jeroenweij/ClimateControl/Hardware/Damper/Assembly images/Full Bottom.png

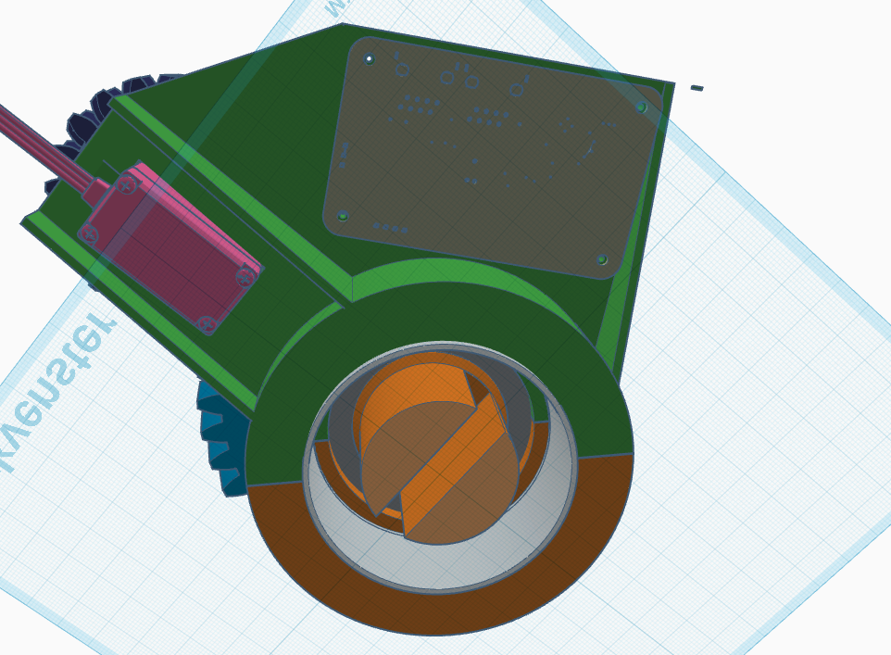
Hardware/Damper/Assembly images/Full Bottom.png
