jeroenweij/ClimateControl/Software/tools/README.md

# Factory tooling

## Provisioning a node's identity

Each `ControllerNode` / `TemperatureNode` gets a one-time 32-byte `ConfigRecord`
written to flash at `0x0800F000` (Config A page). It holds the permanent bus
address (`NodeId`) and module type; firmware only ever reads it
(`NodeLib::ConfigStore`). See `Spec/Node-Flash-Layout-and-Bootloader-Spec.md`
§6.3.

A `Thermostat` is **not** provisioned: every unit carries the same fixed record
(`nodeId = NodeLib::THERMOSTAT_NODE_ID`, module Thermostat), which the build
merges into `thermostat-full.hex`. `make -C Software flash-full MODULE=thermostat`
is the whole bench step, and `provision.py` refuses `--module thermostat`
(`Spec/ControllerNode-Thermostat-Link-Spec.md` §5.2.1).

### Per board

```
# 1. bootloader + application, once per board type (identical across units)
#    Release by default -- add BUILD_TYPE=Debug for a debug unit instead.
make -C Software flash-full MODULE=temperatureNode

# 2. identity, once per unit
Software/tools/provision.py --node-id 7 --module temperature
```

Leave out `--node-id` and/or `--module` and `provision.py` asks for them
(device menu: ControllerNode / TemperatureNode, then the node id).

To do step 1 in the same run, add `--flash-full`: once the config page is
written it runs `make flash-full` for that module (`--build-type Debug` for a
debug unit). `--no-flash-full` skips it, and with neither flag an interactive
run asks (default no). Step 1 coming after step 2 is fine: `flash-full` only
loads the bootloader + app sectors and leaves the config page alone.

`flash-full` builds into `Software/build/release/` (or `build/debug/` with
`BUILD_TYPE=Debug`) and merges bootloader + app before flashing -- see
`make -C Software help` for the equivalent `flash` (app only, no bootloader
merge) and plain `build`/`release` targets. `provision.py` itself doesn't
care which build type the board was flashed with -- it only ever touches the
32-byte config page below, never the application image.

`provision.py` builds the record, writes `config-nodeN-<module>.hex` + a J-Link
commander script, then runs `JLinkExe` to erase the config page and program it.
`JLinkExe` must be on `PATH`; with `--dry-run` (or if it is missing) the files
are written and the command is printed for you to run by hand.

Options: `--settings <hex>` (up to 16 bytes of per-node config), `--serial`
(pick a J-Link by serial number), `--out-dir` (keep the generated files),
`--force` (allow a non-bus-node module type).

### Just the blob

`gen_config_record.py` emits the record without touching hardware:

```
tools/gen_config_record.py --node-id 7 --module temperature            # Intel HEX to stdout
tools/gen_config_record.py --node-id 7 --module temperature -o cfg.hex
tools/gen_config_record.py --node-id 7 --module temperature --bin -o cfg.bin
```

The CRC-32 is a plain `zlib.crc32` — the same reflected CRC-32 the firmware
recomputes at boot (`ConfigStore::Valid`).
