jeroenweij/ClimateControl/Spec/MainController-Server-Link-Spec.md

# MainController ↔ Server Link — Design Spec

`MainController` relays `NodeLib` v2 frames verbatim between the RS485 node bus and a single LAN server; the server decodes, stores to SQLite, and serves the operator web application.

**Companion docs:** `MainController-Spec.md` §4 (NINA-W152 hardware), `RS485-Node-Protocol-Spec-STM32G030.md` §3 (frame format, reused on this link), `Node-Message-Model-Spec.md` §3–§5 (endpoints, operations, encodings — the server decodes these), `Node-Flash-Layout-and-Bootloader-Spec.md` §6 (the bus OTA sequence this link feeds).

---

## 1. Role & topology

`MainController` is bus master, supervisor, and a frame bridge to one server:

- **Bus master** — runs the `NodeMaster` discovery + round-robin poll loop.
- **Supervisor** — its own fault detection / safe-state / aggregation logic (`MainController-Spec.md` §2), running independently of the uplink.
- **Bridge** — holds one outbound TCP connection to the server and moves `NodeLib` frames across it in both directions. It does not decode endpoint payloads, hold a schema, or serialise anything; the server owns all persistent state and the UI.

```
   RS485 bus (115200, half-duplex, HW-DE)              LAN (Wi-Fi)
 ┌───────────┐  ┌───────────┐  ┌───────────┐   ┌──────────────┐        ┌──────────────┐
 │Temperature│  │Controller │  │Controller │   │ MainController│  TCP   │    Server    │
 │  Node  3  │──│  Node  5  │──│  Node  7  │───│  NodeMaster   │═══════▶│  decode + DB │
 └───────────┘  └───────────┘  └───────────┘   │  + AT bridge  │        │  + web app   │
                      │  Thermostat link        │  ── NINA ──   │       └──────┬───────┘
                      └── (local, off-bus) ─    └──────────────┘         WebSocket + HTTP
                                                                        ┌──────┴───────┐
                                                                        │   browsers   │
                                                                        └──────────────┘
```

- The socket is **outbound from `MainController`** — no inbound port or firewall exception at the building.
- **Plaintext TCP on the LAN.** Authentication is a 16-byte shared token in the first frame (`UplinkHello`, §5); the server drops any connection whose token does not match.
- The bus runs normally while the uplink is down: nodes are autonomous, each `ControllerNode`↔`Thermostat` loop is local, and the `MainController`'s supervisory logic keeps running. The uplink carries logging, monitoring, and operator control only — never a closed loop.

---

## 2. Properties of frame pass-through

| | |
|---|---|
| STM32 flash | Reuses `Frame` / `Message` / `Id` / `Crc`, already linked. No JSON writer, no schema, no per-endpoint marshalling on the MCU. |
| STM32 SRAM | Working set is one frame in + one frame out (~40 B each) plus the AT line buffer. The MCU holds no model of the building. |
| Evolution | A new endpoint or value type is a server-only change; the bridge carries it with no firmware update. |
| Single decoder | The `Node-Message-Model-Spec` decode lives in exactly one place — the server — and serves both stored history and the live UI. |

The server implements the `NodeLib` wire format (§6); it is a small, fixed, already-specified codec.

---

## 3. Transport — NINA socket

- NINA-W152 on USART2, u-connectXpress AT firmware, 115200 8N1, 4-wire hardware flow control (RTS/CTS per `MainController-Spec.md` §4) — the STM32 must hold `NinaRts` (`PA1`) low or the module never transmits.
- **Wi-Fi join:** `AT+UWSC=0,2,"<ssid>"` / `AT+UWSC=0,5,2` (WPA/WPA2-PSK) / `AT+UWSC=0,8,"<passphrase>"` configure station profile 0; `AT+UWSCA=0,3` activates it. `+UUWLE` (link up) / `+UUNU` (IP up) report readiness; `+UUWLD` / `+UUND` report loss and drive the same reconnect logic as the socket below.
- **Socket:** u-connectXpress models the server as a **peer**, not a BSD-style socket — there is no `+USOCR`/`+USOCO` family on this firmware. `AT+UDCP="tcp://<host>:<port>/"` opens it: `+UDCP:<peer_handle>` on write, then an unsolicited `+UUDPC:<peer_handle>,<type>,<flags>,<local_ip>,<local_port>,<remote_ip>,<remote_port>` once the TCP handshake completes. `ATO` then switches the UART into **data mode** — a transparent byte pipe to the connected peer — for the life of the connection. `+UUDPD:<peer_handle>` reports a close (drops the module back to command mode); `AT+UDCPC=<peer_handle>` closes it explicitly.
- The **AT engine is a non-blocking state machine** ticked from the same super-loop as `master.Loop()`: it issues one command and returns, collecting the response over later iterations. A stalled uplink never delays a bus `Poll` / `Done`.
- **Events are judged by where they end up.** URCs arrive in bursts (IP up, down, up again), so each waiting state drains every queued event and decides on the end state: a network-down that was followed by a network-up does not fail the attempt, and before the IP is up only the timeout fails the wait. The peer closing (`+UUDPD`) is always final.
- **The network is given time to settle before the peer is opened.** After `+UUNU` the module is not yet ready for `AT+UDCP` — it answers `ERROR` until a second `+UUNU` fires, 0.3–0.9 s later on the bench. The link therefore waits for a 1 s stretch with no network event (any further one restarts the wait) before `AT+UDCP`, and re-sends a command that got `ERROR` or no reply only after 500 ms rather than back-to-back, so its three attempts span the window instead of finishing inside it. Network events seen before Wi-Fi is (re)activated belong to the module's previous life — one can still arrive just after the reset line is pulled — and are discarded, so they cannot stand in for the new connection's own `+UUNU`.
- **Liveness in data mode is a decoded frame, not a byte, and a keepalive must be answered.** Once the peer is gone the module is back in command mode and can answer stray writes with text (`ERROR`, `+UUDPD`); those bytes must not keep a dead link alive. The MC sends a `Keepalive` `Get` every 10 s and the server answers each with a `Keepalive` `Report`. Only that `Report` counts as the answer: other inbound frames (an OTA transfer's writes, say) prove only that the server can still reach the MC, which stays true when the module has stopped forwarding the MC's bytes. If no `Report` arrives within 10 s of a keepalive the link is treated as dead (a dropped peer, a half-open connection, a one-way stall, or a server that is up but not answering) and the NINA is reset and re-joined — within 20 s at worst, whatever the module does or doesn't signal. A 60 s stretch with no valid frame at all is a backstop behind that.
- **Every session opens with the `UplinkHello`.** The server rejects a connection whose first frame is anything else. When a session starts, whatever was staged for the previous one (a keepalive queued as its deadline expired, frames from the moment data mode was entered) is dropped and the hello is queued first, followed by the roster.
- **Reconnect:** exponential backoff, 1 s → 30 s cap, re-triggered by `+UUWLD` / `+UUND` / `+UUDPD`. The MCU keeps no uplink send queue — a `Report` produced during an outage is dropped; the value re-reports on its next change or periodic refresh, leaving only a gap in stored history.

---

## 4. Wire format over the socket

Byte-for-byte the RS485 v2 frame (`RS485-Node-Protocol-Spec-STM32G030.md` §3):

```
SYNC(0xEE 0x42) · LEN · NODE · ENDPOINT · OPERATION · DATA[LEN] · CRC16
```

CRC-16/CCITT-FALSE over `NODE..DATA`, little-endian. `LEN` ≤ 35 (`MAX_DATA`, `RS485-Node-Protocol-Spec-STM32G030.md` §7/§9). TCP is a stream, so the server runs the same `Frame` deframer (SYNC scan → LEN → CRC) as a node; a sync loss just resynchronises. No length prefix or envelope is added.

Two frame classes share the link:

| Class | `ENDPOINT` | Meaning |
|---|---|---|
| **Relayed node frame** | `0x10`–`0x5F` | Verbatim copy of a frame on / for the bus. `NODE` is the real node id. Server `Get` / `Set` go onto the bus unchanged; node `Report` / `Ack` / `Nack` go up unchanged. |
| **Uplink frame** | `0x60`–`0x6F` | `MainController` (`NODE = 0`) ↔ server only, never on the RS485 bus. Roster, presence, keepalive, health, OTA control/data (§5). |

Transport verbs (`Discover` / `Announce` / `Poll` / `Done`) are bus-internal and not relayed. Node arrivals and departures reach the server as `NodePresence` (§5).

---

## 5. Uplink endpoint block (`0x60`–`0x6F`)

`NODE = 0`, little-endian per `Node-Message-Model-Spec.md` §5.

| Endpoint | Dir | Op | Payload | Meaning |
|---|---|---|---|---|
| `0x60` `UplinkHello` | MC→S | `Report` | `fwVersion(2) · uptimeSec(4) · nodeCount(1) · authToken(16)` | First frame after every (re)connect. Connection is dropped on token mismatch. `fwVersion = 0` identifies MainController's bootloader (it carries no version of its own; every application image has a non-zero one): the server then shows the MainController as `bootloader` with an unknown version, and treats the bus as unmanaged — every bus node reads offline, exactly as with no uplink at all — while still accepting a firmware push. |
| `0x61` `Roster` | S→MC / MC→S | `Get` / `Report` | Report: `{nodeId(1) · module(1) · state(1) · lastSeenMs(4)}`, one node per frame, `nodeId = 0xFF` terminates | Full active-node table. Streamed unsolicited after `UplinkHello` and on request. The server treats each stream as a snapshot: at the terminator, any node it has flagged online but the stream left out goes offline (dumping a roster re-seeds `MainController`'s presence tracking, so no `NodePresence` down follows for a node that dropped while the uplink was down). `lastSeenMs` is `MainController` uptime-ms at last contact (relative — the MCU has no wall clock). |
| `0x62` `NodePresence` | MC→S | `Report` | `nodeId(1) · module(1) · up(1) · bootloader(1)` | A node joined discovery (`up = 1`) or missed its heartbeat (`up = 0`); `bootloader` mirrors `Roster`'s per-node bootloader bit at the moment of the transition, for a live update between `Roster` snapshots. |
| `0x63` `ThermostatStatus` | MC→S | `Report` | `controllerNodeId(1) · linkUp(1) · blState(1) · fwMajor(1) · fwMinor(1) · uid[12]` (17 B) | The paired Thermostat behind one ControllerNode — link state + running firmware + identity. On change + slow keepalive; the MC fills it from `Get RoomLink` + `Get ThermostatFirmware`. See `ControllerNode-Thermostat-Link-Spec.md` §5.6. |
| `0x64` `Keepalive` | ↔ | `Get` / `Report` | none | Idle liveness, 10 s interval. A keepalive not answered (by any valid frame) within 10 s triggers reconnect (§3). |
| `0x65` `OtaControl` | S→MC | `Set` / `Get` | `Set`: `op(1)`, `op=1` (`Begin`) followed by `imageSize(4) · imageCrc32(4) · fwVersion(2)`; `op=2` (`Abort`), `op=3` (`End`), `op=4` (`Activate`) take no further payload. `Get`: none. | MC-self-update control channel — **only MainController's own bootloader speaks this** (`Software/Modules/MainBootloader/Firmware.cpp`), never the running app, never a bus node. See §8 step 7. |
| — | MC→S | `Ack` / `Nack` | `lastError(1)`, `0` on `Ack` | Reply to a `Set` above. |
| — | MC→S | `Report` | `state(1) · expectedOffset(4) · lastError(1) · fwVersion(2)` | Reply to `Get` — lets the server resume after a dropped uplink without resending from offset 0. |
| `0x66` `OtaData` | S→MC | `Set` | `byteOffset(2 LE) · data(≤32)` | One flash-write chunk, sent only while the bootloader is `Receiving` (after `OtaControl[Begin]`, before `[End]`). No RAM page buffer — each chunk is programmed to flash immediately, mirroring the bus `Firmware[Write]` design (`Node-Flash-Layout-and-Bootloader-Spec.md` §6.2.1). |
| — | MC→S | `Ack` / `Nack` | `byteOffset(2 LE) · chunkCrc16(2 LE) · programFailed(1)` | Reply to a chunk — echoes the offset + a flash-read-back CRC16, same correlation the bus protocol uses; a `Nack` names where the bootloader actually is so the server can resync without guessing. |
| `0x67` `MainStatus` | MC→S | `Report` | `rxFrames(4) · crcErrors(4) · resyncs(4) · txDrops(4) · downlinkDrops(4) · wifiRssi(1, int8) · freeHeap(2)` | `MainController` + bus health, ~10 s. `downlinkDrops` counts commands shed by the outbound queue (§7). |
| `0x68` `MainLog` | MC→S | `Report` | `uptimeSec(3 LE) · text(≤32)` | One line of MainController's log, pushed unsolicited (§5.1). |

Firmware pushes to a bus node do **not** go through this block — see §8. `Firmware` (`0x20`) and `ThermostatFirmware` (`0x22`) are ordinary relayed endpoints (block `0x10`-`0x50`, §4), so the server drives the OTA sequence directly against them — the MC needs no OTA-specific code for that case, since the generic relay already carries it both ways. The one target the relay can't reach is MainController itself (§8 step 7): it does not run the bus `Firmware` protocol at all, it has its own dedicated bootloader (`Software/Modules/MainBootloader/`, `Node-Flash-Layout-and-Bootloader-Spec.md` §7/§7.1) that speaks `OtaControl`/`OtaData` above instead.

### 5.1 MainController log (`MainLog`)

MainController has no hardware debug console (both USARTs are committed, `MainController-Spec.md` §5), so its log reaches the operator over the uplink instead — the same lines a bus node exposes through `DiagLog` (`Node-Message-Model-Spec.md` §3), but *pushed*, because the MC (unlike a bus node) has an always-on link to the server and nobody has to poll for it.

- **Source.** Every `LOG_*` macro goes through `Tools::Logger::Emit`, which records the line in `Tools::LogRing` — the same fixed ring every bus node has: 24 lines, each `"<level>: <message>"` truncated to 32 characters and stamped with the MC's uptime in seconds and then calls the console sink `Logger::Write`, which on the MainController is empty unless the RTT option below is enabled.
- **Push.** Once the uplink is in data mode, `UplinkHandler` moves lines from the ring into its outbound queue as `MainLog` `Report`s, at most four per super-loop pass and only while the queue is under half full, so log traffic never displaces relayed bus frames. The drain path never logs itself. Lines logged before the link is up (Wi-Fi/NINA bring-up, boot) wait in the ring and flush right after the `UplinkHello`; if the ring overflowed meanwhile the first line is `~ <n> lost`.
- **Time.** The frame carries the MC's uptime, not wall-clock time. The server places a line at `helloWallTime − helloUptime + lineUptime`, using the `uptimeSec` in the `UplinkHello` that opened the connection.
- **Server.** The server keeps the most recent 500 `MainLog` lines in memory (not in SQLite), streams each to the browser over the websocket as it arrives, and serves the buffer at `GET /api/main/log`. The **Logs** page lists the MainController next to the bus nodes and shows its log live, with no *Follow* polling.
- **When the uplink is down.** Only the ring (the last 24 lines) holds the log, and it is read once the MC reconnects — sized to hold a complete NINA bring-up (~17 lines, ~23 when it also switches Bluetooth off), so it shows why an attempt failed *if* the MC eventually connects. A unit that never connects is diagnosed with the RTT option or the bootloader-style LED codes.
- **RTT (bench backup, off by default).** The CMake option `CC_MC_LOG_RTT` (default `OFF`) compiles a minimal SEGGER RTT control block (`_SEGGER_RTT`, one up-channel, one idle down-channel; `Software/Modules/MainController/RttLog.cpp`) into `mainController` and makes `Logger::Write` write each line to RTT up-channel 0 in non-blocking skip mode (`NO_BLOCK_SKIP`: a line that does not fit in the free space is dropped whole), so it can never stall the super-loop. It needs no pin, no UART and no extra hardware beyond the J-Link already used for flashing (`JLinkRTTClient` / `JLinkRTTLogger`), and costs ~0.6 KB of SRAM for the control block and a 512-byte up-buffer when enabled — nothing when off. A bit-banged UART on a spare pin is not used: at 9600 baud it busy-waits ~1 ms per character and stalls the bus loop. PA5 (the `ONEWIRE` net) is unused on the MainController.
- **Bootloader.** `MainBootloader` has no log (`Tools::Logger` is not linked, to stay inside the 10 KB budget); it reports through its LEDs only.

### 5.2 MainController status (`NODE = 0`)

A relayed-range endpoint (`0x10`–`0x5F`) addressed to `NODE = 0` is for the MainController itself and never goes onto the bus — there is no node `0` there. `UplinkHandler` answers these for itself, in the same payloads a bus node uses (`Node-Message-Model-Spec.md` §3, built by the same `Node` helpers):

| Endpoint | Op | Answer |
|---|---|---|
| `SystemControl` | `Set` | reset to app (`1`) / bootloader (`2`), §8 step 7 |
| `SystemStatus` | `Get` | `Report`: `state` and `errorFlags` 0 (none defined for the MainController), its uptime and reset cause |
| `DiagLastError` | `Get` | `Report`: the fault that last reset it — HardFault (with the faulting PC) or watchdog — from `Hal::Fault` (`Node-Flash-Layout-and-Bootloader-Spec.md` §5) |
| `DiagReset` | `Set` | clears that fault record, `Ack` |

Anything else, or the wrong verb, is `Nack`ed. The server asks for `SystemStatus` and `DiagLastError` once each time the MainController application connects (a reset always reconnects) — not its bootloader, which answers neither. It stores the replies under node `0` in `readings` and publishes them to the browser, but keeps node `0` out of the bus-node roster; the status page shows when the MainController started, the reset cause, and the last fault, and the server logs a warning when a fault is reported.

---

## 6. Server architecture

One long-running process on a LAN host (Pi / NUC / mini-PC), under systemd. A single binary with the web UI embedded. It has four responsibilities and exposes three network surfaces on one HTTP port.

### Responsibilities

1. **Accept** the `MainController` TCP connection and validate its `UplinkHello` token.
2. **Deframe and decode** the frame stream → `{node, endpoint, operation, value, ts}`, where `ts` is the server's wall clock at receipt and `value` is decoded per `Node-Message-Model-Spec.md` §5.
3. **Persist** every `Report` that changes a value to SQLite and update a **current-state cache** (last value per `{node, endpoint}`) held in memory.
4. **Serve** the web application and **push** every value change to connected browsers.

It also tracks node presence from `Roster` / `NodePresence`, composes downlink frames for operator actions and OTA (§7, §8), and re-asserts stored overrides when a node rejoins.

### Network surfaces

| Surface | Path | Purpose |
|---|---|---|
| App bundle | `GET /`, `/assets/*` | The compiled single-page app (`index.html` + JS + CSS). Downloaded once per browser session. |
| JSON API | `GET`/`POST /api/*` | Everything that is not a live value: history queries, commands, node status, config, map setup, the firmware repository + updates (`/api/firmware*`). Request/response over SQLite + the state cache. |
| WebSocket | `GET /ws` | The live channel. On connect the server sends a full current-state snapshot; thereafter it pushes one message per value change for the life of the socket. A measurement (`RoomTemp`, `RoomHumidity`, `SupplyTemp`, `ReturnTemp`) not refreshed for 4 minutes is dropped from the live state with an `expired` message: nodes stop sending a reading they no longer have rather than marking it invalid, and a live one repeats at least once a minute. |

### Data flow — a node value reaching the browser

```
NINA TCP socket → deframe → decode → ┬→ SQLite  readings row
                                     ├→ current-state cache
                                     └→ WebSocket broadcast → every open browser → re-render the one changed element
```

End-to-end latency (node `Report` → browser update) is sub-second on the LAN.

### Browser application

A single-page app. After the initial bundle load it runs entirely client-side:

- Opens `/ws`, applies the initial snapshot, and renders the map and tables with no loading state.
- Applies each incremental `{node, endpoint, value, ts}` push to the single affected element — no reload, no polling.
- Calls the JSON API for non-live actions: history graphs (`GET /api/readings?node=&endpoint=&from=&to=`), overrides (`POST /api/commands`), the firmware repository + updates (`GET/POST /api/firmware`, `POST /api/firmware/update[-all]`), map edits (`POST /api/map/*`).
- Command outcomes (`Ack` / `Nack` / the resulting `Report`) return over the same WebSocket, so every UI update flows through one path.

The operator pages (§7) and the map-setup page are routes within this one app.

### Database (SQLite)

```
nodes(id PK, module, uid, fw_version, first_seen, last_seen, state)  -- fw_version from SystemInfo
readings(ts, node_id, endpoint, raw BLOB, value_num, value_text)   -- indexed (node_id, endpoint, ts); the last rawRetentionDays
readings_hourly(node_id, endpoint, hour, min, avg, max, n)         -- numeric history beyond that, one row per series-hour, kept for good
readings_rollup(node_id, endpoint, rolled_to, last_ts, last_num)   -- per-series rollup progress + the value holding at rolled_to
commands(ts, node_id, endpoint, operation, payload, user, sent_ts, ack_ts, result)
ota_jobs(id PK, node_id, target, filename, size, crc32, fw_version, module, started, finished, state, last_offset, error, image_path)
                                                                   -- target 'node'|'thermostat'; state 'queued' until the single-flight driver picks it up
firmware_images(module PK, filename, version, size, crc32, uploaded_ts, image_path)  -- one held image per module; version = major<<8|minor, parsed from the filename
thermostats(controller_node_id PK, uid, fw_version, bl_state, link_up, last_seen)    -- from 0x63 ThermostatStatus
config_overrides(node_id, endpoint, value, user, ts)               -- re-asserted when the node rejoins
map_floors(id PK, name, image_path, width_px, height_px)
map_placements(node_id, floor_id, x_px, y_px, poly_json NULL)      -- one row per ControllerNode
```

**Readings history.** The stored history is step-shaped: each row's value holds until the next row. A node re-reports every published value about once a minute as a keepalive (`Node-Message-Model-Spec.md` §6); a report whose raw bytes equal the series' last stored row is not stored unless that row is 30 minutes old, so rows are the changes plus at least two per hour while the node is reporting. The last-stored cache is in memory, so each series stores one extra row after a server restart.

Rows are kept as is for `rawRetentionDays` (config, default 30). An hourly job (and one pass at start-up) folds everything older — up to the hour boundary at or below now − retention — into `readings_hourly` and deletes it, one day of one series per transaction so the uplink's inserts are never held off for long. Per hour: `min` / `max` over the values present in it, `avg` weighted by how long each value held, `n` the raw rows inside it. A value holds until the next row or for one hour at most — a reporting node leaves a row every 30 minutes, so a longer silence is the node being gone, and an hour with no known value gets no row. `readings_rollup` records per series how far it has been rolled and the last value before that point, which still holds into the next pass's first hour; each chunk's hourly rows, deletions and progress commit together, so an interrupted pass neither loses nor repeats an hour. Only numeric rows (`value_num` set; enums included, where only `min`/`max` mean anything) are rolled up; text / struct rows such as `SystemStatus` are dropped with the rest. The hourly table is kept indefinitely — about one row per series-hour, so a building's worth of nodes adds on the order of 100 MB a year. SQLite reuses the freed pages, so the file levels off at about one retention window of raw rows rather than shrinking.

`GET /api/readings` returns a series newest first: the raw points in range, then the hourly points further back (`num` = the hourly mean, with `min` / `max` / `n`).

### Frame codec

One server-side module implements the `NodeLib` wire format: the `Frame` deframer (SYNC scan → LEN → CRC-16/CCITT-FALSE → `{node, endpoint, operation, data}`) and the matching encoder for downlink frames. Endpoint payload decoding is a table keyed by endpoint, following `Node-Message-Model-Spec.md` §5.

---

## 7. Operator pages

| Page | Server | Frames on the link |
|---|---|---|
| **Building map** — floor plan, live per-room temperature (§7.1) | renders from the state cache, live-updates over `/ws` | none beyond the node `Report`s already arriving |
| **Overrides** — change setpoint / damper mode / any writable endpoint | composes `Set <node> <endpoint> <value>`; writes `config_overrides` for the held endpoints only (below) | downlink `Set` → node `Report` / `Ack` → cache + push |
| **Status** — per-node module / fw / live values (damper as `actual → target` while a move hasn't landed) / faults / bus counters | shows `SystemInfo` / `SystemStatus` / `DiagRxCounters` / `MainStatus`; the **Fault** column shows the node's active `errorFlags` by name, and after they clear the last one raised with its time (kept in server memory, not persisted) | pushed `SystemStatus` on change; on-demand `Get` downlink |
| **Logs** — one log view per node: the MainController's live, a bus node's read on demand or followed | MainController: the in-memory `MainLog` buffer + `/ws` push (§5.1); bus node: drains its `DiagLog` ring | MainController: none beyond the pushed `MainLog` `Report`s; bus node: `Get DiagLog` downlink, one per line |
| **Firmware** — installed version per node (+ a row per Thermostat), the held image per module, per-node / "update all" push | `SystemInfo` fw + `0x63` + `firmware_images`; accepts a `<Module>_<major>.<minor>.bin` | single-flight OTA queue, OTA sequence (§8) |
| **Map setup** (separate config page) | per-floor floor-plan image upload; click to place each `ControllerNode`; optional room outline, traced by flood fill from a seed point on the plan or drawn as a manual polygon | none |

When a node rejoins, the server re-applies any matching `config_overrides` (a rebooted node returns at defaults). Only the damper overrides (`DamperTarget`, `DamperMode`) are held. Settings a node persists in its own flash (`DumpRoom`, the calibration offsets) are sent once and not held, and so is `RoomSetpoint`: the Thermostat is its source of truth and its buttons change it, so a held value would only fight them. Each room's setpoint field starts at the reported setpoint and can be sent any number of times. The held damper overrides follow the node's own rule that a `DamperTarget` Set means Manual: holding a target also holds `DamperMode` = Manual, and holding any other mode drops the held target — so re-applying them (target first, by endpoint order) can't contradict itself.

### 7.1 Building map render

- Each **`ControllerNode`** is one placed point, coloured by its relayed `RoomTemp` (`0x41`), labelled `RoomTemp / RoomSetpoint` (`0x40`), with `RoomMode` (`0x43`) and `RoomLink` (`0x44`) as badges.
- **`TemperatureNode`s** are duct sensors (`SupplyTemp` / `ReturnTemp`) near the outside unit — shown in a fixed readout on the map or status page, not placed on the plan.
- The plan is an uploaded image; the live layer is an **SVG overlay rendered in the browser**. Per node, at its `(x_px, y_px)`:
  - default — a marker plus a soft radial-gradient blob, room-sized radius, colour from a temperature ramp (blue 16 °C → green 21 °C → red 26 °C); overlapping blobs blend into a heatmap.
  - if `poly_json` is set — fill that polygon at ~30 % opacity for a crisp room boundary.
- Multi-floor buildings have one `map_floors` row per floor and a floor switcher on the page.
- The temperature ramp and thresholds are server-side UI config.

### 7.2 Downlink rate discipline

The bus is a round-robin poll cycle into which the master injects its own `Set`s. Rapid UI writes (a slider drag) could back up that injection and starve the poll cycle. Two layers bound it:

- **Server** — debounce per `{node, endpoint}` (send only the latest value after a ~200 ms settle) and cap total downlink at ~10 `Set`/s.
- **`MainController`** — a bounded outbound-to-bus queue (~8 frames); on overflow it drops and increments `downlinkDrops` in `MainStatus`. The uplink never delays a bus `Poll` / `Done`.

---

## 8. Firmware update

Drives the bus OTA sequence in `Node-Flash-Layout-and-Bootloader-Spec.md` §6 **directly** — `Firmware` (`0x20`) is an ordinary relayed endpoint (§4), so the server is the one running this state machine, addressing the target node id over the socket exactly like any other `Set`/`Get`. The MC does no OTA-specific translation for this path; it's the same generic relay it already does for `SystemInfo`, `DamperTarget`, etc.

1. Operator uploads `<module>.bin` on the Status page. The server validates the `ImageDescriptor` (magic, module, size) and computes the CRC-32.
2. Server → bus (relayed): `Set Firmware[EnterBootloader]` addressed to the target node id (the app parks outputs, sets the backup magic, resets — `INodeHandler::PrepareForReset`). Server then polls `Get Firmware` on that node id until it gets back any `Firmware Status` Report — only the bootloader ever sends one, the running app only `Ack`/`Nack`s `Firmware`, so any reply confirms the reset landed.
3. Server → bus: `Set Firmware[Begin] {module, imageSize, imageCrc32, fwVersion}`; the node erases its app slot and reports `bl-receiving`.
4. Server streams `Set Firmware[Write] {offset(2 LE), bytes=32}` with 4 chunks in flight (go-back-N, `otaNodeWindow`), each answered by that write's own `Ack`/`Nack` (echoing the offset + a flash read-back CRC16) rather than a generic `Firmware Status` Report — the reply is tied to the specific write (`Node-Flash-Layout-and-Bootloader-Spec.md` §6.2). Acks are cumulative; a `Nack` names the offset to resync to; no progress for the write timeout resends from the oldest unacked chunk. Keeping several chunks in flight keeps the uplink busy — one chunk per ~140 ms round trip is the cadence at which the NINA stops forwarding (§11 item 1) — and roughly quadruples throughput (~300 B/s on the bench). A Thermostat push stays at one chunk in flight: its ControllerNode relays one at a time. Delivery still rides the target's normal poll window.
5. At `imageSize`: `Set Firmware[End]` → poll for `bl-valid` → `Set Firmware[Activate]`. The node clears its magic, resets into the new app, re-announces; the server reads the new `fwVersion` from `SystemInfo`.
6. **Thermostat target** — same steps 3-5, but addressed to `ThermostatFirmware` (`0x22`) on the *owning ControllerNode's* node id instead of `Firmware` on the target's own id, and step 2 is skipped: `ThermostatFirmware[Begin]` does the `EnterBootloader` + bootloader-wait itself, CN-side (`ControllerNode-Thermostat-Link-Spec.md` §5.4).
6a. **A bus push survives the uplink going quiet.** The bus node (or the Thermostat behind a ControllerNode) is untouched when the module stalls and the MainController resets its NINA, so it keeps everything it has received. When a chunk stays unanswered through its retries the server waits for the uplink to return (up to 120 s), probes `Firmware[Get]` (`ThermostatFirmware[Get]` for a thermostat push) and continues from the `expectedOffset` the bootloader reports. A bootloader holding no transfer (`Idle`: it restarted) is sent `Begin` again and the image starts over; a node that answers nothing for 90 probes is presumed to have booted its application and is sent `EnterBootloader` and `Begin` again (not for a thermostat push, whose `Begin` does that CN-side). Bus pushes send one chunk at a time; acks ride the bus poll cadence, so the window used for the MainController's own update does not apply.
7. **`targetNodeId == 0`** — MainController self-update, a different mechanism entirely, **not** an extension of steps 1-6. Not reachable via any relay (the MC doesn't relay to itself). The server first parks the running app in its bootloader with `SystemControl[Set] {2}` addressed to `NODE=0` — the app's `UplinkHandler` handles a `NODE=0` `SystemControl` itself instead of relaying it onto the bus; it Acks, sets the backup-register magic and resets. The bootloader (`Software/Modules/MainBootloader/`) dials the uplink back out itself, sends a fresh `UplinkHello`, and answers `OtaControl[Get]` with a status `Report` — the server polls for that (any report proves the reset landed; the running app ignores `OtaControl`). Then server → `OtaControl[Begin]` → `OtaData` chunks (each acked, same offset-resume semantics as the bus's `Firmware[Write]`; up to 4 in flight at once, go-back-N: an ack for a chunk also covers every chunk before it, a `Nack` names the offset to restart from — repeats of it are ignored briefly, since one loss draws a `Nack` from each chunk sent behind it — and no ack progress for 3 s resends from the oldest unacked chunk) → `OtaControl[End]` (verifies) → `OtaControl[Activate]` (resets into the new app), all addressed to `NODE=0` on the uplink block itself (§5). The uplink drops when the app resets into the bootloader and again during `Activate`'s reset, reconnecting each time with a fresh `UplinkHello` (the bootloader's reports `fwVersion = 0`). A transfer also survives the link going quiet: the module can stop forwarding the MC's bytes for tens of seconds, after which the MC resets the NINA and reconnects while its bootloader keeps everything received so far. When a chunk stays unanswered through its retries the server waits for the uplink to return (up to 120 s), probes `OtaControl[Get]`, and continues from the `expectedOffset` it reports; a bootloader that has lost its state (`Idle`) is sent `Begin` again and the image starts over. An ack is matched to the chunk by offset, so a late ack for an earlier chunk is ignored. The server driver is `Webserver/internal/service/ota_main.go`.

The STM32 working buffer for this is small: a `Write` payload is 35 B (`MAX_DATA`, `RS485-Node-Protocol-Spec-STM32G030.md` §7), and the bootloader stages no RAM page buffer at all — each `Write` is programmed to flash immediately.

---

## 9. STM32 code / RAM budget

| Piece | Flash | SRAM |
|---|---|---|
| AT command / response / URC engine | ~2–3 KB | ~0.3 KB line buffer |
| Socket bridge (open / reconnect / two `Frame` pumps) | ~1–2 KB | ~0.1 KB |
| `0x60` block handlers (roster, presence, keepalive, status) | ~1 KB | — |
| `MainLog` drain (§5.1) + the MC-sized log ring | ~0.3 KB | ~1.1 KB (32 × 32 B lines + stamps) |
| **Total** | **~4–6 KB** | **< 1 KB** |

Firmware pushes cost the MC nothing beyond the generic relay it already has — no separate OTA glue line item (§8).

`Frame` / `Message` / `Id` / `Crc` / `NodeMaster` are already linked.

---

## 10. Failure modes

| Event | Behaviour |
|---|---|
| Uplink down | Bus and supervisory logic keep running. The MainController's error LED is on steady until the uplink is back. `Report`s during the outage are lost, not queued. On reconnect: `UplinkHello` → server pulls `Roster`, issues `Get`s to refill the state cache, re-asserts `config_overrides`. The refill asks for each module's state endpoints (`service/refill.go`): on a `Roster` entry only those the cache has no value for (this also covers a restart of the server itself, whose cache is memory-only), on a `NodePresence` up all of them. The `Get`s are paced ~25 ms apart so the MainController's 25-deep bus queue isn't flooded. |
| Server restart | Same as uplink down, from the MC's view. |
| NINA wedged | AT watchdog: no URC / `OK` within a timeout → `RESET_NINA` pulse (PA6, open-drain) → re-init → reconnect. |
| Node drops mid-OTA | The node's app slot is invalid → its bootloader stays resident → `NodePresence` down then up → server retries from `ota_jobs.last_offset`. |
| Bad frame on the socket | Dropped by `Frame` CRC / resync, same as on the bus; counted in `MainStatus`. |
| Out-of-range override | Node replies `Nack`; server shows the reason and does not persist the override. |

---

## 11. Open items

1. **The NINA stops forwarding UART bytes to TCP now and then** — a failure of the module itself, seen on the bare module with no MainController (a PC as server, an adapter on the module's TXD/RXD; rig: `Software/tools/nina_stall_test.py`): the module keeps acknowledging what the server sends and delivers it to the UART, but stops passing what arrives on its UART to the peer, for seconds to minutes until it is reset. It showed up when traffic crosses the module with gaps of about 120 ms or more (request periods of 130–250 ms stalled, most runs within ~2 minutes at 130 ms; 30–110 ms did not), which is the cadence of a stop-and-wait OTA transfer. UART flow control and Wi-Fi power save are not the cause. The same rig, on the same module and firmware (u-connectXpress 6.4.1), no longer reproduces it: 130/160/200/250 ms for 5 minutes each with Bluetooth off and again with it on, plus one unbroken hour at 130 ms with it off (about 41,000 requests in all), gave no stall. So the trigger is still unidentified, and nothing shows whether turning Bluetooth off (`NinaLink` stores `AT+UBTMODE=0` on first bring-up, since u-connectXpress lists Wi-Fi and Bluetooth running together as a cause of disconnections and increased latency) or something in the Wi-Fi environment made it go away. Bluetooth stays off regardless. The link copes if it does come back (an unanswered keepalive resets the NINA within 20 s, and the transfer resumes, §3, §8), but each stall costs a retry or a reconnect. The OTA transfer keeps several chunks in flight (§8 step 7), so the link stays busy and that cadence is avoided in any case. A second failure mode shows up around those resets: the module sometimes boots (`+STARTUP`) and then answers no `AT` at all; only another reset brings it back. `NinaLink` therefore gives the post-reset `AT` probe ~20 s (10 attempts) before resetting the module again, rather than probing indefinitely — unbounded, one such boot kept the uplink down for 7½ minutes.
