jeroenweij/ClimateControl/Spec/Node-Bus-Hardware-Design-Spec.md

# Node Bus — Hardware Design Spec
### Power, connector, and node-schematic decisions for the STM32G031F8P6 RS485 node network

**Companion doc:** `RS485-Node-Protocol-Spec-STM32G030.md` (wire protocol / framing / CRC — this doc is physical layer only)

---

## 1. Topology overview

- 1 master + up to 22 slave nodes (`NodeLib::MAX_NODES`) on a single half-duplex RS485 bus: 21 ControllerNodes and 1 TemperatureNode.
- Physical medium: standard 8-conductor Ethernet patch cable, daisy-chained node-to-node (each node has an "in" and "out" RJ45).
- One cable carries **power, RS485 data, and two control lines** simultaneously — no separate power harness for the common case.
- RS485 data pair runs as one continuous bus end-to-end. **Power is injected at multiple points along the chain, not solely from the master end** — see §4.

---

## 2. Bus voltage: 48V (PoE-class)

The shared power rail runs at 48V DC, stepped down locally at each node to 5V (servo) and 3.3V (MCU).

**Why 48V over 12V/24V:**
- Cable/connector current scales as `I = P / V`. At a fixed servo power draw, 48V draws **1/4 the current of 12V** and **1/2 the current of 24V** for the same delivered power — this is what makes the RJ45 connector current budget (§4) workable at all with 21 servo nodes on one chain.
- Directly comparable to established PoE practice (802.3af/at/bt operate in this voltage class for exactly this reason).

**Consequence — hot-plug inrush:** higher rail voltage means more energy dumped into each node's input bulk capacitor on connection. Addressed by keeping that bulk cap small (47µF) rather than adding an NTC or soft-start MOSFET — see `Node-Bus-Power-Path-Spec.md` §2/§3.

**Consequence — regulator selection:** the 5V rail needs a wide-input **synchronous buck** (not LDO — at 48V→5V an LDO would dissipate ~90% of input power as heat). The 3.3V rail can be a simple buck or LDO fed from the already-regulated 5V rail.

---

## 3. Frame/pin assignment (per RJ45, T568 pairing)

| Pins | Pair (color) | Assignment | Notes |
|---|---|---|---|
| 4, 5 | Blue (center pair) | **RS485 A/B** (differential) | Center pair chosen for tightest coupling of the four pairs and maximum physical separation from both power pairs |
| 1, 2 | Orange | **V+ (48V, bonded)** | Both conductors bonded in parallel — halves effective resistance per rail vs. a single conductor |
| 7, 8 | Brown | **GND return (bonded)** | Symmetric with V+ pair, opposite outer edge of the connector |
| 3, 6 | Green | **ENABLE** (bonded, both wires) | One control line — no separate `NRST` bus (see below). Both green conductors bonded together for ENABLE, same halved-resistance rationale as the V+/GND pairs. |

**ENABLE line:** master-driven only, single driver, no contention — feeds each node's buck-converter EN pin (see `Node-Bus-Power-Path-Spec.md` §5). **Enabled is the default state; the master only ever pulls the line low, to disable.**

**Drive scheme: one pull-up per node, one pull-down at the master.** Each node pulls the ENABLE net up to its *own local 48V rail* through a high-value resistor. The master has a single low-side N-MOSFET that pulls the whole net to GND to disable every node at once. There is no pull-up at the master. A node holds itself enabled from its own 48V and GND, so the shared line — and any IR drop or ground offset along it — never sets the "enabled" level; only the disable edge travels the wire, carrying just the ~1mA total pull-up current, so drop along the ENABLE conductor is a few mV and irrelevant.

| Component | Where | Value | Part | Notes |
|---|---|---|---|---|
| Pull-down MOSFET | master | onsemi BSS123 (N-ch) | LCSC C513249 | SOT-23, 100V Vds (margin over 48V), Vgs(th) 1.7V (full turn-on from a 3.3V GPIO), 170mA (vs. ~1mA needed) |
| Gate series resistor | master | 330Ω | commodity | |
| Gate pull-down resistor | master | 10kΩ | commodity | Holds the MOSFET off if the master GPIO floats at boot → line not pulled low → **bus stays enabled** |
| ENABLE pull-up | each node | **1MΩ** | LCSC `C17927` (`1206W4F1004T5E`, 1206 thick-film, 200V, 250mW, ±1%) | To the node's local 48V input. ~48µA/node; ~0.96mA / ~46mW across a full 20-node bus. Feeds the buck EN pin through a 10kΩ series + 100nF-to-GND filter (~1ms, noise rejection). The filter cap sits at the full ENABLE voltage (~48V), so it must be rated **≥100V**: `CL21B104KCFNNNE`, LCSC `C28233` (0805 X7R). |

**Pull-up value — 1MΩ per node.** Across 20 nodes this parallels to ~50kΩ: ~0.96mA total draw, and a ~0.5ms enable-edge RC against ~10nF of bus capacitance — fine for a slow control line. Lower values just waste power; higher values get noise-sensitive for little gain. The full 48V sits across the pull-up whenever the line is held low, so the resistor's package voltage rating (not its value) is the real constraint — the selected 1206 part is rated 200V.

**Receiving end:** the LMR16030 EN pin tolerates 0–60V with a ~1.2V threshold (datasheet §6.1/§6.5), so no protection is needed. A per-node RC + Schmitt filter is cheap transient-noise insurance but not load-bearing.

**Why no separate RESET line:** power-cycling a node via ENABLE also resets its MCU, making ENABLE a strict superset of a dedicated `NRST` bus — the only thing lost is resetting the MCU *without* dropping node power, which isn't needed here (not battery-powered; the fuse/inrush design already tolerates power-cycling).

**Hard-wired through:** ENABLE passes straight through each node's in/out RJ45, not buffered or re-driven by the MCU, so a master kill works even against hung firmware. Trade-off of the per-node pull-up: if the ENABLE conductor breaks mid-chain, downstream nodes self-enable and the master loses kill authority over that segment — unlikely, since the bonded green pair shares the RJ45 with power, so such a break usually drops that segment's power anyway.

**Note on pair-selection rationale:** at RS485 baud rates, inter-pair crosstalk is not the primary concern this layout solves — that matters far more at gigabit-Ethernet speeds. The real reason to keep the RS485 pair away from the power pairs is broadband switching noise from each node's buck regulator; good decoupling at each node's power input matters more here than which physical pair carries which signal.

---

## 4. Connector current budget — the constraint that shapes the power topology

**Problem:** in a pure daisy chain, the cable segment nearest the master carries the *cumulative* current of all downstream nodes, not just the local node's draw. RJ45 contacts on generic shielded jacks (see §5) are rated **1.5A per contact**; bonding two contacts per rail (as in §3) gives roughly **2–3A of safe headroom per hop** at the head end.

**Servo:** the damper actuator is a DSSERVO `DS3225`, 25 kg·cm metal-gear digital servo (coreless, "waterproof" housing, ~40×20×40.5 mm, 67 g, 180° version). Per the supplier's own spec sheet: operating voltage 4.8–7.2V, stall current 2.2–2.6A @5.0V → 2.8–3.2A @6.8V. At this design's actual 5.0–5.5V working point that interpolates to **~2.6–2.8A/node** working stall current. Run it at this board's existing 5.0–5.5V rail, not higher — the ceiling is the shared-rail LDOs downstream (`Node-Bus-Power-Path-Spec.md` §3), not the servo.

**Linkage:** the servo drives the damper blade (a Lindab DRU, mounted and driven as in `Damper-Mechanics-Spec.md`) through a **2.1:1 reduction** (20 : 42 printed gears): the full servo travel, 0–180° (0–100 %, 500–2500 µs), becomes ≈ 86° of blade travel. The mechanics alone set the end points: at 0 % the blade still leaves a minimum ventilation gap, and at 100 % it stops short of fully open, so the servo never runs into a hard stop at either end. Firmware therefore has no per-unit trim or software end stops (`Modules/ControllerNode/Damper.h`); a stall reported anywhere in the range means a mechanical fault, not an end point.

**At 48V, converted from 5V-side servo current** (`I_bus = P_load / (V_bus × η)`, η ≈ 0.85–0.90 for a synchronous buck):

| Scenario | 5V-side total (21 ControllerNodes) | Actual 48V bus current |
|---|---|---|
| All servos running normally | ~12.6 A | **~1.5 A** |
| All 21 servos stalled simultaneously (worst case) | 21 × 2.7A ≈ 56.7 A | **`(56.7A × 5V)/(48V × 0.875) ≈ 6.75A`** |

Split across the both-ends power injection (mitigation below) that's **~3.4A at each injection point** — at or just past the top of the "~2–3A safe headroom per hop" a bonded-pair connector gives.

**Decision:**
- Normal operation (~1.5A) is comfortably within a bonded-pair connector's safe range — no special handling needed for the typical case. The servo is per-node power-gated (`Node-Bus-Power-Path-Spec.md` §3.1), so both rows above are *transients* bounded by how many dampers move at once; the resting bus current is ~22 × (MCU + transceiver) ≈ tens of mA. The both-ends feed below is headroom for a coordinated multi-damper move.
- Worst-case simultaneous full-stall (~6.75A) can exceed the ~2–3A single-hop connector budget.
- **Mitigation: power injection at both ends of the chain**, not multi-point injection every 4–5 nodes. With the bus length ~100m, feeding both ends splits each node's return current toward whichever end is electrically closer, cutting the worst-case IR drop to roughly 1/4 of the single-end-fed case — see §6 for the RS485 common-mode margin this resolves. Requires an actual physical power connection at the far end of the run (a second supply there, or a dedicated feed cable back to the master). RS485 stays a single continuous bus end-to-end regardless — only the power pairs need the second feed point.
- **Regardless of the above, every node gets a fuse or PTC on its 48V input** — cheap insurance against a single node fault pulling down the shared rail, and it caps that node's worst-case contribution to bus current.

---

## 5. RJ45 connector part

**Hong Cheng HC-WK88-H18-B — LCSC/JLCPCB part C7501838**

| Spec | Value |
|---|---|
| Type | 8P8C (RJ45), single port |
| Magnetics | **None** — plain 8-pin pass-through, no transformer/coil circuitry (a magnetics/transformer jack would block DC power and distort RS485) |
| Shielding | Yes, metal shell (stainless steel) |
| LED | None |
| Mount | Through-hole, right-angle |
| Current rating | 1.5A per contact — matches the connector current budget §4's calculations are based on |
| Voltage rating | 125 VAC RMS (comfortably above the 48V DC bus) |

Two of this same part are used per node (one "in," one "out"), per §1 — using one part number for both keeps the footprint/BOM simple.

**Fallback:** C7501830 (Hong Cheng HC-WK88-H132-55B) — same electrical spec, a different housing variant in the same series, not footprint-interchangeable with C7501838.

Tie the shield to chassis/earth ground rather than signal ground if a separate protective earth is available.

---

## 6. Node core schematic — STM32G031F8P6, transceiver, indicators

This section is the reusable node front-end: MCU support parts, the RS-485 transceiver, status LEDs, and the reset/user buttons. Application-specific pins (servo PWM, sensor front-ends, the `ControllerNode`↔`Thermostat` link) are left to the module specs.

**MCU: STM32G031F8P6.** TSSOP20, 64 MHz Cortex-M0+, 8 KB SRAM, 64 KB flash (room for a bus-resident DFU bootloader + the MainController's NINA-W152 driver), `LPUART1`, `RTC` + backup registers (a wear-free "enter bootloader" flag, and an optional wall-clock if an LSE crystal is fitted), `TIM2` (32-bit), 7 DMA channels. HAL device define `STM32G031xx`. Footprint stays compatible with STM32G031F6P6 (32 KB) as a cost-down fallback.

### 6.1 STM32G031F8P6 support components

TSSOP20: a **single combined `VDD/VDDA` pin (4)** and **single `VSS/VSSA` (5)** — no separate analog supply, no `VREF+` pin (ADC reference is `VDD` directly).

| Net | Parts | Notes |
|---|---|---|
| `VDD` (pin 4) | 100 nF + 1 µF at the pin, plus 4.7 µF bulk on the local 3V3 rail | Standard STM32G0 decoupling; keep the 100 nF loop tight. |
| ADC reference | (none — it's `VDD`) | Matters for `TemperatureNode` if NTC-into-ADC is chosen: LDO ripple sets the temperature noise floor. Consider AP2112 (`C51118`) over XC6206 there. |
| `NRST` (pin 6) | cap to GND + reset button (§6.4) — 100 nF on the MainController, 10 nF on the ControllerNode and Thermostat | Internal ~40 kΩ pull-up present — no external pull-up. Both work for noise filtering and the button; 100 nF is ST's guideline value. |
| `BOOT0` | nothing | Shares the `PA14`/SWCLK pad. Factory `nBOOT_SEL = 1` → boot source is the option byte, pad free as SWCLK, boots from flash. |
| Clock | **HSI16 only, ×4 by the PLL** | No crystal. The applications run SYSCLK/HCLK/PCLK at **64 MHz** — HSI16 through the PLL (×8 ÷ 2), 2 flash wait states (`Hal::System::ClockTo64MHz()`) — except the Thermostat's, which stays at 16 MHz to keep heat off its room sensor (`ControllerNode-Thermostat-Link-Spec.md` §4); the bootloaders stay at 16 MHz, and both the bootloader→app jump and any reset return to it. The PLL does not change the accuracy, which is the HSI16's own: it is ±0.75% trimmed, ±1%/0–85°C, ±2% at −40°C — fine for the bus: an indoor duct/wall sees ~10–40°C where HSI16 holds ≈±1%, so two nodes are ~±2% apart, inside the async-UART framing budget. That budget is a percentage of the bit period, so it holds equally at any baud rate; the bus rate (115 200) is set by signal-integrity margin instead (`RS485-Node-Protocol-Spec-STM32G030.md` §2). 115200 is not an exact integer divisor of the USART clock at either speed (64 MHz/115200 ≈ 555.6 → BRR 556 in the applications, 16 MHz/115200 ≈ 138.9 → BRR 139 in the bootloaders and the Thermostat; both ≈115108 Hz, ≈0.08% generator error) — negligible next to the HSI16 spread itself. Pins 2/3 (`PB9/PC14-OSC32_IN`, `PC15-OSC32_OUT`) can instead take a **32.768 kHz LSE crystal** for the G031 RTC (wall-clock for MainController schedules). On the MainController board `PB9` is the bus-disable output (`RESET_NODES`), so LSE there would need it relocated; on Node/Thermostat boards pins 2/3 are free. Footprint LSE **DNP** on all boards for now. |
| SWD | 5-pin header: `3V3` (Vtref), `SWDIO`=PA13 (18), `SWCLK`=PA14 (19), `NRST` (6), `GND` | No caps on SWDIO/SWCLK. Cortex-M0+ has no SWO/ITM — see §6.5. |

### 6.2 Pin assignment (TSSOP20)

USART1 on port B + PA12, no SYSCFG pad remap needed:

| Pin | Name | Node-core use |
|---|---|---|
| 1 | PB7 | **USART1_RX** (AF0) ← transceiver RO  (Thermostat: **I2C1_SDA** AF6) |
| 2 | PB9/PC14 | free — or **RESET_NODES** bus-disable output (MainController); LSE xtal DNP |
| 3 | PC15 | free (LSE xtal DNP) |
| 4 | VDD/VDDA | 3V3 |
| 5 | VSS/VSSA | GND |
| 6 | NRST | reset button + cap (§6.1) |
| 7–13 | PA0–PA6 | **application** — see per-board split below |
| 14 | PA7 | **activity LED** |
| 15 | PB0…/PA8 mux | **error LED** |
| 16 | PA11 | **user button** (`ErrorHandler` ack) |
| 17 | PA12 | **USART1_DE** (AF1) → transceiver DE+/RE |
| 18 | PA13 | SWDIO |
| 19 | PA14 | SWCLK |
| 20 | PB3/4/5/6 mux | **USART1_TX** = PB6 (AF0) → transceiver DI  (Thermostat: **I2C1_SCL** AF6) |

Pins 1, 15 and 20 each bond several GPIO pads to one physical pin — configure exactly one and leave the rest at reset default (analog-in). Pins 16/17 (`PA11[PA9]`/`PA12[PA10]`) can be remapped to PA9/PA10 via `SYSCFG_CFGR1` `PA11_RMP`/`PA12_RMP`; this plan does not use that.

**Per-board use of pins 7–13 (PA0–PA6):**

| Pin | MainController | ControllerNode ("Node" board) | TemperatureNode | Thermostat |
|---|---|---|---|---|
| 7  PA0  | USART2_CTS (AF1) ← NINA RTS | **servo stall-current sense** (`ADC_IN0`, `Node-Bus-Power-Path-Spec.md` §3.1) | — | — |
| 8  PA1  | USART2_RTS (AF1) → NINA CTS | link DE (AF1) | — | link DE (AF1) |
| 9  PA2  | USART2_TX (AF1) → NINA | link TX (USART2, AF1) | — | link TX (USART2, AF1) |
| 10 PA3  | USART2_RX (AF1) ← NINA | link RX (USART2, AF1) | — | link RX (USART2, AF1) |
| 11 PA4  | — | free (bit-bang debug-TX candidate) | 1-Wire #2 | — |
| 12 PA5  | — | **servo enable** (GPIO out, off by default — `Node-Bus-Power-Path-Spec.md` §3.1) | 1-Wire #1 | — |
| 13 PA6  | NINA RESET_N (open-drain out) | servo PWM (TIM3_CH1, AF1) | — | — |

MainController + TemperatureNode are two populate variants of one PCB (the 48V injection front-end and NINA are DNP on the TemperatureNode build, the 1-Wire front-end DNP on the MainController build). MainController has no spare hardware UART for a debug console (USART1 = bus, USART2 = NINA). The G031's `LPUART1` does not help: on TSSOP20 its TX/RX only reach PA2/PA3 (the PB10/PB11 and PC0/PC1 options are not bonded), i.e. the same pins as USART2. Its log goes to the server over the uplink instead (`MainLog`, `MainController-Server-Link-Spec.md` §5.1), with SEGGER RTT over the SWD header as a bench option — no pin needed.

> **Firmware:** the pin map lives in `Software/Lib/Board/BoardPins.h` (single source of truth). `Hal::UartPins` carries a per-pin AF (`Board::BusUart` = PB6/PB7 at AF0, PA12 at AF1). Pin 15's error-LED pad is picked as **PB0** — configure only that one.

### 6.3 RS-485 transceiver

**Part: THVD2410DR (TI)** — LCSC `C1849398`, SOIC-8. ±70 V fault-protected half-duplex RS-485, 3.0–5.5 V supply (run at 3.3V), 500 kbps, −40…+125°C, ±25 V receiver common-mode range, ±16 kV HBM / ±12 kV IEC 61000-4-2 contact and air ESD on the bus pins, 1/8 unit load, receiver fail-safe (logic high with the inputs open or shorted). A 3.3V supply is required: the RO output swings to the transceiver's VCC and drives the MCU RX pin directly. Standard MAX485/MAX3485 SO-8 pinout (`1 RO · 2 /RE · 3 DE · 4 DI · 5 GND · 6 A · 7 B · 8 VCC`). 500 kbps covers the 115 200 bus baud and both fallbacks (250 000, and 500 000 at the part's limit).

**Why fault-protected:** an RJ45 plug gives no mating order, and the bus puts +48V (pins 1/2) and GND (pins 7/8) on opposite edges of the connector. A plug inserted slightly tilted can mate +48V and A/B before GND. For that moment the node's input stage (SS26A, bulk cap, buck) is powered with no ground return except out through its own A/B pins, so its local GND floats toward +48V and the charging current returns through every other node's transceiver. A standard −7…+12V transceiver (abs. max ≈ −7.5…+12.5V) is destroyed by this, typically failing as a VCC–GND short, and takes neighbouring nodes' transceivers with it. The THVD2410's bus pins withstand ±70V whether powered or not, so with no low-voltage clamp on A/B (see ESD row below) there is no return path: the plugged node's ground simply floats until GND mates, and neither it nor the rest of the bus sees a fault current. The same rating covers a miswired or damaged cable putting +48V on A/B.

**Driver-enable:** use **USART1's hardware DE output** — tie the transceiver's `DE` (3) and `/RE` (2) together and drive from `USART1_DE` (`UART_DE_POLARITY_HIGH`: high = drive, low = listen). The peripheral handles `DEAT`/`DEDT` assertion timing per frame; no `setEnable()`/`delay()` loop needed.

```
 PB7  USART1_RX ───────────────  1 RO
 PB6  USART1_TX ───────────────  4 DI
 PA12 USART1_DE ──┬────────────  3 DE
                  └────────────  2 /RE
                  └── 10k ── GND         (reset-safe: driver stays off while the MCU pin is Hi-Z)
      3V3 ─ 100nF ─ GND ───────  8 VCC / 5 GND
                                 6 A ─[10Ω]─ A ─ RJ45 pin 4 (blue)
                                 7 B ─[10Ω]─ B ─ RJ45 pin 5 (blue)
```

The **10 kΩ pull-down on the DE/RE net is mandatory** — without it an unprogrammed or resetting node can float its driver on and fight the bus.

Per-node A/B passives, fit only where noted, DNP elsewhere:

| Part | Value | Populate |
|---|---|---|
| Fail-safe bias | **None** | not fitted anywhere on the main bus — the THVD2410 receiver is itself fail-safe (logic high with the inputs open or shorted, which covers an idle terminated bus sitting at ~0V A–B), so no board needs a biased idle level |
| ESD/surge | **None external** — the THVD2410's integrated IEC ESD protection (±12 kV contact/air) covers the bus pins. Do not fit an SM712 or any other clamp below ~70V on A/B: it would conduct during a ground-last hot-plug and become the fault path the transceiver is there to block. | DNP on every node (the SM712 footprint, U3, stays empty) |
| Series R | 10 Ω in each of A/B | optional, tames ringing/EMI |

**Termination:** no on-board footprint, no per-node DNP/jumper. 120 Ω A–B termination is provided by a **plug-in RJ45 terminator** (120 Ω across pins 4/5) inserted into the spare "out" jack of whichever node is physically last on the chain. Every node's board is identical here — moving/extending the bus end just means moving the terminator plug, not reworking a board.

**Common-mode range:** THVD2410 receivers operate over ±25V common-mode. Same shared-GND-return exposure as ENABLE. The both-ends power feed (§4) cuts worst-case IR drop to ~1/4 of a single-end-fed estimate, landing around ~0.9V normal / ~3.0V worst-case stall — far inside the window.

### 6.4 Status LEDs & buttons

Driven by `NodeLib`:

`Node`/`NodeMaster` take no pin arguments — they use `Board::ActivityLed` / `Board::ErrorLed` / `Board::UserButton` directly.
- **Activity LED** (`Board::ActivityLed`, PA7 / pin 14) — lit while the node transmits its queued messages (`Node::flushQueue`), off when idle.
- **Error LED** (`Board::ErrorLed`, PB0 / pin 15) — driven by `NodeLib::ErrorHandler`, blinked at 1 Hz on error; if `recoverable`, blinks until the user button is pressed. Outside a fatal error it shows the node's connection, **steady on while it is down** and off while it is up (pin only touched on a change):
  - **Bus nodes and the Thermostat** (every slave `NodeLib::Node`): on until the first `Poll` after boot, and again once polls stop for the 1 s heartbeat window — the same condition that fires `ConnectionLost()` (`Node::ShowBusState()`). For the Thermostat that is its link to the ControllerNode.
  - **MainController** (the bus master, where `Node` leaves the LED alone): on while the uplink to the server is down — not yet up after boot, or lost (`UplinkHandler::ShowUplinkState()`, following `NinaLink::InDataMode()`).
- **User button** (`Board::UserButton`, PA11 / pin 16) — configured `InputPullUp`, so active-low: wire button → pin → GND, 100 nF across it for debounce, optional 100–330 Ω series. Internal ~40 kΩ pull-up is enough for an on-board button; add an external 10 kΩ if it's on a long lead.

All LED GPIOs are push-pull, active-high (`led.Write(true)` = lit). Wire each `pin → R → LED anode, cathode → GND`.

| Board | Error (PB0) | Activity (PA7) | Power (always on, `+3v3`) |
|---|---|---|---|
| MainController | `C2286` KT-0603R red, 0603 | `C389518` MHT192CGCT yellow-green, 568–575 nm | `C916074` TZ-P2-0603YGTCS1 yellow-green, 0603 |
| ControllerNode | `C84256` NCD0805R1 red, 0805 | `C2296` KT-0805Y yellow, 0805 | `C2297` KT-0805G emerald green, 0805 |
| Thermostat | `C84256` NCD0805R1 red, 0805 | `C2296` KT-0805Y yellow, 0805 | — |

All GPIO-driven parts have Vf ≈ 1.7–2.4 V, which is what a 3.3V GPIO through 330 Ω needs to be readable. The ControllerNode's power LED is the one deliberate exception: a 525 nm emerald green (Vf 2.6–3.1 V) runs at only ~0.3–1 mA from `+3v3` through 330 Ω, so it glows dimly — acceptable for a steady power indicator, not for an activity LED that only flashes briefly. On the Thermostat, the two LEDs sit under Bivar `SLP3-150-100-F` light pipes (`B1`/`B2`, ordered but not assembled) that bring them to the enclosure edge.

**Series resistor: 330 Ω** for every indicator LED (red / green / any orange). `R = (3.3 − ~2.0) / I` → ~3.3–4 mA, well inside the 8 mA/pin guideline; the low-mcd parts need the current to be readable. 470 Ω if a softer indicator is wanted. Avoid blue/white/525 nm-green (Vf ≈ 3.1V) on the 3.3V GPIO rail entirely.

Node IDs are **factory-provisioned in flash** (`Node-Flash-Layout-and-Bootloader-Spec.md` §6.3) and reported to the master in the `Announce` reply during discovery — no DIP switch / address strap needed.

### 6.5 Easy-to-forget checklist

1. **Debug output needs a UART pin** — Cortex-M0+ has no SWO; `Tools::Logger` is a weak no-op meant to be routed to a UART. Bring USART2 (PA2/PA3) to a 3-pin header on `TemperatureNode` (the `MainController` needs none: its log goes over the uplink, `MainController-Server-Link-Spec.md` §5.1). On `ControllerNode` both USARTs are used (bus + thermostat link) — plan for sharing.
2. **RJ45 straight-through nets** — 48V (orange 1/2), GND (brown 7/8), A/B (blue 4/5), ENABLE (green 3/6) all pass in-jack → out-jack unbuffered. ENABLE also gets the per-node 1MΩ pull-up to local 48V (§3) and feeds the buck EN pin.
3. **Input protection + regulators** per `Node-Bus-Power-Path-Spec.md` (PTC fuse, 48V TVS, reverse diode, 47µF/100V bulk, LMR16030 buck, LDO, all caps).
4. **100 nF at every VCC pin** — MCU, transceiver, LDO.
5. **Reset-safe I/O** — every MCU output benign at POR. On a `ControllerNode` the servo enable (PA5) defaults off with the pin Hi-Z, so the servo is unpowered at POR / on an unprogrammed board (`Node-Bus-Power-Path-Spec.md` §3.1); keep a light external pull on the servo PWM pin toward the safe position as secondary insurance.
6. **Test points:** 48V, 5V, 3V3, GND, A, B, debug-UART TX, SWD header.
7. **One solid ground pour**; for NTC-into-ADC keep the divider return near the MCU ground pin.

---

## 7. Open items

1. **Whether simultaneous full-stall across all 21 ControllerNodes is a realistic scenario** for this application (e.g. synchronized power-on homing) or a non-issue because servos move independently. Relevant for fuse/PTC and connector-current sizing (§4).
