jeroenweij/ClimateControl/Spec/ControllerNode-Thermostat-Link-Spec.md

# ControllerNode ↔ Thermostat Link — Design Spec

**Companion docs:** `RS485-Node-Protocol-Spec-STM32G030.md` (main bus protocol this link reuses a subset of), `Node-Message-Model-Spec.md` (endpoint/operation model the link shares; `ThermostatFirmware` is defined here in §5.4), `Node-Flash-Layout-and-Bootloader-Spec.md` (§7 Thermostat OTA — the "relay details" it defers are §5 here), `Software-Architecture-Spec.md` (module map)

---

## 1. Topology

Each `ControllerNode` (damper actuator, main-bus slave) has exactly one `Thermostat` (room UI/setpoint) paired to it. That pair talks over a **separate, dedicated link — not the main RS485 bus**:

```
MainController ──(main RS485 bus, many nodes)── ControllerNode ──(dedicated 2-endpoint link)── Thermostat
                                                  ControllerNode ──(dedicated 2-endpoint link)── Thermostat
                                                  ControllerNode ──(dedicated 2-endpoint link)── Thermostat
                                                       ...                                          ...
```

- `ControllerNode` is on the main bus as a normal `NodeLib` slave (node ID `1..N`, per the protocol spec).
- `Thermostat` is **not** addressable on the main bus at all — it only ever talks to its own `ControllerNode`.
- Because the link has exactly two fixed endpoints, the main protocol's *arbitration* (`Discover`/`Announce`, dynamic roster — protocol spec §6) exists to let one master poll an unknown number of slaves fairly, and that problem doesn't exist here. The `Poll`/`Done` transmit-window discipline is nonetheless kept (§5.3): it costs one round-trip per cycle and buys byte-for-byte reuse of the bus bootloader's OTA slave over this link (§5).

---

## 2. What carries over from NodeLib

| Protocol-spec concept | On this link | Why |
|---|---|---|
| `Id`/`Message` framing, CRC16, sync/resync (protocol spec §3–§5) | **Yes** | A clean, corruption-detected frame is worth having on a 2-endpoint link too — no reason for a different frame format. |
| `Endpoint`/`Operation` enums (`Node-Message-Model-Spec.md`) | **A subset** | The **named-endpoint** blocks `System*`, `Room*` (`RoomSetpoint`/`RoomTemp`/`RoomHumidity`/`RoomMode`/`RoomTempOffset`), `DamperActual`/`DamperMode`/`AirMode`, and `Firmware` — same values as the main bus. Never the `Transport` endpoint. Verbs: `Get`/`Set`/`Report`/`Ack`/`Nack`. The **`Thermostat` is the source of truth for `Room*`** and pushes `Report`s; the `ControllerNode` pushes `DamperActual`/`DamperMode`/`AirMode` for the display. See `Node-Message-Model-Spec.md` §7. |
| `Discover`/`Announce` | **Yes, no discovery sweep** | The CN sends a `Discover` after reset and then every 5 s (`LinkMaster::discoverIntervalMs`) to read the Thermostat's app-vs-bootloader `state` from its `Announce`; an app `Announce` also tells the CN the Thermostat may have just booted (§5.3). There is only the one fixed peer, so no address sweep. |
| `Poll`/`Done` transmit-window discipline | **Yes — single-peer** | There is nothing to arbitrate, but this is the discipline the bus-resident bootloader's `FirmwareSlave` speaks, so the same bootloader binary takes an image over this link with no OTA-specific code (§5). The CN runs `LinkMaster` — a single-peer master; the cost is one `Poll`/`Done` round-trip per cycle. |
| Heartbeat / `ConnectionLost()` | **Yes** | Driven off the poll cycle (§5.3): 3 consecutive missed `Done` → `ConnectionLost()`. Surfaced on the main bus as `RoomLink` (0 down / 1 up). |

`Software/Lib/NodeLib` is split into a framing layer (`Frame`/`Crc`/`Id`/`Message`/`EEndpoint`/`EOperation`) and the roles built on it. The **Thermostat** runs the full slave (`NodeLib::Node`) — a point-to-point link changes nothing on the slave side. The **ControllerNode** runs `LinkMaster` on the link (§5.3): `NodeMaster` with discovery and the N-slave roster stripped to a fixed single peer, not the full arbitration state machine. Reusing this discipline rather than a bespoke push/ack exchange is what lets the bus bootloader receive an image over the link with no new transfer code.

---

## 3. Physical layer

**Half-duplex 2-wire RS485 with hardware driver-enable** — the same transceiver and BOM as the main bus. Differential signalling suits the duct-to-wall run, and although a 2-endpoint link has nothing to arbitrate and could run full-duplex or plain UART, the bus-resident bootloader's OTA UART (`Modules/Bootloader/OtaUart.cpp`) drives a hardware DE line and expects `DEAT`/`DEDT` turnaround timing. Matching that here — transceiver DE on `Board::Usart2De` (PA1) — is what lets the same bootloader binary serve a Thermostat image with only a USART-select change (§5.5).

On the ControllerNode this is a *second* RS485 front-end (USART2, PA2/PA3, DE PA1) alongside the main-bus one (USART1); on the Thermostat it is the only link. `BoardPins.h` (`LinkUart`) carries these pins. Bit rate is `Board::BusBaudRate` (115 200), the same as the main bus.

### 3.1 Cable, power, and connector

The Thermostat is **fed from the ControllerNode's own regulated 5V rail** (`Node-Bus-Power-Path-Spec.md` §3 — the same LMR16030 buck output that feeds the CN's own 3.3V LDO and, on a ControllerNode, the servo), not raw 48V and not an independent local supply. On the Thermostat side a `RT9080-33GJ5` (`C841192`, the same regulator as the ControllerNode's) drops it to 3.3V, and a separate 3.8V regulator feeds the OLED's `VBAT` (§4.1).

**Feed protection:**
- **ControllerNode end:** `F2`, a Littelfuse `1206L020YR` PTC (`C207035`, 200mA hold / 420mA trip, 24V, 0.65Ω), sits in series between the CN's `+5V` and connector pin 1. A short anywhere in the wall cable trips it instead of dragging the CN's 5V rail — and with it the CN's MCU and servo — into the buck's current-limit hiccup, so the CN stays up and reports `RoomLink = 0`. 200mA hold is ~2.5× the Thermostat's worst case (§4.5), and still clears it with the hold current derated for a warm duct.
- **Thermostat end:** `F1`, the same `1206L020YR`, followed by a `1N5819WS` series Schottky (`C191023`) for reverse polarity — a miswired cable, which no fuse covers. With the CN-side fuse in place, `F1` only matters when a Thermostat is powered from something other than a ControllerNode (e.g. a bench supply).

- **4 conductors, no separate ENABLE.** `RS485 A`, `RS485 B`, `+5V`, `GND` — that's it. A separate power-kill line from CN to the Thermostat isn't needed: CN can already reset the Thermostat over the link (`Firmware[EnterBootloader]`, §5), a physical reset button already exists on the Thermostat board (inherited from the node-core schematic, §4), and a hung link already parks the damper safely without needing to power-cycle anything (§5.1). Whatever would need a hard power-cycle to recover is already covered when the main bus's shared `ENABLE` kills this CN's own buck — the Thermostat's feed collapses with it for free, since it's downstream of the same rail.
- **Voltage drop margin is not a constraint.** The binding rail is the OLED's 3.8V `VBAT` regulator (§4.1), not the 3.3V one: it needs ~3.9V at its input. From the CN's ~5.3V worst-case-low rail, minus the series Schottky (~0.4V) and both PTCs (~0.1V at load), that leaves ~0.9V for the cable's round trip at the ~80mA worst case (§4.5) — roughly 40m of 26AWG or 65m of 24AWG stranded. That's still well beyond any real duct-to-wall or wall-to-CN run; RS485 itself isn't the limiting factor either. Cable routing and connector cost are what actually bound the practical run, not electronics.
- **Connector: JST-XH, 2.5mm pitch, 4-position** — chosen over RJ45 specifically to keep the Thermostat enclosure compact (§4.6); RJ45's ~16×13.5×20mm mating envelope would blow out the puck's thickness budget. Both ends use the XH family, so one straight-through `XHP-4` cable mates both; pin order is identical at both ends (1 `+5V`, 2 `A`, 3 `B`, 4 `GND`).

  | Role | Part | LCSC |
  |---|---|---|
  | PCB header, ControllerNode (through-hole, top entry) | `B4B-XH-A(LF)(SN)` | `C144395` |
  | PCB header, Thermostat (SMD, side entry — lies flat in the puck) | `S4B-XH-SM4-TB(LF)(SN)` | `C161861` |
  | Cable-side housing | `XHP-4` | `C144403` |
  | Crimp socket contacts (×4/cable end) | `SXH-001T-P0.6` | `C140573` (standard, not the `-N` low-insertion-force variant — this connector is installed once and left, so favor vibration retention over easy insertion) |

  3A/250V rated (far past our ~80mA), 22–28 AWG wire, −25…+85°C — the standard compact XH family (9.8mm mounting height), not JST's bulkier "high box" potted-board variant. Verify the friction latch before ordering at volume — LCSC's own listing metadata tags `XHP-4` as "non-latching," which conflicts with XH's usual friction-latch reputation and isn't contradicted anywhere in JST's datasheet; check a product photo or a sample part.

### 3.2 A/B line passives — reuses the main-bus scheme (`Node-Bus-Hardware-Design-Spec.md` §6.3), same transceiver

The link uses the same `THVD2410DR` (LCSC `C1849398`) as the main bus, so the same passives apply — but simpler, because this link's topology never varies: it is always exactly `ControllerNode` at one end and `Thermostat` at the other, so there's no need for the main bus's DNP-plus-jumper "populate only wherever the physical ends happen to be" scheme. Populate directly:

| Part | Value | Populate |
|---|---|---|
| Termination | 120 Ω across A–B | **both ends, always** — CN's link-side transceiver and the Thermostat's, permanently populated (not DNP; unlike the main bus, which end is "the end" never changes here) |
| Fail-safe bias | A→3V3, B→GND, ~560 Ω each | **once for the whole link, at ControllerNode** (the link's master, `LinkMaster`, §5.3) — not at the Thermostat, and not both: a second bias network would just parallel down and skew the idle point for no benefit. The THVD2410 receiver is itself fail-safe (logic high with the inputs open or shorted), so the bias is belt-and-braces for the idle level rather than required. `R20`/`R21`, `0603WAF5600T5E`, LCSC `C23204` (Basic part) — R20 A→3V3, R21 B→GND, confirmed on the CN-side link net in the netlist. Actual current draw is ~2.8mA (3.3V across the 560+560Ω pair plus the ~60Ω of parallel A-B termination at both ends) — negligible against the rail. |
| Series R | 10 Ω in each of A/B | both ends, recommended (not just optional as on the main bus) — the 4-conductor cable here (§3.1) isn't purpose-made 120 Ω-rated RS485 cable the way the main bus's Ethernet patch cable is treated, so the extra ringing/EMI damping is more likely to matter |
| ESD/surge | SM712 RS-485 TVS, SOT-23-3, pin 1→A, pin 2→B, pin 3→GND | both ends, right at the connector — LCSC `C5199207` (ElecSuper) or `C404012` (genuine Bourns). Unlike the main bus (where any A/B clamp below ~70V is DNP, `Node-Bus-Hardware-Design-Spec.md` §6.3), the highest voltage on this cable is the +5V feed, inside the SM712's −7/+12V non-conducting window — so a hot-plug or ground-last mating can't drive it into conduction, and it adds external ESD margin on top of the THVD2410's own. The Thermostat's connector sits at an exposed wall location, if anything more ESD-exposed than an enclosed duct node. |
| DE/RE pull-down | 10 kΩ, DE/RE net → GND | both ends, mandatory — same reset-safety reason as the main bus: an unprogrammed or resetting node must not float its driver onto the line. |

---

## 4. Thermostat hardware

The `Thermostat` reuses the **STM32G031F8P6** (project MCU) and the node-core schematic from `Node-Bus-Hardware-Design-Spec.md` §6 (MCU support parts, reset button, SWD, indicator LED, the `InputPullUp` user-button pattern) — it just swaps the main-bus RS-485 front-end for the point-to-point link (§3) and adds a display + a second button.

Unlike the other boards' applications it stays at the reset-default **16 MHz** HSI16 (no `ClockTo64MHz()`) and sleeps (`Hal::System::Sleep()`, `WFI`) between main-loop passes, woken by the 1 ms SysTick or a link byte. The MCU's heat lands on the room sensor a few centimetres away (§4.3), and a 2 s sensor read plus a small display need no more. `Hal::I2c` derives its `TIMINGR` prescaler from `SystemCoreClock`, so the bus runs at the same ~98 kHz at either clock.

### 4.1 Display — I²C OLED

**SSD1306 / SSD1315 128×64 mono OLED.** Part: **Wisevision `X096-2864KSWPG01-H30`** (LCSC `C18723026`).
- **True bare COG module** — SSD1315 chip bonded directly to the glass, 30-pin 0.7 mm-pitch FPC tail exposing every controller pin, no PCB, no onboard regulator of any kind.
- **Panel:** 24.7×16.6×1.3 mm outline, 21.74×11.175 mm active area, white — comfortably inside the §4.6 puck enclosure, and white reads more neutral than the common blue hobbyist panels behind a matte-white front.
- **I²C pin strapping** (per datasheet §1.5 Pin Definition): `BS0=0, BS1=1, BS2=0` (tie to `VSS`/`VDD`/`VSS`) selects I²C mode; then `CS#→VSS`, `R/W#→VSS`, `E/RD#→VSS` (all tied low, per the datasheet's serial/I²C note); `D0→SCL`, `D1` and `D2` **tied together→SDA** (the controller uses separate internal SDA-in/SDA-out pins that must be shorted externally); `D3–D7` unused, tie to `VSS`. `D/C#` doubles as the I²C slave-address bit `SA0`; it is tied to `VSS`, giving address `0x3C`, clear of the CHT40MEMS's `0x44` on the same shared bus (§4.3).
- The rest follows the datasheet's I²C-with-internal-charge-pump reference circuit (§3.3.5.2), part for part:
  - **`VBAT` rail — 3.8V, its own regulator.** With the internal charge pump (so no separate ~7.5–15 V panel rail), `VBAT` must be 3.5–4.2V — the 3.3V logic rail is below that window. A `MD7218A38PA1` (`U9`, `C920501`, SOT-89) makes 3.8V from the link's `+5V`. A `R17` 0Ω footprint from `+3v3` is left DNP.
  - **`VBAT` switch.** Required by the datasheet ("add an electronic switch, otherwise leakage current"): `Q3` `FDN338P` P-FET with **source on the 3.8V rail, drain on `VBAT`**, gate pulled to 3.8V by 47kΩ (`R3`); `Q4` `FDN335N` pulls that gate low when `PA4` is high, with a 47kΩ gate pull-down (`R4`) so `VBAT` stays off while the MCU pin is Hi-Z (reset, unprogrammed, bootloader). The orientation matters: with source and drain swapped, the P-FET's body diode feeds `VBAT` permanently and the switch can never turn off.
  - **`RES#`** on `PA0`, with a 10kΩ pull-down (`R6`) — the display is held in reset whenever `PA0` is Hi-Z (power-up, and the whole time the bootloader is resident), and firmware releases it.
  - **Passives:** `IREF` 620kΩ to `VSS` (the datasheet value); `VCOMH` 4.7µF; `VCC` 2.2µF; 1µF on each flying-capacitor pair (`C1P/C1N`, `C2P/C2N`); 1µF ×2 on `VDD`. No capacitor on the switched `VBAT` pin — the reference circuit has none, and the 2.2µF on the regulator output sits behind the ~0.1Ω switch.
  - Pins `1`/`30` (N.C., support pins) tied to ground for ESD; pin 7 N.C.
- I²C: 2 pins (SDA/SCL), **shared** with the room sensor (§4.3) — no extra pins for the sensor.
- Framebuffer 128×64/8 = **1 KB** of the 8 KB SRAM — fine alongside the link's `Message` buffers.
- **Constraint is flash, not RAM:** the app slot is 50 KB (`Node-Flash-Layout-and-Bootloader-Spec.md` §3). Driver + framing + app fits, but keep fonts minimal (one small + one large digit font, not a font library).

**Power** (internal charge pump, drawn from the 3.8V `VBAT` rail — U9 is linear, so the same current comes off the link's `+5V`):

| State | Current | Note |
|---|---|---|
| off (`0xAE` sleep, `VBAT` switched off) | < 10 µA | datasheet `IDD,SLEEP` — a bare COG module has no onboard regulator to add standby draw |
| on, blank | ~3–5 mA | |
| on, typical UI (~15 % pixels) | ~8–12 mA | |
| on, worst case | 27 mA typ / **32 mA max** | datasheet `IBAT`; plus `IDD` ≤ 0.22 mA on the 3.3V logic rail |

### 4.2 Display wake — button press

No motion/PIR sensor. The display is woken by a **button press** — a press while it is off only wakes it and does not step the setpoint, since the user can't yet see what they would be changing; presses while it is on step the setpoint. After an inactivity timeout it dims (contrast register) then turns off (`0xAE`). Averaged over realistic use the OLED contributes < 0.1 mA — it effectively leaves the power budget, and the screen-off state also avoids burn-in of the static digits.

While on, the panel is redrawn only when something it shows visibly changes (temperature/setpoint to 0.1 °C, humidity to 1 %, the damper bar's pixel width, the status icon), at most every 200 ms (`ThermostatHandler::RenderDisplay()`). A full redraw is a blocking 1 KB I²C transfer, ~0.1 s at 100 kHz, and the Thermostat serves its link from the same loop — the ControllerNode drops the link after 3 missed 200 ms polls — so redrawing every pass would put the link at risk.

Layout (128×64, `ThermostatHandler::RenderDisplay()`): the room temperature large and centred at the top (dashes while there is no sensor reading); a status icon in the top-right corner — an X while the ControllerNode link is down, otherwise a flame (heating) or snowflake (cooling) from the ControllerNode's `AirMode`, nothing while that is unknown; the setpoint bottom-left and the humidity with a % sign bottom-right; and the damper position as a 2 px bar along the bottom edge, full panel width at 100 %. Numbers are 7-segment digits; the icons and the % sign are string-art glyphs in the source. The PC simulator (`Software/Modules/Thermostat/sim`, `make -C Software sim-thermostat`) runs this code against an emulated panel for UI work without hardware.

*Optional:* an ambient-light sensor (phototransistor on an ADC pin, or an I²C ALS on the shared bus) to drop OLED contrast in a dark room — near-zero added cost, not required.

### 4.3 Buttons & room sensor

- **2 touch buttons, capacitive**, driven by a **Holtek BS212C-1** touch-key IC (LCSC `C42372571`, SOT-23-6) rather than mechanical switches, to support the sealed-enclosure look of §4.6 (copper mesh behind the plastic front as the two electrodes, no physical hole/actuator through the case).
  - `KOUT1`/`KOUT2` are NMOS, active-low, with internal pull-high — the same polarity `Hal::Gpio::Mode::InputPullUp` already assumes for a plain switch-to-GND button, so they wire straight onto the same two MCU GPIOs (`PA11`/`PA12`, §4.4) with no firmware change. One channel keeps the node `ErrorHandler` ack role (also clears a link-lost error); the other is the UI's set/adjust control.
  - **Electrodes, both 12 mm round** (§4.7 has the board orientation):
    - `KEY1` is a copper disc on the PCB's bottom layer — the front face, flush against the housing — at the top edge of the board. L2/L3 and the top pour are cleared behind it to keep its parasitic capacitance low. The two LED light pipes (`B1`/`B2`) pass through plated holes inside the disc; those holes are part of the `KEY1` net, which is harmless.
    - `KEY2` has no room on the PCB — the OLED flex wraps around the board edge where it would go — so it is a copper-mesh or copper-tape disc stuck to the inside of the housing, wired to test pad `U3` (DNP footprint, used as a solder pad). Keep that wire short and away from the OLED flex, which carries the charge-pump `VCC` rail.
    - Nothing shields `KEY1` from the top side, where the link connector (`U5`) and the RS-485 traces sit right behind it. At bring-up, test touch while the link is busy; if it false-triggers, fit `Ct` (`C18`).
  - Per the datasheet, sensitivity is set by electrode/copper area, the plastic's thickness, and — the easy knob during bring-up — a per-channel 0–25 pF capacitor footprint on each `KEY` pin (`Ct`; higher Ct = lower sensitivity, 0 pF = max). Leave the footprint unpopulated until the enclosure's actual plastic thickness is known, then tune empirically.
  - **Auto-calibration** (power-on, and again after ~1 s idle in normal mode / ~2 s in standby, per datasheet) re-baselines against drift from temperature, humidity and aging of the mesh/adhesive. A stuck-key timeout (60–68 s max key-on time) forces a re-cal if something covers a pad continuously.
  - Power: ~3.5 µA (3 V) standby, ~0.6 mA typ / 0.9 mA max (3 V) while active — negligible against the §4.5 budget. 0.1 µF decoupling on `VDD` per the datasheet's application circuit; no external LDO needed.
- **Room temperature/humidity sensor: CYBERSEN CHT40MEMS** (`CHT40MEMS`, JLCPCB `C54305346`) on the shared I²C display bus. SHT40-clone in the same DFN-4 1.5×1.5 mm footprint, I²C, ±0.2 °C / ±2.5 % RH, −40…+125 °C. 0 extra pins, no ADC calibration.
  - The footprint is the standard SHT40 DFN-4 so a genuine Sensirion `SHT40-AD1F-R2` (`C7461846`) drops onto the same pads — the fallback if CHT40MEMS stock or humidity quality disappoints. SHTC3 (`C194656`) is *not* pad-compatible (2×2).
  - Before committing firmware, verify from the CHT40MEMS datasheet that it is SHT4x command-compatible (command bytes, CRC-8 poly/init, measurement timing). If so, the existing SHT4x driver just works.
  - **Self-heating is the real design problem.** MCU + LDO + OLED warm the board and a wall thermostat classically reads 1–3 °C high. Mitigate: put the sensor at the *bottom* edge of the PCB (heat rises), far from the LDOs/MCU/OLED (on the board: `U7` at the bottom edge, both regulators and the 47µF bulk cap at the top); keep copper from conducting board heat into it (Sensirion app-note "thermal decoupling"). On the board, `U7`/`C24` sit on an island separated from the rest by a milled slot. The top pour is kept out around them. The island's own L2 GND and L3 +3V3 pours are joined to the main planes only by thin 0.25 mm traces across the gap, and they spread heat within the island rather than carrying it in from the board. Also: vent holes in the enclosure bottom + top for convection; keep the LDO on the far side of the board. The OLED being off most of the time (§4.2) already removes the biggest heat source. Running the MCU at 16 MHz and sleeping (§4) keeps its own share small. The remainder is taken out in firmware: the Thermostat's **`RoomTempOffset`** (`0x45`, int16 centi-°C, ±10.00) is added to every reading before it is shown or reported. It is stored per unit in the Thermostat's settings page (`NodeLib::SettingsPage`), so it survives resets, OTA and re-provisioning, and is set from the server (Overrides page → room card → *Thermostat sensor offset*). The ControllerNode relays a main-bus `Set` down the link (range-checked first, since the Thermostat's own `Nack` does not travel back up) and publishes the Thermostat's `Report` of the stored value upstream. Until a value is stored the offset is −0.90 °C, the first boards' steady-state self-heating with the display off.
  - **Calibrating:** the board's heat settles with a time constant of roughly half an hour, and handling it, a long stretch with the panel lit or an OTA all warm it for an hour or more afterwards. Leave the Thermostat untouched in its final position for at least 1.5 h, display off, then compare against a reference thermometer beside it and store the difference.
  - This part has no protective membrane — keep flux/outgassing away from it (clean assembly, no conformal coat over the sensor).
  - **Only real readings leave the Thermostat.** `RoomTemp`/`RoomHumidity` are not reported until the sensor has answered once, and stop being reported after 3 failed reads in a row (6 s at the 2 s sample interval); a `Get` meanwhile is `Nack`ed with reason `0x05` (unavailable), and the display shows dashes. The setpoint, which is real either way, is always reported. A board without a sensor fitted therefore reports a setpoint and no temperature, never a stand-in value.
  - **The CN drops a reading that stops arriving.** Its link cache treats the room temperature as valid only while it keeps being refreshed: after `NodeLib::RoomTempStaleMs` (3 min, three missed 60 s keepalives) without a `RoomTemp` it is dropped. The room loop then sees no valid room (`Damper-Budget-Spec.md` §4.2), the CN stops reporting `RoomTemp`/`RoomHumidity` upstream, and a main-bus `Get` of either is `Nack`ed (`0x05`). A setpoint without a temperature is not a valid room.

### 4.4 Pin map (STM32G031F8P6, TSSOP20)

| Pin | Signal |
|---|---|
| 1 / 20 | I²C1 SDA (PB7) / SCL (PB6) — OLED + room sensor |
| 9 / 10 | link TX / RX (USART2, PA2/PA3) |
| 8 | link DE (PA1) — half-duplex RS-485 (§3) |
| 16 / 17 | `KOUT1`/`KOUT2` from the BS212C-1 touch IC — button 1/2 (PA11 / PA12): setpoint up / down |
| 14 | status LED (PA7) |
| 15 | error LED (PB0, net `LED_ERROR`) — on while the ControllerNode isn't polling the link (`Node::ShowBusState()`) |
| 6 / 18 / 19 | NRST + reset button / SWDIO / SWCLK |
| 7 | OLED `RES#` (PA0) — GPIO output; 10kΩ pull-down holds the display in reset while the pin is Hi-Z |
| 11 | OLED `VBAT` power-switch gate (PA4) — GPIO output, HIGH = `VBAT` on; drives the `Q3`/`Q4` switch (§4.1), off while Hi-Z |

~10 of 15 usable GPIO — comfortable headroom.

### 4.5 Power delivery

The Thermostat is fed from the `ControllerNode` over the link cable (§3.1). Worst-case draw on its `+5V` input:

| Load | Worst case | Note |
|---|---|---|
| OLED `VBAT` (via U9) | 32 mA | datasheet `IBAT` max (§4.1) |
| RS-485 driver, while the Thermostat transmits | ~30 mA | drives the two 120 Ω terminations in parallel (60 Ω); only during its own frames |
| MCU at 16 MHz, sleeping between loop passes | ~1–2 mA | |
| Activity + error LEDs | ~8 mA | ~4 mA each through 330 Ω |
| BS212C-1, CHT40MEMS (heater off), OLED logic | ~1 mA | |
| **Total** | **~75 mA** | ~15 mA typical with the display off |

The CN-side 200mA-hold PTC (§3.1) covers this with ~2.5× margin. The one load that would eat into it is the CHT40MEMS's built-in heater (SHT4x-class, up to ~200 mW ≈ 60 mA at 3.3V): keep it off, or at its low-power settings — room humidity indoors doesn't need it.

### 4.6 Enclosure — industrial design direction

Styled after the **IKEA TIMMERFLOTTE** (temp/humidity sensor, ~65×65×18 mm puck) — small rounded disc, matte white, no visible branding/text on the face, nothing on the wall/shelf reading as "a gadget."

- **Form factor:** round puck, roughly TIMMERFLOTTE's ~65 mm width class in plan; depth driven by our stack-up (PCB + OLED module + standoffs), which is very likely thicker than TIMMERFLOTTE's 18 mm once the connector/cable entry (below) is accounted for — treat 18 mm as an aspiration, not a constraint to force.
- **Finish:** matte white (or matte black to match room trim — pick one per install, not both), no exposed screws on the visible face, seams at the back/rim rather than front.
- **Face:** the OLED window is the only thing that reads on the front; buttons should sit flush or nearly flush rather than protruding, in keeping with TIMMERFLOTTE's "the whole thing feels like one big button" feel. It has *no* auto-lit display — you press to see the reading — matching this spec's §4.2 wake-on-press behavior.
- **Mount:** wall-mount (this is a fixed room thermostat, not a shelf sensor) — a rear plate/bracket the puck clips onto, screw holes hidden behind it.

**Two real deltas from a literal copy:**
- TIMMERFLOTTE is battery-powered and cable-free; this Thermostat is wired — link plus power, both on the same 4-conductor cable (§3.1) — so the enclosure needs a cable entry TIMMERFLOTTE doesn't have — round back, cable out the rear/bottom so the front stays clean.
- TIMMERFLOTTE's whole face is *one* button (read-only device — press to cycle temp/humidity). This Thermostat also drives a setpoint (§4.3, 2 touch buttons), so a literal one-big-button face doesn't carry over as-is — left for a future interaction-design pass.

### 4.7 PCB orientation and front-face stack

The PCB's **bottom side is the front**. It sits flush against the inside of the housing's face, and all components are on the top side, facing the wall.

- **Board shape:** a Ø50 mm circle with a flat bottom edge and a 25.8 × 7.9 mm notch in it. The OLED flex wraps around the board through that notch.
- **OLED:** the glass lies on the bottom (front) side, behind the display window. Its FPC tail wraps 180° around the notched edge to the `U17` solder pads on the top side.
  - This is the opposite fold to the usual mounting, where the glass and pads share one PCB face with the flex folded under the glass. So two things depend on the fold:
    - which face of the FPC the exposed contacts are on;
    - the pin order. Seen from the top side, the pad row is mirrored compared with the library footprint.
  - Check both against a real module before committing a board revision: print the top copper at 1:1, wrap the flex around a 1.6 mm edge the way it will be assembled, and confirm pin 1 lands on `U17` pad 1. Pins 1 and 30 are both GND, so a mirrored footprint looks right at the ends while shorting pin 9 (`VDD`) to pin 22 (`D4`, tied to GND).
  - Also respect the flex's minimum bend radius around the board edge plus the glass.
- **Touch electrodes:** `KEY1` is on-board on the bottom layer and `KEY2` is a disc on the housing, wired to `U3` (§4.3).
- **Status LEDs:** `LED2`/`LED3` are on the top side. The light pipes `B1`/`B2` carry their light through the board to the front, inside the `KEY1` electrode.
- **Room sensor:** `U7` is on the top side, on its slotted island at the notched edge (§4.3). It faces the wall side of the enclosure, so venting has to reach the back of the board.

---

## 5. Firmware update — the OTA link master

The same bus-resident bootloader binary receives the Thermostat image over this link, unchanged, because the ControllerNode speaks the transport discipline the bootloader already implements. This is the "relay details" that `Node-Flash-Layout-and-Bootloader-Spec.md` §7 defers here.

### 5.1 Ordering — the node first, then its Thermostat

A ControllerNode and its Thermostat update as two separate, sequential jobs, CN first:

1. The **ControllerNode** updates over the main bus — the normal flow of `Node-Flash-Layout-and-Bootloader-Spec.md` §6. Self-healed by the CN's own bootloader if interrupted.
2. Once the CN is confirmed back in its application on the new image, the **Thermostat** update runs *through the CN application*, which acts as the OTA master on the link (§5.4).

The CN **bootloader never relays** — it only ever updates the CN itself. A Thermostat is updatable only while its CN runs a healthy application; that CN app is the Thermostat's recovery anchor, in place of "the bus" for a main-bus node. A Thermostat left with an invalid image sits in its bootloader waiting for its CN to re-drive the push — no J-Link needed as long as the CN app and the link are intact. Interrupting a Thermostat push does not disturb the CN (it is relaying, not resetting itself), so the server just retries.

**Damper safe state during the transfer.** Whenever the CN loses fresh room data — its Thermostat sitting in the bootloader for a transfer, or any `ConnectionLost()` (§5.3) — the CN drives the damper to **50 % (neutral airflow)** and then powers the servo down. It does not hold the last position or fall back to `DamperMode`. This is the same park the CN runs in `INodeHandler::PrepareForReset()` before its *own* OTA reset. The servo is unpowered by default in the hardware — a STM32-gated power enable, de-asserted at reset and while the MCU is unprogrammed — and is energised only for the (slewed, a few seconds at most) move to a new setpoint, so "powered down" is the resting state and the metal gearing holds 50 % until the Thermostat re-announces and the control loop resumes. Hardware side: `Node-Bus-Power-Path-Spec.md` §3.1.

### 5.2 The Thermostat runs full NodeLib

The Thermostat application is an ordinary `NodeLib::Node` slave on its link USART (USART2, PA2/PA3 + PA1 DE), with `ConfigStore` giving it `module = Thermostat` and the fixed Thermostat `nodeId` (§5.2.1). It serves the §2 endpoint subset (`System*`; `Room*` as source of truth, `RoomTempOffset` stored; `DamperActual`/`DamperMode`/`AirMode` for the display; `Diagnostics*`; `Firmware`). The point-to-point nature of the link changes nothing on the slave side — it is effectively a `ControllerNode` app minus the damper, plus the OLED/sensor/buttons.

`Firmware` on the Thermostat is handled as on any node: a running app receiving `Firmware[EnterBootloader]` parks its UI, writes `Board::EnterBootloaderMagic` to the backup register and resets; the bootloader then serves the `Begin`/`Write`/`End`/`Activate` transfer.

#### 5.2.1 Thermostat `nodeId` — one fixed id for every Thermostat

Every Thermostat has the **same fixed `nodeId`, `NodeLib::THERMOSTAT_NODE_ID = 1`** (`Lib/NodeLib/Id.h`), with `module = 4`. It is not provisioned per unit: that one `ConfigRecord` is generated at build time and merged into the Thermostat's `thermostat-full.hex` (`FIXED_NODE_ID` in `Modules/Thermostat/CMakeLists.txt`, which reads the value from `Id.h`), so `make flash-full MODULE=thermostat` is the whole bench step. The link is private, so the id never collides with anything — it does not need to relate to the ControllerNode's own bus id.

Consequences:
- Any Thermostat is a **drop-in replacement** for any other — no pairing or re-provisioning step.
- The Thermostat still has a valid `ConfigRecord`, so everything keyed on `ConfigStore::Valid()` / `GetModule()` works unchanged: the bootloader's OTA slave and its USART2 select (§5.5), and the module byte in `Announce` / `SystemInfo`.
- The link id never leaves the link. The server, `0x63` and `ota_jobs` identify a Thermostat by its owning ControllerNode's bus id; the physical unit is told apart by its `uid` (§5.6).
- `LinkMaster`'s single peer id is the constant `THERMOSTAT_NODE_ID`.
- With id `1`, `FirmwareSlave`'s `(nodeId-1)×10 ms` announce back-off is zero.
- `tools/provision.py` refuses `--module thermostat`; the Thermostat record comes only from the build.

### 5.3 `LinkMaster` — the CN's single-peer poll loop

The CN application instantiates, on its link USART, `NodeLib::LinkMaster` — a distinct class, not a mode of `NodeMaster`. It shares only the framing/`Node` plumbing; the discovery array, dynamic roster and round-robin cursor are not carried. It is `NodeMaster` with the arbitration removed:

| `NodeMaster` | `LinkMaster` |
|---|---|
| dynamic discovery, `activeNodes[MAX_NODES]` | fixed single peer, id = `THERMOSTAT_NODE_ID` (§5.2.1) |
| round-robin across N slaves | poll the one peer every **200 ms** |
| `Discover` + Announce collection each cycle | one `Discover` at bring-up / after link loss to read the peer's app-vs-bootloader `state`; no periodic re-discovery |
| injects master `Set`/`Get` in the gaps | same |
| `ConnectionLost()` from poll-cycle bookkeeping | **3** consecutive missed `Done` → `RoomLink = 0` + `ConnectionLost()` |

Normal traffic: the Thermostat pushes `Room*` `Report`s in its poll window; the CN injects `Set DamperActual` / `Set DamperMode` / `Set AirMode` for the display (each on change, and all again after the link comes back or the Thermostat app answers a `Discover` — a reboot shorter than the link timeout never drops the link, and the fresh app's display cache is empty), and `Set RoomSetpoint` for a master override. One poll loop covers liveness, room-state relay and OTA.

### 5.4 `ThermostatFirmware` endpoint (`0x22`)

Delegating the Thermostat's OTA (and version query) from the main bus needs one new endpoint, because a plain `Firmware` frame addressed to the CN means "update the CN". `ThermostatFirmware = 0x22` sits in the Firmware block of `Node-Message-Model-Spec.md` §3 — the `FirmwareOp` sub-opcode symmetry with `Firmware = 0x20` is the reason it is not in the `Room` block.

```
ThermostatFirmware = 0x22   // data[0] = FirmwareOp; "act on my paired Thermostat over the link"
```

- Same `data[0] = FirmwareOp` sub-opcodes as `Firmware` (`Begin`/`Write`/`End`/`Activate`/`Abort`/`Status`) — the `Operation` verb set does not grow.
- **NodeLib does not self-handle it** (unlike `Firmware`). It is delivered to the ControllerNode's `INodeHandler` like an application endpoint — only the ControllerNode module defines it, exactly like the `Room*` block.
- The CN handler terminates each frame and originates a fresh link transaction against the Thermostat's real `Firmware` endpoint, driven by `LinkMaster`:

| main bus → CN | CN → Thermostat, over the link |
|---|---|
| `Set ThermostatFirmware[Begin] {module=4, imageSize, imageCrc32, fwVersion, flags}` | (guard, §5.4.1) `Set Firmware[EnterBootloader]`, wait for the bootloader `Announce` (re-broadcasting `Discover` every 500 ms, since the bootloader only announces when asked), then `Set Firmware[Begin {…}]`. The first bootloader-state `Announce` after `EnterBootloader` is only taken as a hint: it is normally the app's own, sent just before it resets (`Node::HandleFirmwareMessage()`), when a `Begin` would be lost mid-reset. The CN sends a fresh `Discover` on it and sends `Begin` on the next one, which only the bootloader can answer. (the standard 12-byte payload, `flags` dropped) |
| `Set ThermostatFirmware[Write] {offset(2 LE), bytes=32}` | `Set Firmware[Write {offset, bytes}]` in the next link poll window |
| `Set ThermostatFirmware[End]` / `[Activate]` / `[Abort]` | the same `Firmware` op |
| `Get ThermostatFirmware` (no FirmwareOp) | answered from the CN's link cache — no link traffic |

- `ThermostatFirmware[Begin]` is CN-terminated, so its payload differs from the bus `Firmware[Begin]` — it adds a `flags` byte (bit 0 = `Force`, §5.4.1), ~14 bytes, well under `MAX_DATA`.
- The CN `Report`s `ThermostatFirmware {FirmwareOp::Status, state, expectedOffset, lastError, fwVersion}` up the main bus, copied from the Thermostat's link `Status` (or from cache for a bare `Get`). This carries the Thermostat's running firmware version on demand — no separate "thermostat info" endpoint.
- The CN keeps a small link cache of the Thermostat's `state` + `fwVersion` (+ `uid`, §5.6), so `Get ThermostatFirmware` is always answerable. `state` comes from the Thermostat's `Announce` and its bootloader's `Status`. `fwVersion` comes from that `Status` during a push, and otherwise from the app's `SystemInfo`, which nothing reports unasked: the CN sends a link `Get SystemInfo` whenever the app is up on the link and has not answered since it (re)appeared, every 5 s until it does. The link dropping, or the Thermostat passing through its bootloader, starts the asking again, so a freshly updated Thermostat reports its new version.
- The server sends `ThermostatFirmware[Begin]` up to 3 times, 20 s apart, before failing a push at that step: the CN need not be on the bus when the push starts (typically it is still rebooting after its own update, queued just before). Each wait is far longer than the CN's own 4 s bootloader-entry attempt, so a resend never overlaps one in progress.
- One 32-byte chunk crosses the CN at a time (`Node-Flash-Layout-and-Bootloader-Spec.md` §6.2) — no image staging. The CN does **not** forward frames between the two buses (`Node-Message-Model-Spec.md` §7): it terminates and re-originates.
- `ThermostatFirmware[Write]` mirrors `Firmware[Write]`'s `Ack`/`Nack` reply on both hops (`Node-Flash-Layout-and-Bootloader-Spec.md` §6.2) — this wasn't optional once decided for `Firmware`, since the bootloader binary running on the Thermostat no longer answers a `Write` with a `Status` `Report` at all. The CN cannot answer synchronously the way it does for `Begin`/`End`/`Activate`/`Abort`/`Get` (which reply from `ReportThermostatFirmwareStatus()` right after handling the main-bus message): a `Write`'s outcome isn't known until the separate, asynchronous CN↔Thermostat link round-trip completes, since the CN terminates and re-originates rather than forwarding. `ControllerHandler::HandleThermostatFirmware()`'s `Write` case returns immediately after relaying via `ThermostatLink::OtaWrite()` (2-byte offset, 32-byte data, matching `Firmware[Write]`'s shape exactly); `ThermostatLink::ReceivedMessage()` decodes the Thermostat's own `Ack`/`Nack` reply when it arrives and stages it; `ControllerHandler::Loop()` polls `ThermostatLink::ConsumeWriteReply()` each iteration and, once the outcome is known, queues the corresponding `Ack`/`Nack` (offset + `chunkCrc16` + `programFailed`) up the main bus as `ThermostatFirmware`. `Begin`/`End`/`Abort` are `Report`-based on the main bus and `Ack`/`Nack`-based on the link: the CN answers the main-bus request at once with its current `Status`, then, when the Thermostat's 1-byte `Ack`/`Nack` (`lastError`) arrives, updates the relayed state (`Begin` → receiving, `End` → valid, `Abort` → idle, any `Nack` → error) and `Report`s `ThermostatFirmware` `Status` again unsolicited. The CN sends that unsolicited `Status` whenever the Thermostat's state byte changes, including one learned from its `Announce` (for example a Thermostat left in its bootloader), so the MainController's `0x63 ThermostatStatus` shows the real state. A link timeout does not abort a relay in progress: the Thermostat is silent while it resets into the bootloader and while `Begin` erases the app slot. The `EnterBootloader` wait and the server's per-step timeouts bound those gaps.

#### 5.4.1 Already-current guard

With `Force` (bit 0 of `flags`) clear, if the CN's link cache shows the Thermostat already running the requested `fwVersion`, the CN does not disturb it: it skips `EnterBootloader` and immediately `Report`s `Status {state = app, lastError = AlreadyCurrent}`. A working Thermostat is never rebooted for a no-op update.

The server makes the same check *before* creating the job — it has the Thermostat's version from `0x63` and the target from the held image — and refuses it (`409`, "already current") rather than starting a pointless transfer (`service.EnqueueUpdate`). The CN guard is the backstop for a stale server cache. `Force` is set only on an explicit operator "re-flash anyway": `"force": true` on `POST /api/firmware/update`, or the Firmware page's allow-downgrade / same-version toggle. It is stored on the job (`ota_jobs.force`), so a queued push still carries it into `Begin`. Match is on `fwVersion` only (the cached `SystemInfo` carries no `buildId`).

### 5.5 Bootloader — one binary, USART select by module

`Modules/Bootloader/OtaUart.cpp` picks its USART and pins from the provisioned module type:

| `ConfigStore::GetModule()` | link USART | TX / RX | DE |
|---|---|---|---|
| `Thermostat` | USART2 | PA2 / PA3 (AF1) | PA1 (AF1) |
| everything else | USART1 | PB6 / PB7 (AF0) | PA12 (AF1) |

Half-duplex 2-wire RS485 with hardware driver-enable (`USART_CR3_DEM`, `DEAT`/`DEDT`) in both cases — identical framing, baud and `FirmwareSlave` logic. `main.cpp`'s `StayResident()` routes a provisioned node (`ConfigStore::Valid()`) to `FirmwareSlave(BusBaud, NodeId(), module)`; a Thermostat always lands there (its fixed record is part of its factory image, §5.2.1) and serves the transfer on USART2. The "one bootloader binary, all four boards" property and the Thermostat pin map of §4.4 are unchanged.

### 5.6 Server & MainController awareness

The server models every `ControllerNode` as owning one Thermostat.

- **Presence / version / identity:** uplink endpoint `0x63 ThermostatStatus`, MC→S `Report {controllerNodeId(1), linkUp(1), blState(1), fwMajor(1), fwMinor(1), uid[12]}` (17 B), on change, for every known Thermostat on each uplink (re)connect, and as a 60 s keepalive. The MC (`ThermostatMonitor`) fills it from each ControllerNode's `RoomLink` and `ThermostatFirmware` Status `Report`s — watched as they pass, and asked for with a `Get` pair, one ControllerNode every 2 s so the bus queue never sees a burst. A ControllerNode whose Thermostat is in its bootloader is not polled: the running push's own Status `Report`s keep the picture current. `blState` is the Status `state` byte (`0` = application).
  - **`uid`** is sent as zeros for now: the CN does not read or cache its Thermostat's MCU ID yet (open item below). It is meant to be the Thermostat MCU's 96-bit factory device ID (read-only at `0x1FFF_7590`, `Node-Flash-Layout-and-Bootloader-Spec.md` §2). The CN reads it once from the Thermostat's `SystemInfo` (`uid[12]`) over the link and caches it. Same role as `nodes.uid` for bus nodes: it names the physical unit independent of the assigned `nodeId`, so the server can tell a Thermostat behind a given CN was physically swapped (new `uid`, same id). Inventory / OTA-history signal, not used for routing.
- **OTA target:** the server drives `ThermostatFirmware` directly, addressed to the owning ControllerNode's node id, instead of `Firmware` addressed to a plain node — same relayed-endpoint mechanism, different endpoint (`MainController-Server-Link-Spec.md` §8 step 6). No MC-side translation is involved; `ThermostatFirmware` is itself an ordinary relayed endpoint (§5.4 table above).
- **DB:** `thermostats(controller_node_id PK → nodes.id, module, uid, fw_version, bl_state, link_up, last_seen)`; `ota_jobs` has `target TEXT NOT NULL DEFAULT 'node'` (`'node'` | `'thermostat'`), `node_id` staying the bus node id in both cases.
- **UI:** the Status page lists each Thermostat under its ControllerNode with its own fw version and an upload control; the building-map per-room badge renders `RoomLink`.

### 5.7 Implementation status

Built in firmware: the `EEndpoint`/`EFirmware` additions, the `NodeLib` framing use split (`LinkMaster` added alongside `Node`/`NodeMaster`), `OtaUart` module-aware USART select, and the `ControllerNode` and `Thermostat` modules — the ControllerNode carries the `Damper`, the Room* cache, `LinkMaster`, and the `ThermostatFirmware` relay; the Thermostat is a NodeLib slave on the link with the OLED / CHT40 sensor / buttons still stubbed (they need an I²C HAL).

Built in the `Webserver`: `ota_jobs.target` (`'node'` | `'thermostat'`); the `0x63 ThermostatStatus` decode + `thermostats` table (`controller_node_id`, `uid`, `fw_version`, `bl_state`, `link_up`, `last_seen`); the `firmware_images` repository (one image per module, module + version parsed from the upload filename `<Module>_<major>.<minor>.bin` and cross-checked against the descriptor, which the build fills from `CC_FW_VERSION`); the **Firmware** page, which lists every node with its installed version against the held image and gives each ControllerNode a second row for its Thermostat, plus per-node and per-module ("update all") push buttons that grey out when the target is offline or already current; and a single-flight OTA **queue** (one push at a time, the rest `state = 'queued'`, fed by both single presses and "update all"). Node firmware versions come from `SystemInfo` reports, thermostat versions from `0x63`.

Built in the MainController: `ThermostatMonitor` emitting `0x63 ThermostatStatus` (§5.6). A Thermostat push needs nothing else from the MC — `ThermostatFirmware` is an ordinary relayed endpoint, addressed to the owning ControllerNode (§5.6 "OTA target"). Built in the server: the pre-flight already-current check and `Force` re-flash (§5.4.1).

Not built yet: the Thermostat `uid` in `0x63` — the CN would read it from the Thermostat's `SystemInfo` and cache it, but node `SystemInfo` carries no UID today, so it is sent as zeros.

---

## 6. Open items

1. **Control loop location** — resolved: `ControllerNode` runs the room's control loop itself (compares `Thermostat`'s setpoint/room-temp against the shared duct `SupplyTemp` and drives its own damper), with `MainController` only arbitrating a fair-share `DamperBudget` ceiling across nodes, never running the room loop itself — full design in `Damper-Budget-Spec.md`. This is the assumption `MainController-Spec.md` §2 is built on.
