jeroenweij/ClimateControl/Hardware/ControllerNode/BOM.csv

No. | Quantity | Comment | Designator | Footprint | Value | Manufacturer Part | Manufacturer | Supplier Part | Supplier
1 | 2 | 2.2uF | C1,C2 | C1206 | 2.2uF | CS3216X7R225K101NRI | SAMWHA(三和) | C920964 | LCSC
2 | 3 | 22uF | C3,C4,C5 | C1206 | 22uF | CL31A226KAHNNNE | SAMSUNG(三星) | C12891 | LCSC
3 | 7 | 100nF | C6,C12,C13,C14,C16,C18,C21 | C0402 | 100nF | CL05B104KO5NNNC | SAMSUNG(三星) | C1525 | LCSC
4 | 1 | 47nF | C7 | C0603 | 47nF | CL10B473KB8NNNC | SAMSUNG(三星) | C1622 | LCSC
5 | 2 | 1uF | C8,C9 | C0603 | 1uF | CL10A105KB8NNNC | SAMSUNG(三星) | C15849 | LCSC
6 | 1 | 47uF | C10 | CAP-SMD_BD8.0-L8.3-W8.3-FD | 47uF | VP2A470M0810 | HONOR(荣誉) | C4054390 | LCSC
7 | 1 | 220uF | C11 | CAP-SMD_BD6.3-L6.6-W6.6-FD | 220uF | RVT220UF16V67RV0015 | KNSCHA(科尼盛) | C2887273 | LCSC
8 | 1 | 100nF | C15 | C0805 | 100nF | CL21B104KCFNNNE | SAMSUNG(三星) | C28233 | LCSC
9 | 2 | 10uF | C17,C20 | C0603 | 10uF | CL10A106MA8NRNC | SAMSUNG(三星) | C96446 | LCSC
10 | 1 | 220uF | C19 | CAP-SMD_BD6.3-L6.6-W6.6-LS7.3-FD | 220uF | MA25V220M6X8 | JIERR(捷而瑞) | C46550464 | LCSC
11 | 1 | 10nF | C22 | C0402 | 10nF | CL05B103KB5NNNC | SAMSUNG(三星) | C15195 | LCSC
12 | 1 | SK36A | D1 | SMA_L4.4-W2.6-LS5.2-R-RD |  | SK36A | SMC(桑德斯) | C492931 | LCSC
13 | 1 | SS26A | D2 | SMA_L4.3-W2.5-LS5.0-RD |  | SS26A | FUXINSEMI(富芯森美) | C908236 | LCSC
14 | 1 | TPESD8004MUTAG | D3 | DFN2510-10_L2.5-W1.0-P0.50-BL |  | TPESD8004MUTAG | TECH PUBLIC(台舟) | C2827679 | LCSC
15 | 1 | SMAJ58A | D5 | SMA_L4.3-W2.7-LS5.0-RD |  | SMAJ58A | GOODWORK(固得沃克) | C2980408 | LCSC
16 | 1 | SMD050F-2 | F1 | FUSE-SMD_L7.4-W5.1-1 |  | SMD050F-2 | Littelfuse(美国力特) | C428837 | LCSC
17 | 1 | 1206L020YR | F2 | F1206 |  | 1206L020YR | Littelfuse(美国力特) | C207035 | LCSC
18 | 1 | DNP | H1 | HDR-SMD_4P-P2.54-V-M-R2-C2-S7.5 |  | DNP | DNP | DNP | DNP
19 | 1 | 2.54-1*3P针 | H2 | HDR-TH_3P-P2.54-V-M-1 |  | 2.54-1*3P针 | BOOMELE(博穆精密) | C49257 | LCSC
20 | 4 | HOLE | H3,H4,H5,H6 | HOLEHOLE
21 | 1 | 15uH | L1 | IND-SMD_L12.5-W12.5_RLF12545T | 15uH | SMDRI127-150MT | SXN(顺翔诺) | C40000 | LCSC
22 | 1 | KT-0805G | LED1 | LED0805-R-RD |  | KT-0805G | KENTO | C2297 | LCSC
23 | 1 | KT-0805Y | LED2 | LED0805-R-RD |  | KT-0805Y | KENTO | C2296 | LCSC
24 | 1 | NCD0805R1 | LED3 | LED0805-RD |  | NCD0805R1 | 国星光电 | C84256 | LCSC
25 | 1 | AO3401A | Q1 | SOT-23_L2.9-W1.3-P1.90-LS2.4-BR |  | AO3401A | AOS | C15127 | LCSC
26 | 1 | 2N7002 | Q2 | SOT-23-3_L2.9-W1.3-P1.90-LS2.4-BR |  | 2N7002 | CJ(江苏长电/长晶) | C8545 | LCSC
27 | 1 | 75kΩ | R1 | R0603 | 75kΩ | 0603WAF7502T5E | UNI-ROYAL(厚声) | C23242 | LCSC
28 | 1 | 12kΩ | R2 | R0603 | 12kΩ | 0603WAF1202T5E | UNI-ROYAL(厚声) | C22790 | LCSC
29 | 1 | 49.9kΩ | R3 | R0603 | 49.9kΩ | 0603WAF4992T5E | UNI-ROYAL(厚声) | C23184 | LCSC
30 | 1 | 1MΩ | R4 | R1206 | 1MΩ | 1206W4F1004T5E | UNI-ROYAL(厚声) | C17927 | LCSC
31 | 4 | 10kΩ | R5,R9,R11,R15 | R0402 | 10kΩ | 0402WGF1002TCE | UNI-ROYAL(厚声) | C25744 | LCSC
32 | 3 | 330Ω | R6,R7,R8 | R0402 | 330Ω | 0402WGF3300TCE | UNI-ROYAL(厚声) | C25104 | LCSC
33 | 1 | 100Ω | R10 | R0402 | 100Ω | 0402WGF1000TCE | UNI-ROYAL(厚声) | C25076 | LCSC
34 | 2 | 100kΩ | R12,R13 | R0402 | 100kΩ | 0402WGF1003TCE | UNI-ROYAL(厚声) | C25741 | LCSC
35 | 1 | 3.3kΩ | R14 | R0402 | 3.3kΩ | 0402WGF3301TCE | UNI-ROYAL(厚声) | C25890 | LCSC
36 | 1 | 47kΩ | R16 | R0402 | 47kΩ | 0402WGF4702TCE | UNI-ROYAL(厚声) | C25792 | LCSC
37 | 1 | 120Ω | R17 | R0402 | 120Ω | 0402WGF1200TCE | UNI-ROYAL(厚声) | C25079 | LCSC
38 | 2 | 10Ω | R18,R19 | R0402 | 10Ω | 0402WGF100JTCE | UNI-ROYAL(厚声) | C25077 | LCSC
39 | 2 | 560Ω | R20,R21 | R0603 | 560Ω | 0603WAF5600T5E | UNI-ROYAL(厚声) | C23204 | LCSC
40 | 1 | LR1206-21R012F4 | R22 | R1206 |  | LR1206-21R012F4 | RALEC(旺诠) | C154636 | LCSC
41 | 2 | HC-WK88-H18-B | RJ1,RJ2 | RJ45-TH_HC-WK88-H18-B |  | HC-WK88-H18-B | HC(虹成电子) | C7501838 | LCSC
42 | 2 | GT-TZ084B-H015-L1 | SW1,SW2 | SW-SMD_4P-L5.2-W5.2-P3.70-LS6.4 |  | GT-TZ084B-H015-L1 | G-Switch(品赞) | C29780122 | LCSC
43 | 1 | LMR16030PDDAR | U1 | SOIC-8_L4.9-W3.9-P1.27-LS6.0-BL-EP |  | LMR16030PDDAR | TI(德州仪器) | C90665 | LCSC
44 | 1 | STM32G031F8P6 | U2 | TSSOP-20_L6.5-W4.4-P0.65-LS6.4-BL |  | STM32G031F8P6 | ST(意法半导体) | C529334 | LCSC
45 | 1 | DNP | U3 | SOT-23-3_L2.9-W1.3-P1.90-LS2.4-BR |  | DNP | DNP | DNP | DNP
46 | 1 | RT9080-33GJ5 | U4 | TSOT-23-5_L2.9-W1.6-P0.95-LS2.8-BL |  | RT9080-33GJ5 | RICHTEK(立锜) | C841192 | LCSC
47 | 2 | THVD2410DR | U5,U7 | SOIC-8_L4.9-W3.9-P1.27-LS6.0-TL |  | THVD2410DR | TI(德州仪器) | C1849398 | LCSC
48 | 1 | TC2030 | U6 | TAG-CONNECT_TC2030-IDC-NL
49 | 4 | DNP | U8,U9,U10,U11 | SMD_RH-5015 |  | DNP | 荣和 |  | LCSC
50 | 1 | SN74AHCT1G126DBVR | U14 | SOT-23-5_L3.0-W1.7-P0.95-LS2.8-BR |  | SN74AHCT1G126DBVR | TI(德州仪器) | C163712 | LCSC
51 | 1 | INA180A1IDBVR(LX) | U17 | SOT-23-5_L3.0-W1.6-P0.95-LS2.8-BR |  | INA180A1IDBVR(LX) | LX(灵星芯微) | C48533472 | LCSC
52 | 1 | B4B-XH-A(LF)(SN) | U18 | CONN-TH_B4B-XH-A-LF-SN |  | B4B-XH-A(LF)(SN) | JST | C144395 | LCSC
53 | 1 | CDSOT23-SM712-ES | U19 | SOT-23-3_L2.9-W1.3-P1.90-LS2.4-BR |  | CDSOT23-SM712-ES | ElecSuper(静芯) | C5199207 | LCSC
