jeroenweij/ClimateControl/Hardware/Thermostat/BOM.csv

No. | Quantity | Comment | Designator | Footprint | Value | Manufacturer Part | Manufacturer | Supplier Part | Supplier
1 | 2 | Order but do not assemble | B1,B2 | ms:SLP3_150_100_F | SLP3-150-100-F |  |  |  | Bivar
2 | 4 | 100nF | C1,C12,C15,C24 | C0402 | 100nF | CL05B104KO5NNNC | SAMSUNG(三星) | C1525 | LCSC
3 | 4 | 1uF | C2,C3,C5,C6 | C0402 | 1uF | CL05A105KA5NQNC | SAMSUNG(三星) | C52923 | LCSC
4 | 1 | 22uF | C4 | C1206 | 22uF | CL31A226KAHNNNE | SAMSUNG(三星) | C12891 | LCSC
5 | 1 | 4.7uF | C7 | C0603 | 4.7uF | CL10A475KO8NNNC | SAMSUNG(三星) | C19666 | LCSC
6 | 2 | 1uF | C8,C9 | C0603 | 1uF | CL10A105KB8NNNC | SAMSUNG(三星) | C15849 | LCSC
7 | 1 | 47uF | C10 | CAP-SMD_BD6.3-L6.6-W6.6-LS7.2-FD | 47uF | SVZ1VM470E06E00RAXXX | AISHI(艾华集团) | C721322 | LCSC
8 | 3 | 2.2uF | C11,C13,C14 | C0603 | 2.2uF | CL10A225KO8NNNC | SAMSUNG(三星) | C23630 | LCSC
9 | 1 | 10uF | C17 | C0603 | 10uF | CL10A106MA8NRNC | SAMSUNG(三星) | C96446 | LCSC
10 | 2 | DNP | C18,C23 | C0603 | DNP | DNP | DNP |  | DNP
11 | 1 | 10nF | C22 | C0402 | 10nF | CL05B103KB5NNNC | SAMSUNG(三星) | C15195 | LCSC
12 | 1 | 1N5819WS | D2 | SOD-323_L1.8-W1.3-LS2.5-RD |  | 1N5819WS | Hottech(合科泰) | C191023 | LCSC
13 | 1 | TPESD8004MUTAG | D3 | DFN2510-10_L2.5-W1.0-P0.50-BL |  | TPESD8004MUTAG | TECH PUBLIC(台舟) | C2827679 | LCSC
14 | 1 | 1206L020YR | F1 | F1206 |  | 1206L020YR | Littelfuse(美国力特) | C207035 | LCSC
15 | 4 | HOLE | H1,H2,H3,H4 | HOLEHOLE
16 | 1 | DNP | H6 | HDR-TH_4P-P2.54-V-M-1 |  | DNP | DNP | DNP | DNP
17 | 1 | KT-0805Y | LED2 | LED0805-R-RD |  | KT-0805Y | KENTO | C2296 | LCSC
18 | 1 | NCD0805R1 | LED3 | LED0805-RD |  | NCD0805R1 | 国星光电 | C84256 | LCSC
19 | 1 | FDN338P | Q3 | SOT-23-3_L2.9-W1.3-P1.90-LS2.4-BR |  | FDN338P | HUASHUO(华朔) | C518789 | LCSC
20 | 1 | FDN335N | Q4 | SOT-23-3_L2.9-W1.3-P1.90-LS2.4-BR |  | FDN335N | HUASHUO(华朔) | C845588 | LCSC
21 | 1 | 120Ω | R1 | R0402 | 120Ω | 0402WGF1200TCE | UNI-ROYAL(厚声) | C25079 | LCSC
22 | 3 | 10kΩ | R2,R6,R15 | R0402 | 10kΩ | 0402WGF1002TCE | UNI-ROYAL(厚声) | C25744 | LCSC
23 | 2 | 47kΩ | R3,R4 | R0402 | 47kΩ | 0402WGF4702TCE | UNI-ROYAL(厚声) | C25792 | LCSC
24 | 2 | 4.7kΩ | R5,R11 | R0402 | 4.7kΩ | 0402WGF4701TCE | UNI-ROYAL(厚声) | C25900 | LCSC
25 | 2 | 330Ω | R7,R8 | R0402 | 330Ω | 0402WGF3300TCE | UNI-ROYAL(厚声) | C25104 | LCSC
26 | 1 | 620kΩ | R9 | R0402 | 620kΩ | FRC0402F6203TS | FOJAN(富捷) | C2909373 | LCSC
27 | 1 | DNP | R17 | R0603 | DNP | DNP | DNP
28 | 2 | 10Ω | R18,R19 | R0402 | 10Ω | 0402WGF100JTCE | UNI-ROYAL(厚声) | C25077 | LCSC
29 | 1 | GT-TZ084B-H015-L1 | SW1 | SW-SMD_4P-L5.2-W5.2-P3.70-LS6.4 |  | GT-TZ084B-H015-L1 | G-Switch(品赞) | C29780122 | LCSC
30 | 1 | THVD2410DR | U1 | SOIC-8_L4.9-W3.9-P1.27-LS6.0-TL |  | THVD2410DR | TI(德州仪器) | C1849398 | LCSC
31 | 1 | STM32G031F8P6 | U2 | TSSOP-20_L6.5-W4.4-P0.65-LS6.4-BL |  | STM32G031F8P6 | ST(意法半导体) | C529334 | LCSC
32 | 2 | DNP | U3,U13 | SMD_RH-5015 |  | DNP | 荣和 |  | LCSC
33 | 1 | RT9080-33GJ5 | U4 | TSOT-23-5_L2.9-W1.6-P0.95-LS2.8-BL |  | RT9080-33GJ5 | RICHTEK(立锜) | C841192 | LCSC
34 | 1 | S4B-XH-SM4-TB(LF)(SN) | U5 | CONN-SMD_S4B-XH-SM4-TB-LF-SN |  | S4B-XH-SM4-TB(LF)(SN) | JST | C161861 | LCSC
35 | 1 | TC2030 | U6 | TAG-CONNECT_TC2030-IDC-NL
36 | 1 | CHT40MEMS | U7 | DFN-4_L1.5-W1.5-P0.8-TL-EP |  | CHT40MEMS | CYBERSEN(西博臣) | C54305346 | LCSC
37 | 1 | MD7218A38PA1 | U9 | SOT-89-3_L4.5-W2.5-P1.50-LS4.2-BR |  | MD7218A38PA1 | 明达微 | C920501 | LCSC
38 | 1 | CDSOT23-SM712-ES | U12 | SOT-23-3_L2.9-W1.3-P1.90-LS2.4-BR |  | CDSOT23-SM712-ES | ElecSuper(静芯) | C5199207 | LCSC
39 | 1 | X096-2864KSWPG01-H30 | U17 | OLED-SMD_X096-2864KSWPG01-H30 |  | X096-2864KSWPG01-H30 | Wisevision(新智景) | C18723026 | LCSC
40 | 1 | BS212C-1 | U18 | SOT-23-6_L2.9-W1.6-P0.95-LS2.9-BL |  | BS212C-1 | HOLTEK(合泰/盛群) | C42372571 | LCSC
