jeroenweij/ClimateControl/Hardware/MainController/BOM.csv

No. | Quantity | Comment | Designator | Footprint | Value | Manufacturer Part | Manufacturer | Supplier Part | Supplier
1 | 2 | 2.2uF | C1,C2 | C1206 | 2.2uF | CS3216X7R225K101NRI | SAMWHA(三和) | C920964 | LCSC
2 | 4 | 22uF | C3,C4,C5,C23 | C1206 | 22uF | CL31A226KAHNNNE | SAMSUNG(三星) | C12891 | LCSC
3 | 9 | 100nF | C6,C12,C13,C14,C16,C18,C19,C20,C21 | C0402 | 100nF | CL05B104KO5NNNC | SAMSUNG(三星) | C1525 | LCSC
4 | 1 | 47nF | C7 | C0402 | 47nF | TCC0402X7R473K500AT | CCTC(三环) | C880605 | LCSC
5 | 3 | 1uF | C8,C9,C22 | C0603 | 1uF | TCC0603X5R105M250CT | CCTC(三环) | C6266891 | LCSC
6 | 1 | 47uF | C10 | CAP-SMD_BD8.0-L8.3-W8.3-FD | 47uF | VP2A470M0810 | HONOR(荣誉) | C4054390 | LCSC
7 | 1 | 220uF | C11 | CAP-SMD_BD6.3-L6.6-W6.6-FD | 220uF | RVT220UF16V67RV0015 | KNSCHA(科尼盛) | C2887273 | LCSC
8 | 1 | 100nF | C15 | C0805 | 100nF | CL21B104KCFNNNE | SAMSUNG(三星) | C28233 | LCSC
9 | 1 | 10uF | C17 | C0603 | 10uF | CL10A106KP8NNNC | SAMSUNG(三星) | C19702 | LCSC
10 | 1 | SK36A | D1 | SMA_L4.4-W2.6-LS5.2-R-RD |  | SK36A | SMC(桑德斯) | C492931 | LCSC
11 | 1 | SS26A | D2 | SMA_L4.3-W2.5-LS5.0-RD |  | SS26A | FUXINSEMI(富芯森美) | C908236 | LCSC
12 | 1 | TPESD8004MUTAG | D3 | DFN2510-10_L2.5-W1.0-P0.50-BL |  | TPESD8004MUTAG | TECH PUBLIC(台舟) | C2827679 | LCSC
13 | 1 | SMCJ58A | D4 | SMC_L6.9-W5.9-LS7.9-RD |  | SMCJ58A | PAKER(派克微) | C3012585 | LCSC
14 | 1 | SMAJ58A | D5 | SMA_L4.3-W2.7-LS5.0-RD |  | SMAJ58A | GOODWORK(固得沃克) | C2980408 | LCSC
15 | 2 | PESD3V3L1BA,115-ES | D7,D8 | SOD-323_L1.7-W1.3-LS2.6-BI |  | PESD3V3L1BA,115-ES | ElecSuper(静芯) | C22379575 | LCSC
16 | 1 | SMD050F-2 | F1 | FUSE-SMD_L7.4-W5.1-1 |  | SMD050F-2 | Littelfuse(美国力特) | C428837 | LCSC
17 | 1 | PTF-77 | FH1 | FUSE-TH_L24.4-W9.4-P22.60 |  | PTF-77 | XFCN(兴飞) | C717030 | LCSC
18 | 1 | PZ2.54-2x2PLT-L11.0 Pin header | H1 | HDR-SMD_4P-P2.54-V-M-R2-C2-S7.5 |  | PZ2.54-2x2PLT-L11.0 Pin header | SHOU HAN(首韩) | C55213913 | LCSC
19 | 1 | 15uH | L1 | IND-SMD_L12.5-W12.5_RLF12545T | 15uH | SMDRI127-150MT | SXN(顺翔诺) | C40000 | LCSC
20 | 1 | TZ-P2-0603YGTCS1-0.6T | LED1 | LED0603-RD |  | TZ-P2-0603YGTCS1-0.6T | TUOZHAN(拓展光电) | C916074 | LCSC
21 | 1 | MHT192CGCT | LED2 | LED0603-RD_GREEN |  | MHT192CGCT | MEIHUA(美华) | C389518 | LCSC
22 | 1 | KT-0603R | LED3 | LED-SMD_L1.6-W0.8-R-RD |  | KT-0603R | KENTO | C2286 | LCSC
23 | 1 | WJ500V-5.08-03P-14-00A | P1 | CONN-TH_3P-P5.00_WJ500V-5.08-3P |  | WJ500V-5.08-03P-14-00A | KANGNEX(康奈克斯电气) | C72334 | LCSC
24 | 1 | BSS123LT1G | Q1 | SOT-23_L2.9-W1.3-P1.90-LS2.4-BR |  | BSS123LT1G | onsemi(安森美) | C78755 | LCSC
25 | 1 | 56.9kΩ | R1 | R0603 | 56.9kΩ | RT0603DRE0756K9L | YAGEO(国巨) | C863161 | LCSC
26 | 4 | 10kΩ | R2,R5,R11,R14 | R0402 | 10kΩ | FRC0402F1002TS | FOJAN(富捷) | C2906861 | LCSC
27 | 1 | 49.9kΩ | R3 | R0402 | 49.9kΩ | RC-02K4992FT | FH(风华) | C2838675 | LCSC
28 | 1 | 1.5MΩ | R4 | R1206 | 1.5MΩ | FRC1206F1504TS | FOJAN(富捷) | C2933600 | LCSC
29 | 4 | 330Ω | R6,R7,R8,R13 | R0402 | 330Ω | 0402WGF3300TCE | UNI-ROYAL(厚声) | C25104 | LCSC
30 | 1 | 10kΩ | R9 | R0402 | 10kΩ | 0402WGF1002TCE | UNI-ROYAL(厚声) | C25744 | LCSC
31 | 2 | 4.7kΩ | R10,R15 | R0402 | 4.7kΩ | 0402WGF4701TCE | UNI-ROYAL(厚声) | C25900 | LCSC
32 | 2 | 100Ω | R16,R17 | R0402 | 100Ω | RCA02100RJLF | HKR(香港电阻) | C22369194 | LCSC
33 | 2 | HC-WK88-H18-B | RJ1,RJ2 | RJ45-TH_HC-WK88-H18-B |  | HC-WK88-H18-B | HC(虹成电子) | C7501838 | LCSC
34 | 2 | GT-TZ084B-H015-L1 | SW1,SW2 | SW-SMD_4P-L5.2-W5.2-P3.70-LS6.4 |  | GT-TZ084B-H015-L1 | G-Switch(品赞) | C29780122 | LCSC
35 | 1 | LMR16030PDDAR | U1 | SOIC-8_L4.9-W3.9-P1.27-LS6.0-BL-EP |  | LMR16030PDDAR | TI(德州仪器) | C90665 | LCSC
36 | 1 | STM32G031F8P6 | U2 | TSSOP-20_L6.5-W4.4-P0.65-LS6.4-BL |  | STM32G031F8P6 | ST(意法半导体) | C529334 | LCSC
37 | 1 | DNP | U3 | SOT-23-3_L2.9-W1.3-P1.90-LS2.4-BR |  | DNP | DNP | DNP | DNP
38 | 1 | XC6206P332MR | U4 | SOT-23-3_L2.9-W1.6-P1.90-LS2.8-BR |  | XC6206P332MR | TECH PUBLIC(台舟) | C51886221 | LCSC
39 | 2 | BX-DG01V-5.0-3P5 | U5,U12 | CONN-TH_3P-P5.00 |  | BX-DG01V-5.0-3P5 | Bossie(博锡) | C49023132 | LCSC
40 | 1 | TC2030 | U6 | TAG-CONNECT_TC2030-IDC-NL
41 | 1 | THVD2410DR | U7 | SOIC-8_L4.9-W3.9-P1.27-LS6.0-TL |  | THVD2410DR | TI(德州仪器) | C1849398 | LCSC
42 | 4 | RH-5015 | U8,U9,U10,U11 | SMD_RH-5015 |  | RH-5015 | 荣和 | C5199798 | LCSC
43 | 3 | PAD_D3.3_M3Screw_1 | U13,U15,U16 | SMD_BD5.5-D3.9 |  | PAD_D3.3_M3Screw_1 |  | C9900016282 | LCSC
44 | 1 | NINA-W152-04B | U14 | WIFIM-SMD_NINA-W152-03B |  | NINA-W152-04B | U-BLOX(优北罗) | C6712555 | LCSC
45 | 1 | RT9080-33GJ5 | U17 | TSOT-23-5_L2.9-W1.6-P0.95-LS2.8-BL |  | RT9080-33GJ5 | RICHTEK(立锜) | C841192 | LCSC
