jeroenweij/ClimateControl/Hardware/Damper/3dFiles/DamperDrive_MainClamp_and_servo_mount.stl

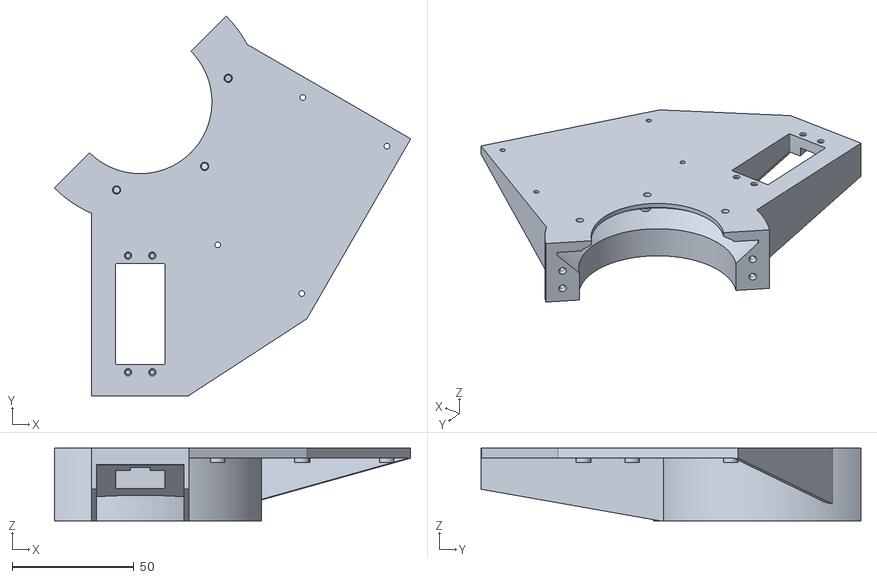
[picture p2: CAD file, 2026-10-04]
Hardware/Damper/3dFiles/DamperDrive_MainClamp_and_servo_mount.stl
146.7 x 156.4 x 30.0
