jeroenweij/ClimateControl/Hardware/Damper/3dFiles/DamperDrive_Pinoin.stl

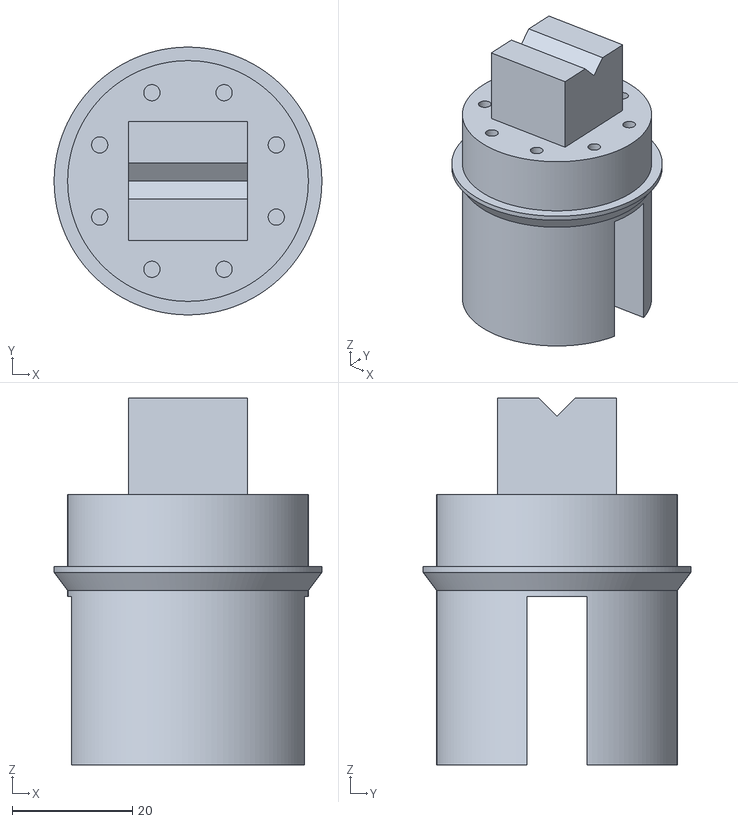
[picture p3: CAD file, 2026-10-04]
Hardware/Damper/3dFiles/DamperDrive_Pinoin.stl
44.5 x 44.5 x 61.0
