jeroenweij/ClimateControl/Hardware/Damper/3dFiles/DamperDrive_BigGear.stl

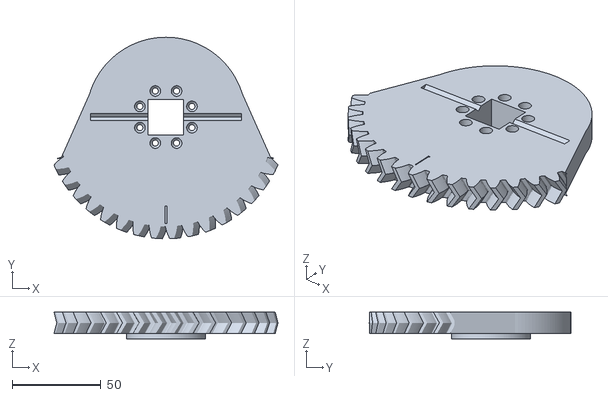
[picture p4: CAD file, 2026-10-04]
Hardware/Damper/3dFiles/DamperDrive_BigGear.stl
126.3 x 113.6 x 15.0
