jeroenweij/ClimateControl/Hardware/Damper/3dFiles/DamperDrive_Bearing_retainer.stl

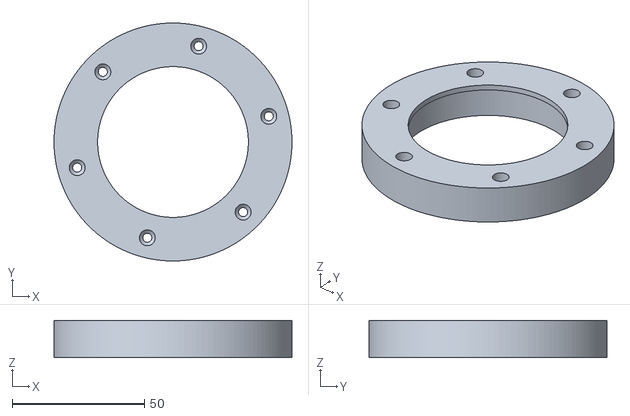
[picture p5: CAD file, 2026-10-04]
Hardware/Damper/3dFiles/DamperDrive_Bearing_retainer.stl
90.0 x 90.0 x 14.0
