jeroenweij/ClimateControl/Hardware/Damper/3dFiles/DamperDrive_Clamp.stl

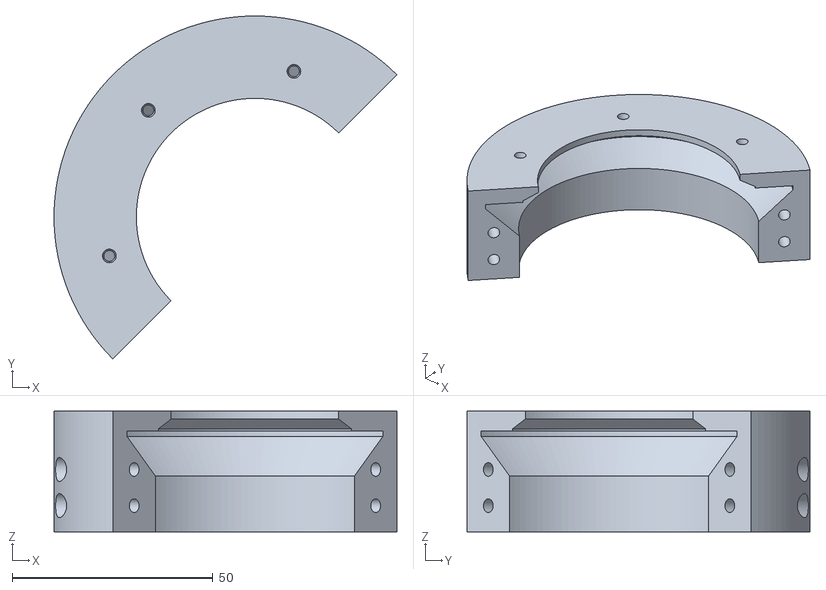
[picture p6: CAD file, 2026-10-04]
Hardware/Damper/3dFiles/DamperDrive_Clamp.stl
85.4 x 85.4 x 30.0
