jeroenweij/ClimateControl/Hardware/Damper/3dFiles/DamperDrive_SmallGear.stl

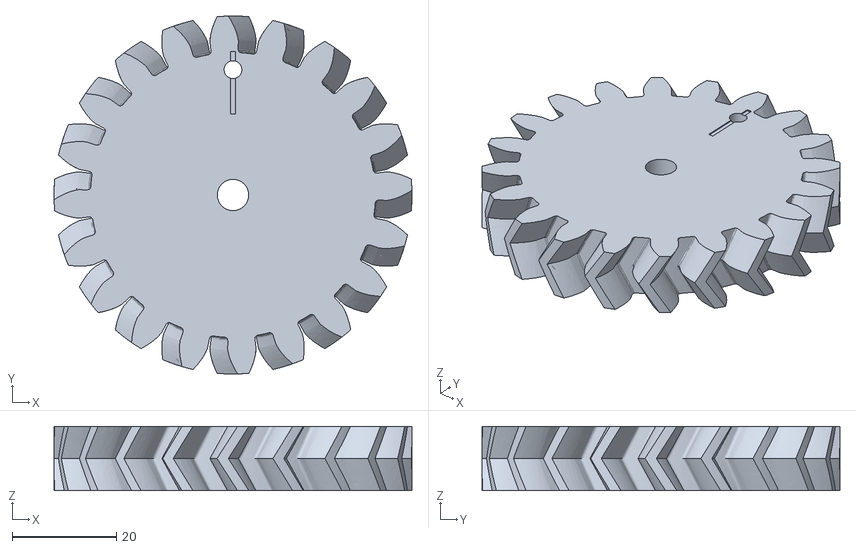
[picture p7: CAD file, 2026-10-04]
Hardware/Damper/3dFiles/DamperDrive_SmallGear.stl
68.6 x 68.6 x 12.4
