jeroenweij/ClimateControl/Hardware/Damper/Assembly images/Full.png

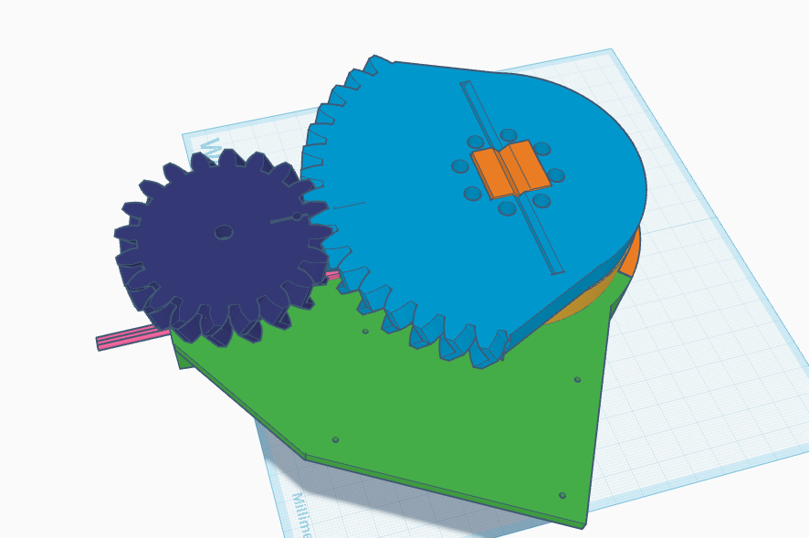
Hardware/Damper/Assembly images/Full.png
