jeroenweij/ClimateControl/Hardware/Damper/Assembly images/Showing pipe and bearing.png

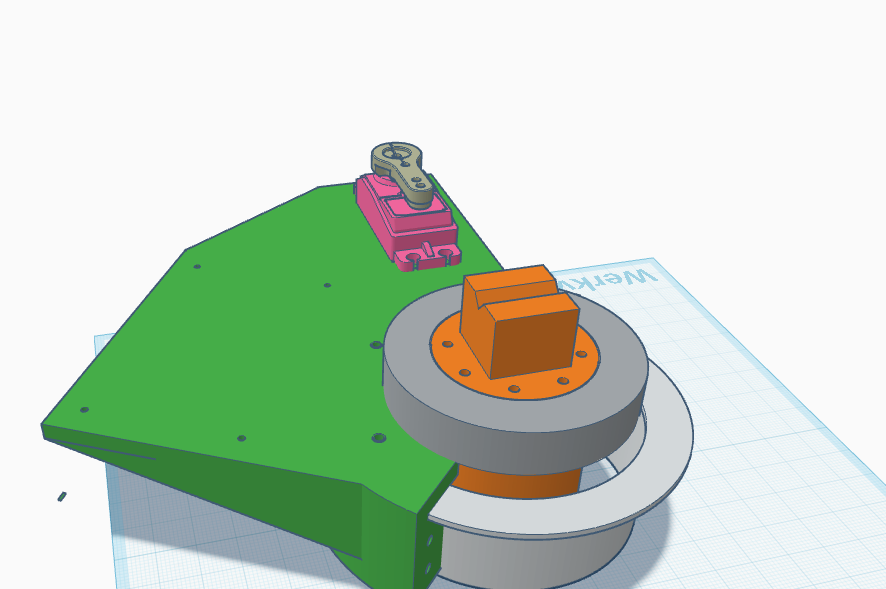
Hardware/Damper/Assembly images/Showing pipe and bearing.png
