jeroenweij/ClimateControl/Hardware/Damper/Assembly images/Without gears.png

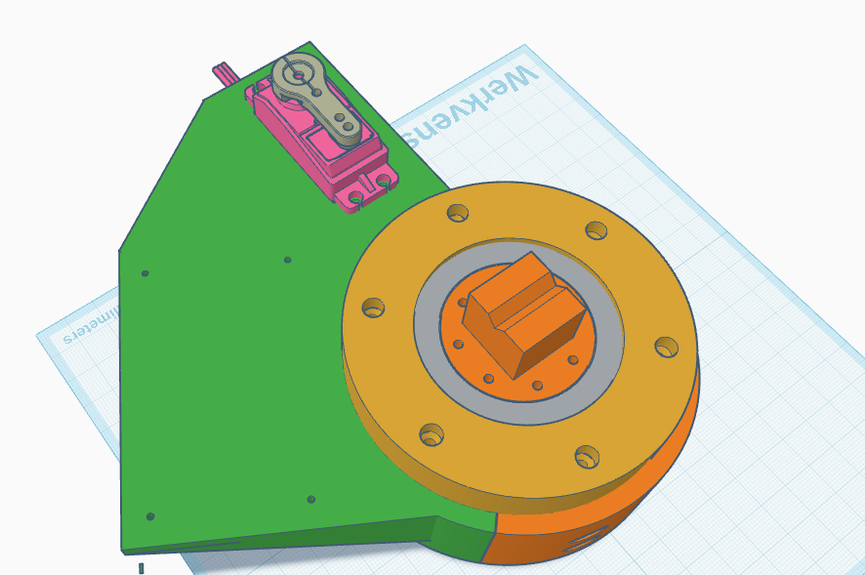
Hardware/Damper/Assembly images/Without gears.png
