jeroenweij/ClimateControl/Hardware/ControllerNode/SCH.pdf

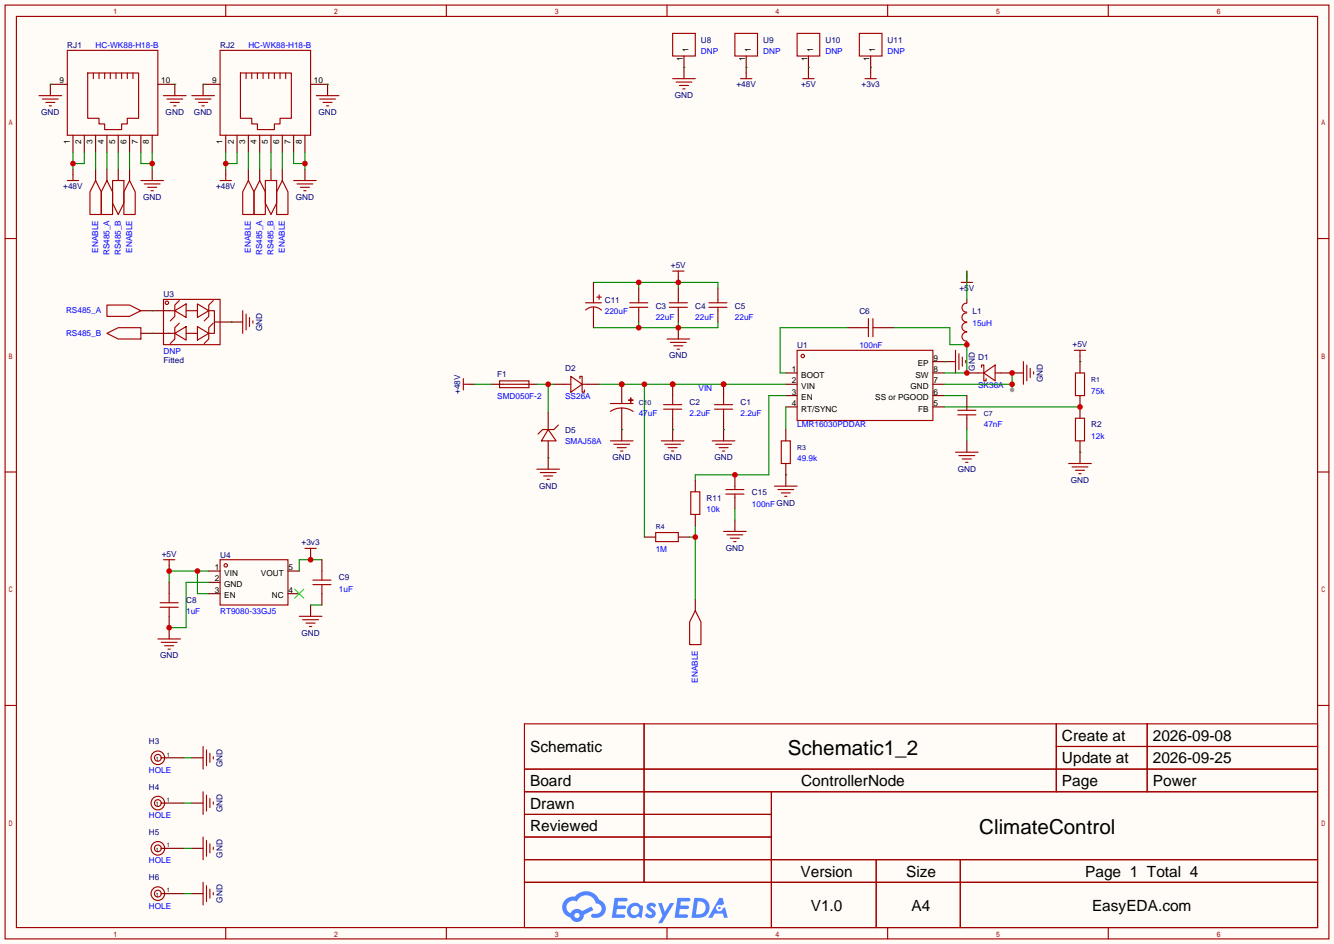
[picture p11: page 1]

Schematic | Schematic1_2 | Create at | 2026-09-08

Update at | 2026-09-25

Board | ControllerNode | Page | Power
Drawn | | ClimateControl
Reviewed

Version | Size | Page 1 Total 4
V1.0 | A4 | EasyEDA.com

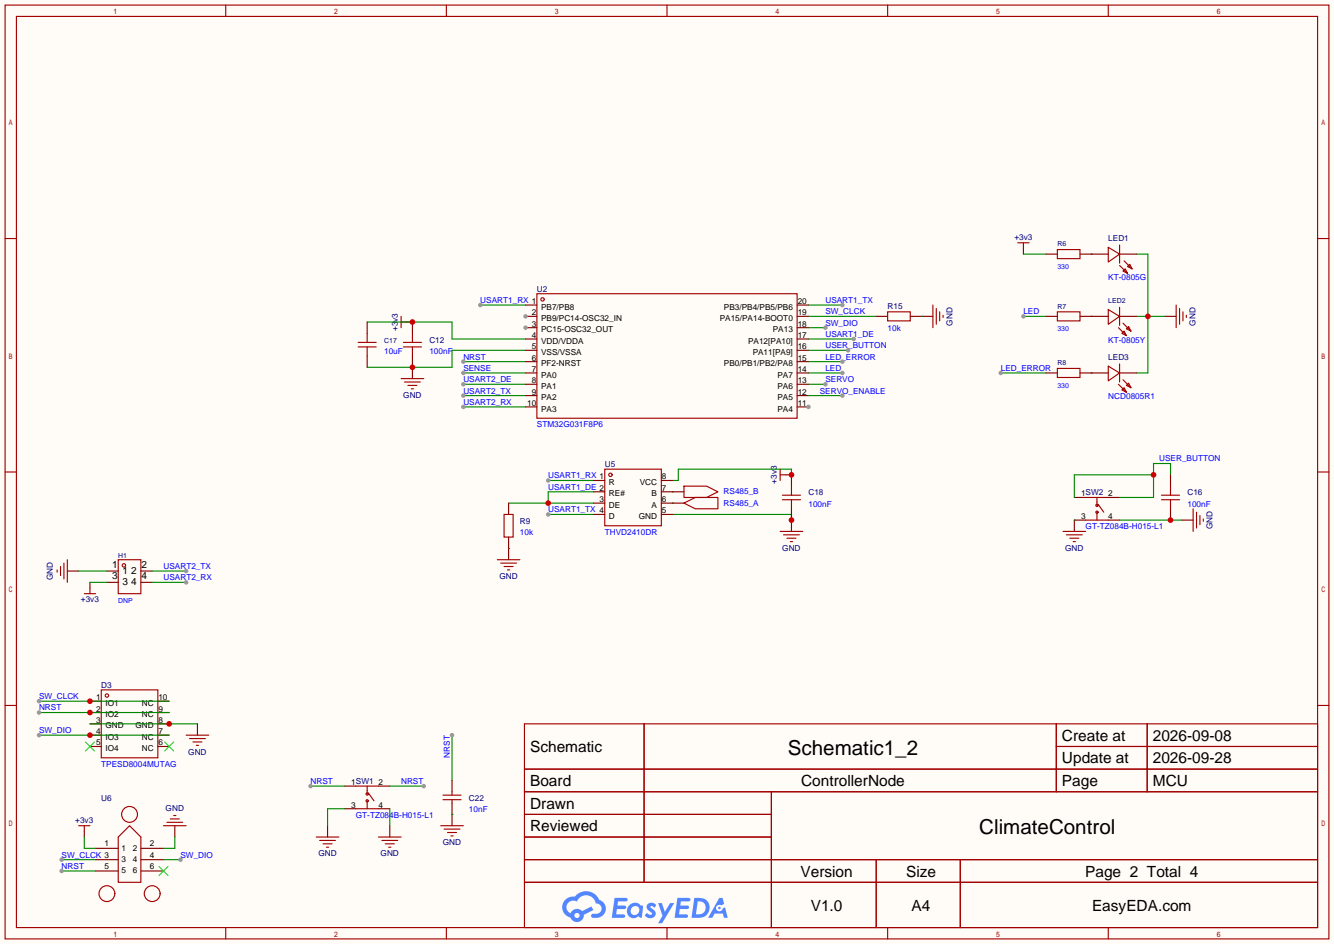
[picture p12: page 2]

Schematic | Schematic1_2 | Create at | 2026-09-08

Update at | 2026-09-28

Board | ControllerNode | Page | MCU
Drawn | | ClimateControl
Reviewed

# RS485_T_A RS⁴⁸⁵_T_A

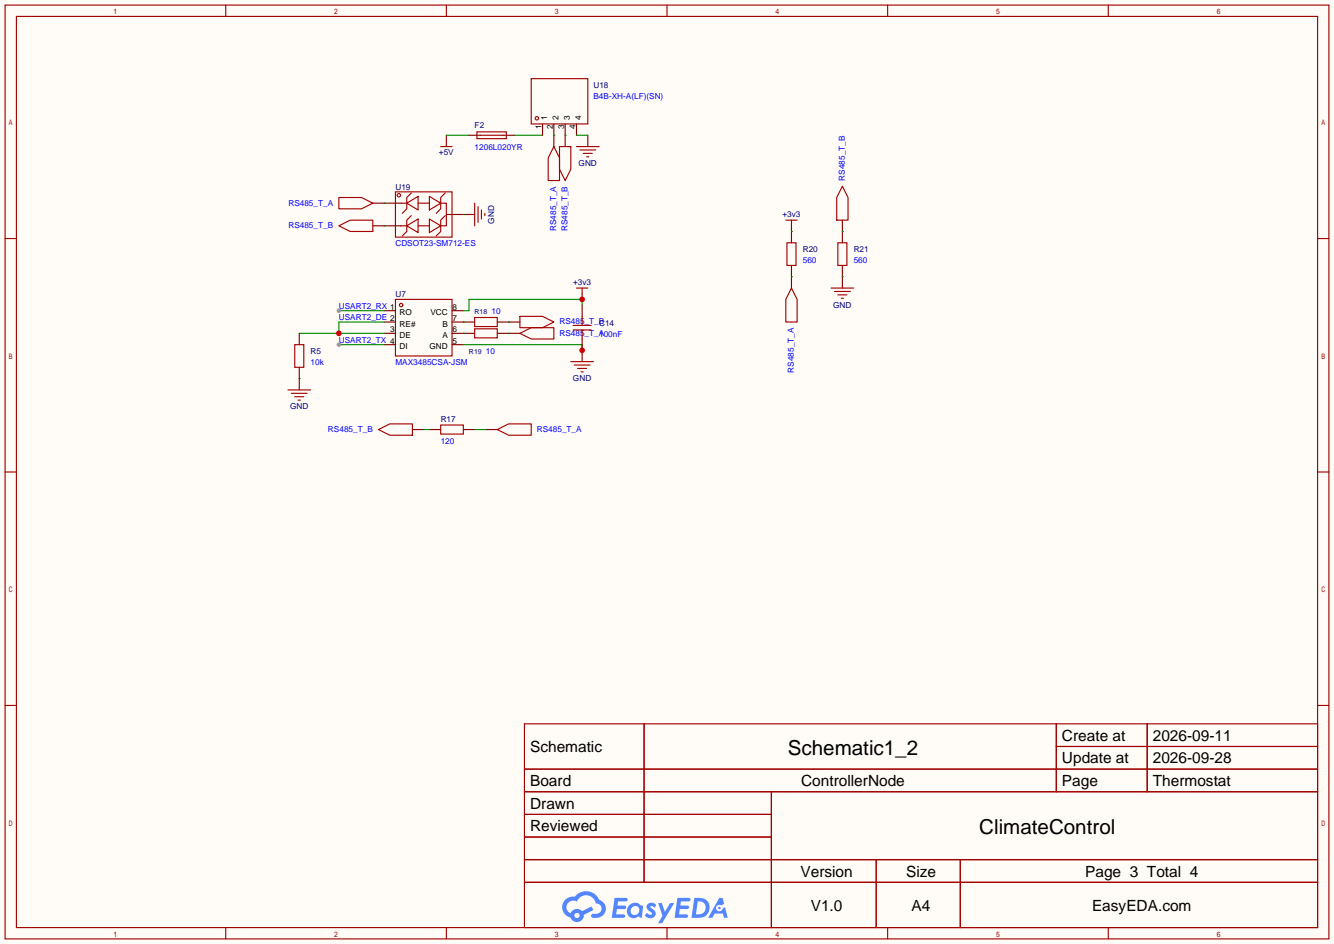
[picture p13: page 3]

Schematic | Schematic1_2 | Create at | 2026-09-11

Update at | 2026-09-28

Board | ControllerNode | Page | Thermostat
Drawn | | ClimateControl
Reviewed

# SERVO_GNDGND

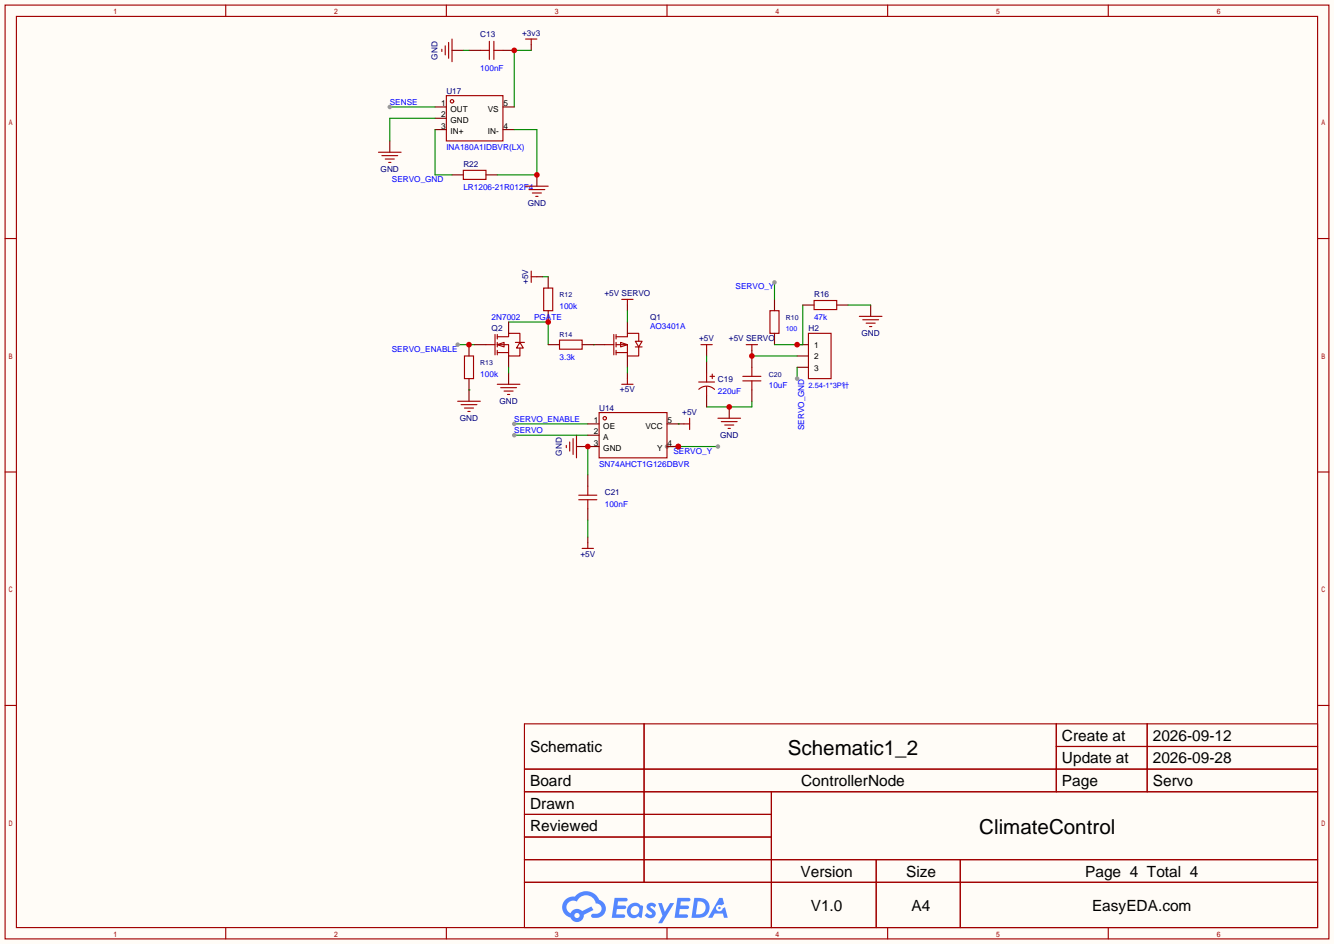
[picture p14: page 4]

Schematic | Schematic1_2 | Create at | 2026-09-12

Update at | 2026-09-28

Board | ControllerNode | Page | Servo
Drawn | | ClimateControl
Reviewed
