jeroenweij/ClimateControl/Hardware/Thermostat/PCB.pdf

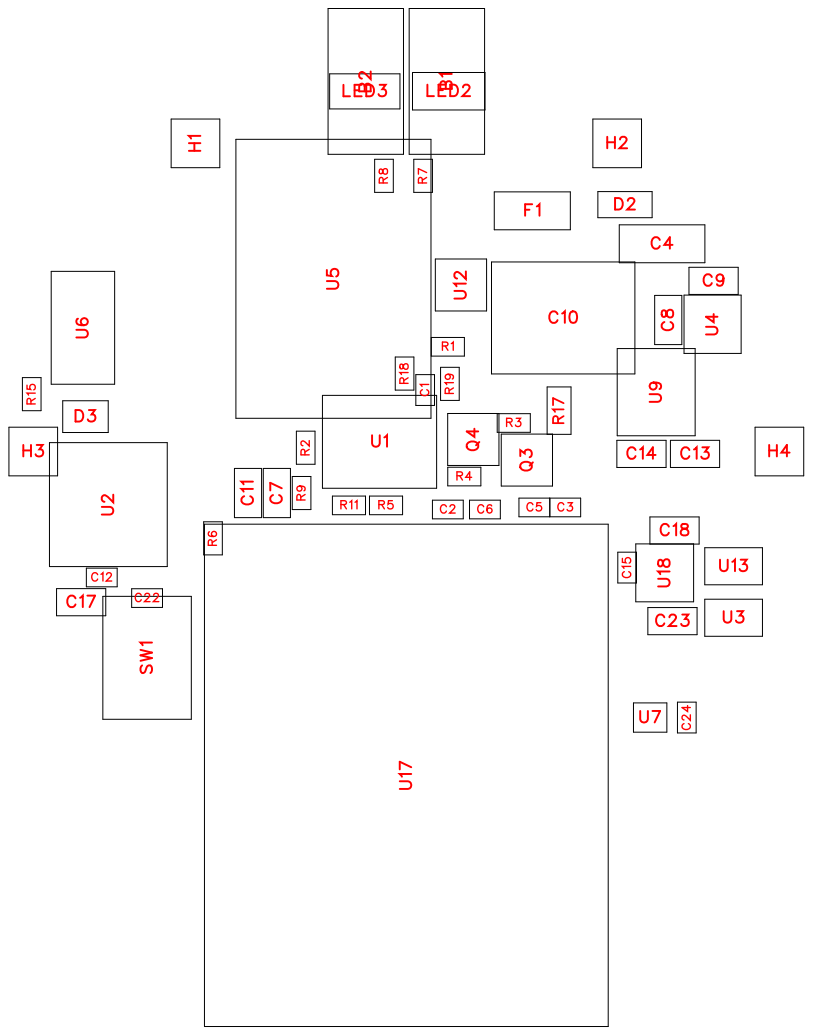
[picture p15: page 1]

H6

No. | Quantity | Comment | Designator | Footprint | Value | Manufacturer Part | Manufacturer | Supplier Part | Supplier
1 | 2 | Order but do not assemble | B1,B2 | ms:SLP3_15 0_100_F | SLP3-150-10 0-F | | | | Bivar
2 | 4 | 100nF | C1,C12,C15,C24 | C0402 | 100nF | CL05B104K O5NNNC | SAMSUNG( 三星) | C1525 | LCSC
3 | 4 | 1uF | C2,C3,C5,C6 | C0402 | 1uF | CL05A105KA 5NQNC | SAMSUNG( 三星) | C52923 | LCSC
4 | 1 | 22uF | C4 | C1206 | 22uF | CL31A226KA HNNNE | SAMSUNG( 三星) | C12891 | LCSC
5 | 1 | 4.7uF | C7 | C0603 | 4.7uF | CL10A475K O8NNNC | SAMSUNG( 三星) | C19666 | LCSC
6 | 2 | 1uF | C8,C9 | C0603 | 1uF | CL10A105KB 8NNNC | SAMSUNG( 三星) | C15849 | LCSC
7 | 1 | 47uF | C10 | CAP-SMD_B D6.3-L6.6-W 6.6-LS7.2-FD | 47uF | SVZ1VM470 E06E00RAX XX | AISHI(艾华集 团) | C721322 | LCSC
8 | 3 | 2.2uF | C11,C13,C14 | C0603 | 2.2uF | CL10A225K O8NNNC | SAMSUNG( 三星) | C23630 | LCSC
9 | 1 | 10uF | C17 | C0603 | 10uF | CL10A106M A8NRNC | SAMSUNG( 三星) | C96446 | LCSC
10 | 2 | DNP | C18,C23 | C0603 | DNP | DNP | DNP | | DNP
11 | 1 | 10nF | C22 | C0402 | 10nF | CL05B103KB 5NNNC | SAMSUNG( 三星) | C15195 | LCSC
12 | 1 | 1N5819WS | D2 | SOD-323_L1 .8-W1.3-LS2. 5-RD | | 1N5819WS | Hottech(合科 泰) | C191023 | LCSC
13 | 1 | TPESD8004 MUTAG | D3 | DFN2510-10 _L2.5-W1.0-P0.50-BL | | TPESD8004 MUTAG | TECH PUBLI C(台舟) | C2827679 | LCSC
14 | 1 | 1206L020YR | F1 | F1206 | | 1206L020YR | Littelfuse(美 国力特) | C207035 | LCSC
15 | 4 | HOLE | H1,H2,H3,H4 | HOLEHOLE
16 | 1 | DNP | H6 | HDR-TH_4P-P2.54-V-M-1 | | DNP | DNP | DNP | DNP
17 | 1 | KT-0805Y | LED2 | LED0805-R-RD | | KT-0805Y | KENTO | C2296 | LCSC
18 | 1 | NCD0805R1 | LED3 | LED0805-RD | | NCD0805R1 | 国星光电 | C84256 | LCSC
19 | 1 | FDN338P | Q3 | SOT-23-3_L2 .9-W1.3-P1.9 0-LS2.4-BR | | FDN338P | HUASHUO( 华朔) | C518789 | LCSC
20 | 1 | FDN335N | Q4 | SOT-23-3_L2 .9-W1.3-P1.9 0-LS2.4-BR | | FDN335N | HUASHUO( 华朔) | C845588 | LCSC
21 | 1 | 120 | R1 | R0402 | 120 | 0402WGF12 00TCE | UNI-ROYAL( 厚声) | C25079 | LCSC
22 | 3 | 10k | R2,R6,R15 | R0402 | 10k | 0402WGF10 02TCE | UNI-ROYAL( 厚声) | C25744 | LCSC

23 | 2 | 47k | R3,R4 | R0402 | 47k | 0402WGF47 02TCE | UNI-ROYAL( 厚声 ) | C25792 | LCSC
24 | 2 | 4.7k | R5,R11 | R0402 | 4.7k | 0402WGF47 01TCE | UNI-ROYAL( ) 厚声 | C25900 | LCSC
25 | 2 | 330 | R7,R8 | R0402 | 330 | 0402WGF33 00TCE | UNI-ROYAL( ) 厚声 | C25104 | LCSC
26 | 1 | 620k | R9 | R0402 | 620k | FRC0402F62 03TS | FOJAN(富捷 ) | C2909373 | LCSC
27 | 1 | DNP | R17 | R0603 | DNP | DNP | DNP
28 | 2 | 10 | R18,R19 | R0402 | 10 | 0402WGF10 0JTCE | UNI-ROYAL( 厚声 ) | C25077 | LCSC
29 | 1 | GT-TZ084B-H015-L1 | SW1 | SW-SMD_4P -L5.2-W5.2-P 3.70-LS6.4 | | GT-TZ084B-H015-L1 | G-Switch( 品 ) 赞 | C29780122 | LCSC
30 | 1 | THVD2410D R | U1 | SOIC-8_L4.9 -W3.9-P1.27-LS6.0-TL | | THVD2410D R | TI(德州仪器 ) | C1849398 | LCSC
31 | 1 | STM32G031 F8P6 | U2 | TSSOP-20_L 6.5-W4.4-P0. 65-LS6.4-BL | | STM32G031 F8P6 | ST(意法半导 体) | C529334 | LCSC
32 | 2 | DNP | U3,U13 | SMD_RH-50 15 | | DNP | 荣和 | | LCSC
33 | 1 | RT9080-33G J5 | U4 | TSOT-23-5_ L2.9-W1.6-P 0.95-LS2.8-B L | | RT9080-33G J5 | RICHTEK( 立 锜 ) | C841192 | LCSC
34 | 1 | S4B-XH-SM4 -TB(LF)(SN) | U5 | CONN-SMD_ S4B-XH-SM4 -TB-LF-SN | | S4B-XH-SM4 -TB(LF)(SN) | JST | C161861 | LCSC
35 | 1 | TC2030 | U6 | TAG-CONNE CT_TC2030-I DC-NL
36 | 1 | CHT40MEM S | U7 | DFN-4_L1.5-W1.5-P0.8-T L-EP | | CHT40MEM S | CYBERSEN( 西博臣 ) | C54305346 | LCSC
37 | 1 | MD7218A38 PA1 | U9 | SOT-89-3_L4 .5-W2.5-P1.5 0-LS4.2-BR | | MD7218A38 PA1 | 明达微 | C920501 | LCSC
38 | 1 | CDSOT23-S M712-ES | U12 | SOT-23-3_L2 .9-W1.3-P1.9 0-LS2.4-BR | | CDSOT23-S M712-ES | ElecSuper( 静 芯 ) | C5199207 | LCSC
39 | 1 | X096-2864K SWPG01-H3 0 | U17 | OLED-SMD_ X096-2864K SWPG01-H3 0 | | X096-2864K SWPG01-H3 0 | Wisevision( 新智景 ) | C18723026 | LCSC
40 | 1 | BS212C-1 | U18 | SOT-23-6_L2 .9-W1.6-P0.9 5-LS2.9-BL | | BS212C-1 | HOLTEK( 合 泰 /盛群 ) | C42372571 | LCSC

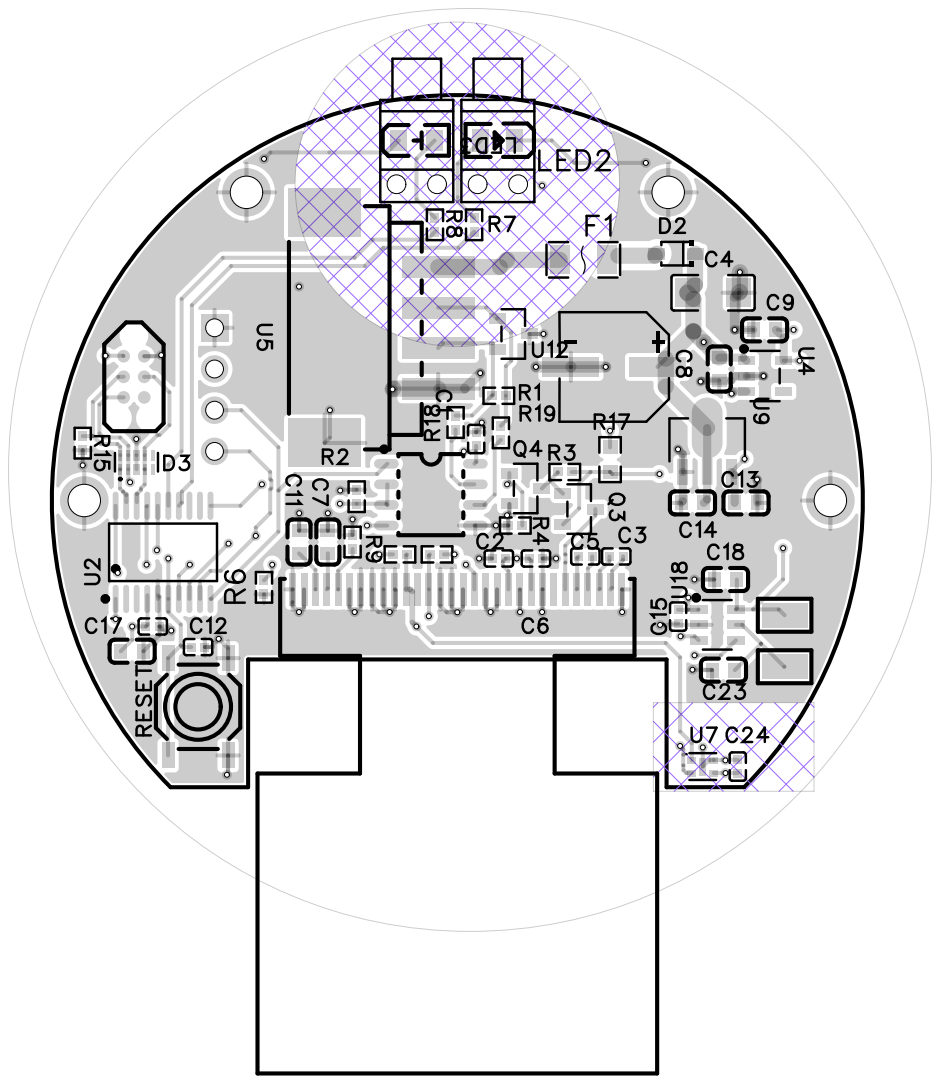
[picture p16: page 5]

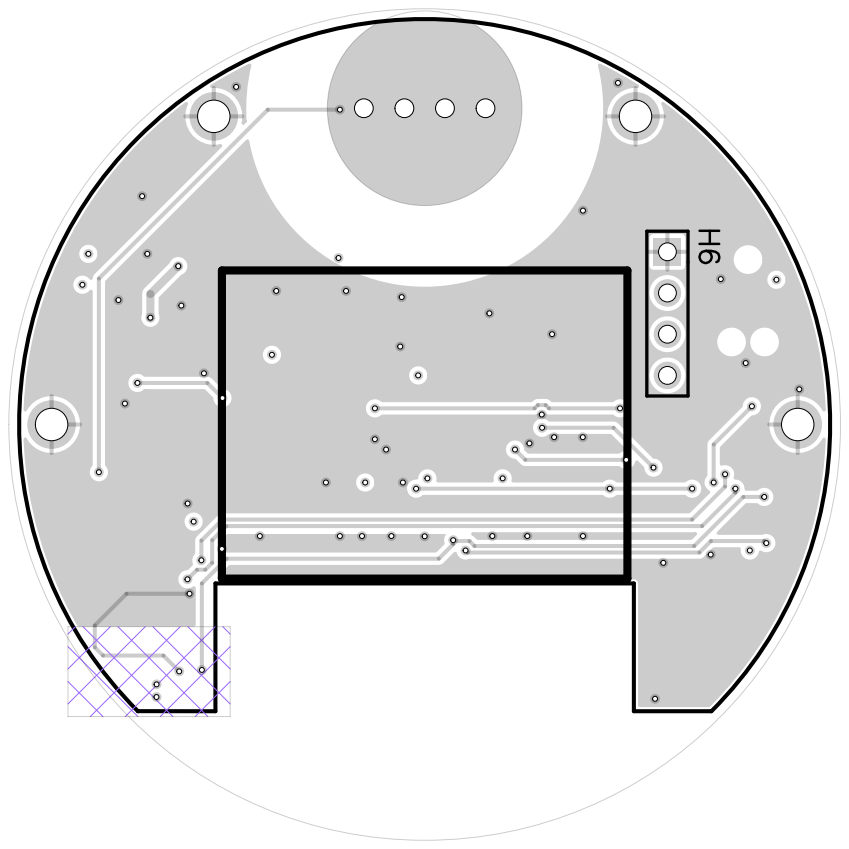
[picture p17: page 6]

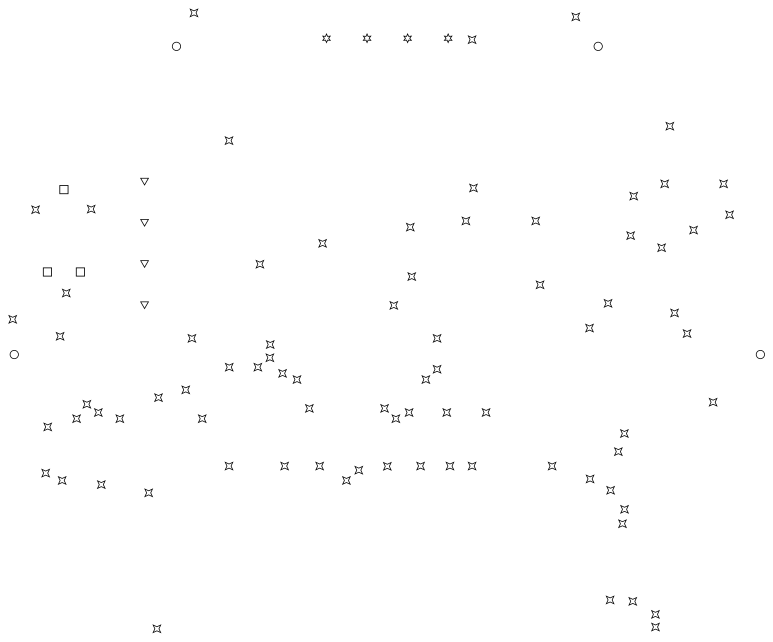
[picture p18: page 7]
