jeroenweij/ClimateControl/Hardware/Thermostat/SCH.pdf

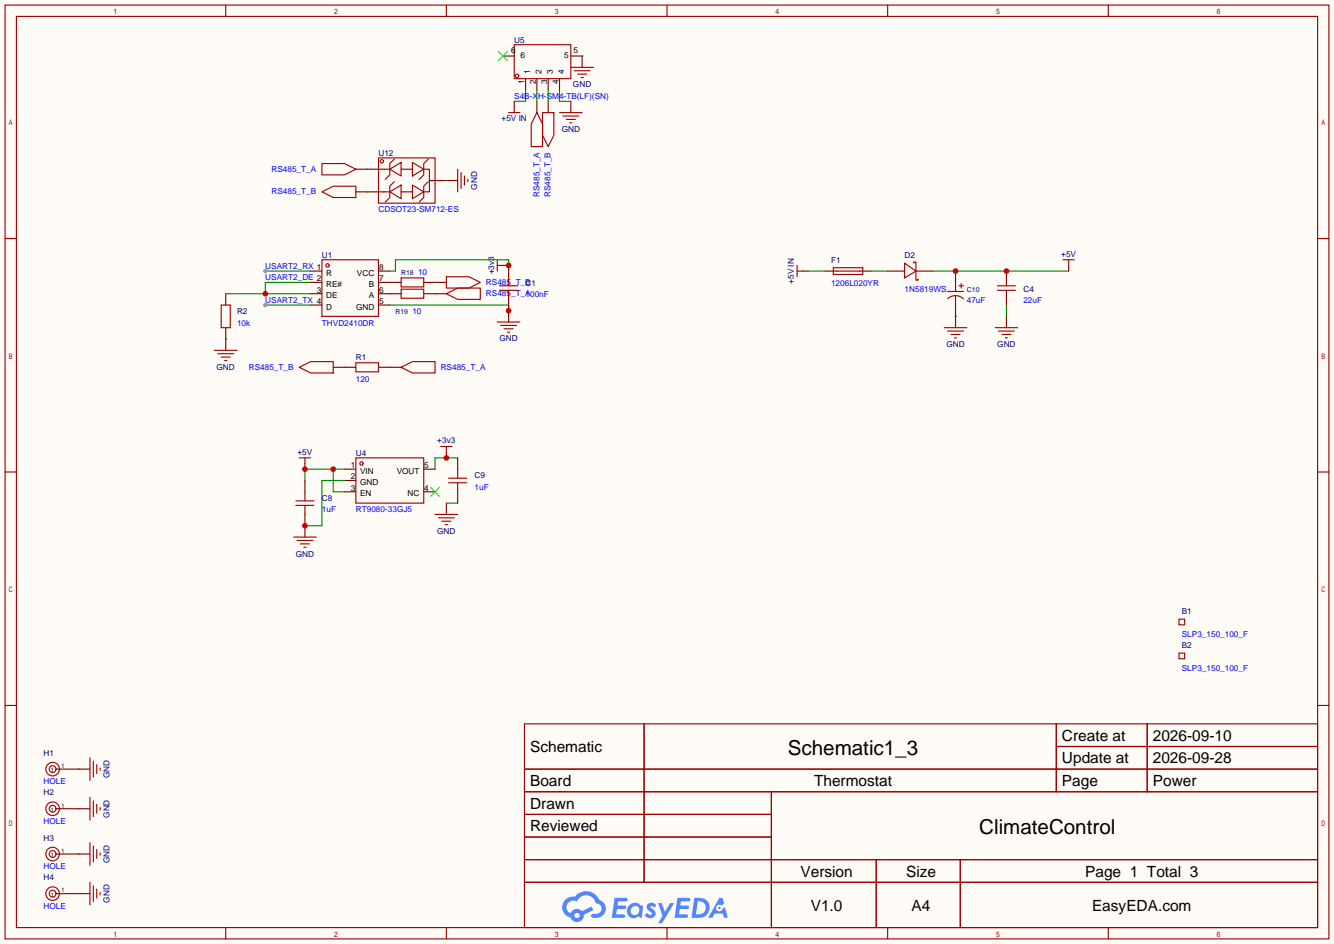
[picture p19: page 1]

Schematic | Schematic1_3 | Create at | 2026-09-10

Update at | 2026-09-28

Board | Thermostat | Page | Power
Drawn | | ClimateControl
Reviewed

Version | Size | Page 1 Total 3
V1.0 | A4 | EasyEDA.com

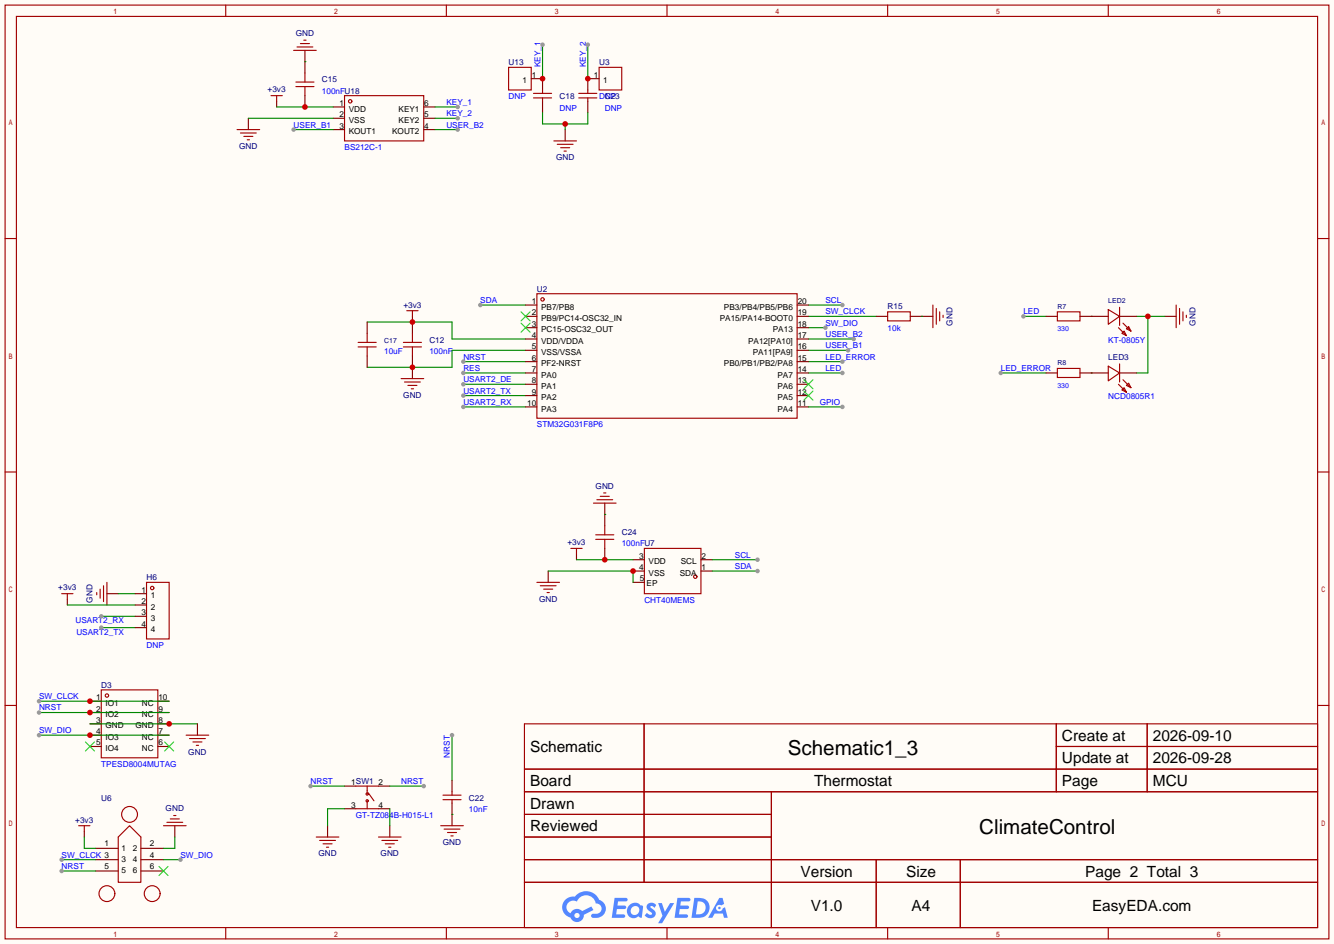
[picture p20: page 2]

Schematic | Schematic1_3 | Create at | 2026-09-10

Update at | 2026-09-28

Board | Thermostat | Page | MCU
Drawn | | ClimateControl
Reviewed

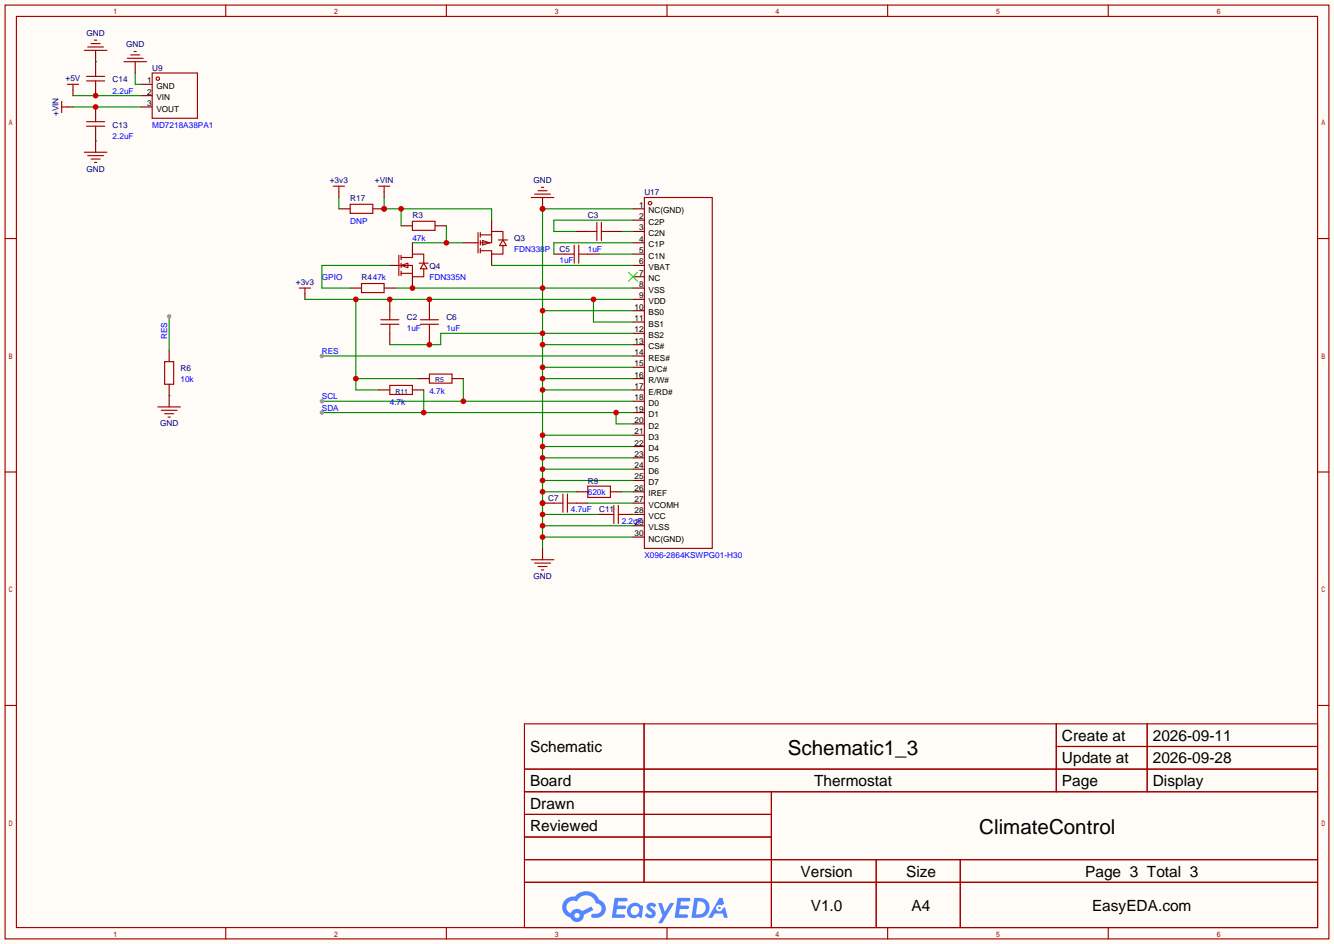
[picture p21: page 3]

Schematic | Schematic1_3 | Create at | 2026-09-11

Update at | 2026-09-28

Board | Thermostat | Page | Display
Drawn | | ClimateControl
Reviewed
