jeroenweij/ClimateControl/Hardware/MainController/SCH.pdf

# RS485_A RS⁴⁸⁵_A RS⁴⁸⁵_B

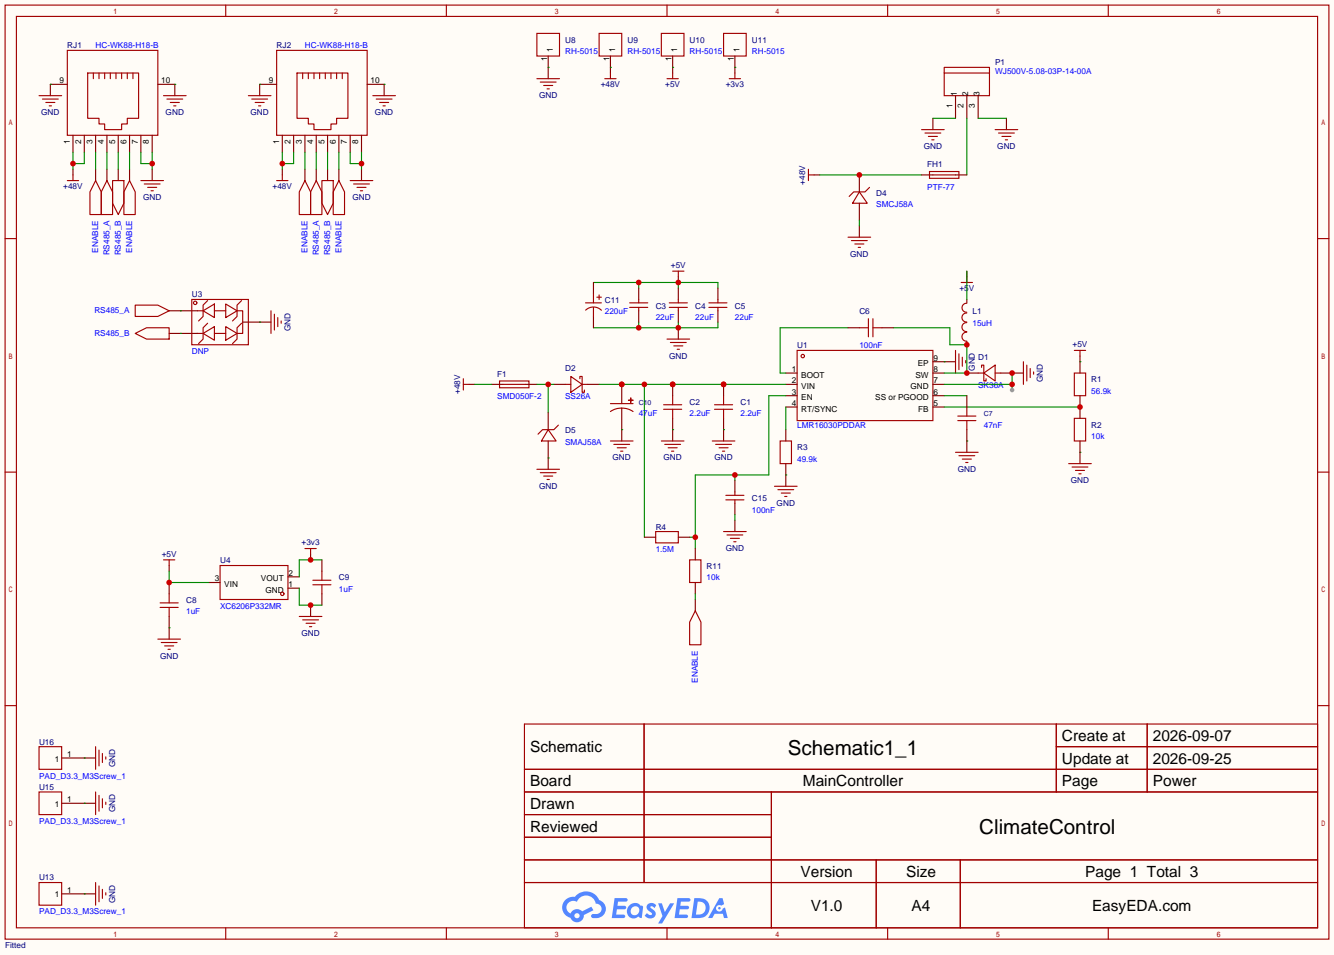
[picture p27: page 1]

Schematic | Schematic1_1 | Create at | 2026-09-07

Update at | 2026-09-25

Board | MainController | Page | Power
Drawn | | ClimateControl
Reviewed

Version | Size | Page 1 Total 3
V1.0 | A4 | EasyEDA.com

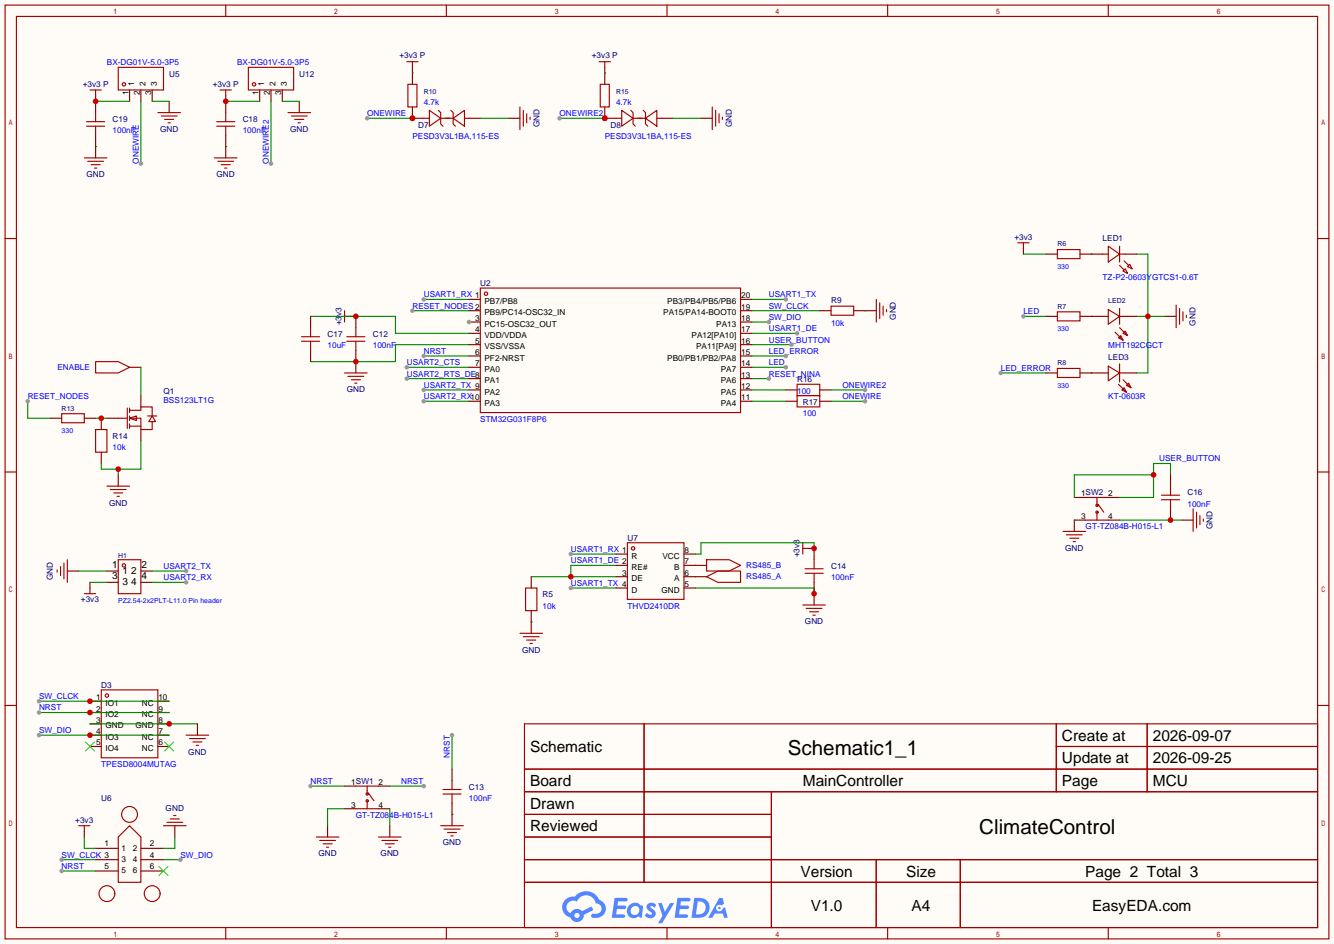
[picture p28: page 2]

Schematic | Schematic1_1 | Create at | 2026-09-07

Update at | 2026-09-25

Board | MainController | Page | MCU
Drawn | | ClimateControl
Reviewed

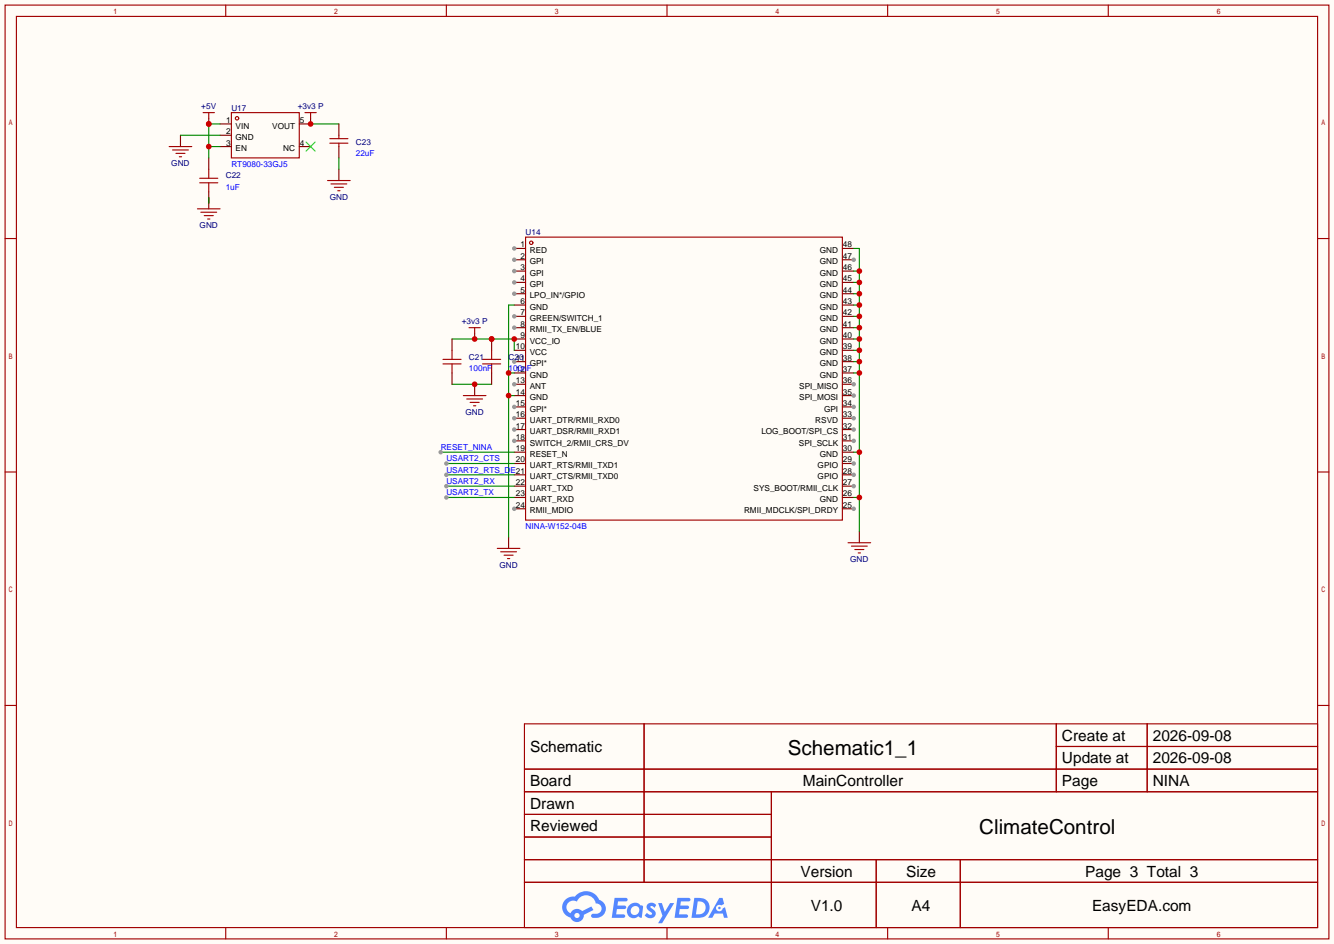
[picture p29: page 3]

Schematic | Schematic1_1 | Create at | 2026-09-08

Update at | 2026-09-08

Board | MainController | Page | NINA
Drawn | | ClimateControl
Reviewed
