jeroenweij/ClimateControl/Hardware/ControllerNode/PCB.pdf

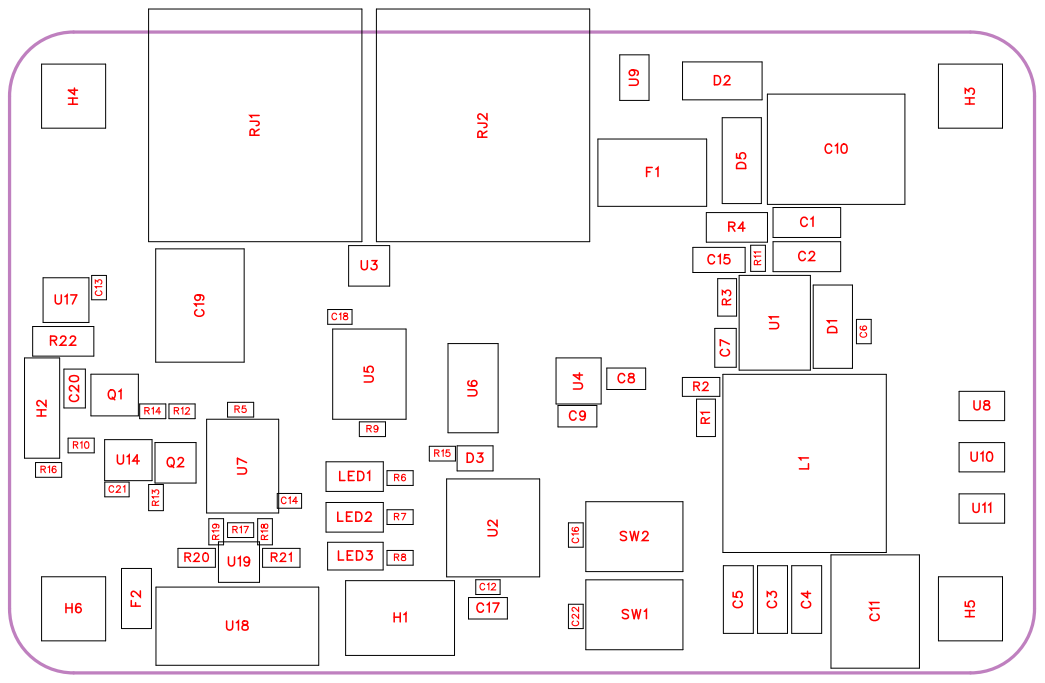
[picture p30: page 1]

No. | Quantity | Comment | Designator | Footprint | Value | Manufacturer Part | Manufacturer | Supplier Part | Supplier
1 | 2 | 2.2uF | C1,C2 | C1206 | 2.2uF | CS3216X7R 225K101NRI | SAMWHA(三 和) | C920964 | LCSC
2 | 3 | 22uF | C3,C4,C5 | C1206 | 22uF | CL31A226KA HNNNE | SAMSUNG( 三星) | C12891 | LCSC
3 | 7 | 100nF | C6,C12,C13,C14,C16,C18, C21 | C0402 | 100nF | CL05B104K O5NNNC | SAMSUNG( 三星) | C1525 | LCSC
4 | 1 | 47nF | C7 | C0603 | 47nF | CL10B473KB 8NNNC | SAMSUNG( 三星) | C1622 | LCSC
5 | 2 | 1uF | C8,C9 | C0603 | 1uF | CL10A105KB 8NNNC | SAMSUNG( 三星) | C15849 | LCSC
6 | 1 | 47uF | C10 | CAP-SMD_B D8.0-L8.3-W 8.3-FD | 47uF | VP2A470M0 810 | HONOR(荣誉 ) | C4054390 | LCSC
7 | 1 | 220uF | C11 | CAP-SMD_B D6.3-L6.6-W 6.6-FD | 220uF | RVT220UF1 6V67RV0015 | KNSCHA(科 尼盛) | C2887273 | LCSC
8 | 1 | 100nF | C15 | C0805 | 100nF | CL21B104K CFNNNE | SAMSUNG( 三星) | C28233 | LCSC
9 | 2 | 10uF | C17,C20 | C0603 | 10uF | CL10A106M A8NRNC | SAMSUNG( 三星) | C96446 | LCSC
10 | 1 | 220uF | C19 | CAP-SMD_B D6.3-L6.6-W 6.6-LS7.3-FD | 220uF | MA25V220M 6X8 | JIERR(捷而 瑞) | C46550464 | LCSC
11 | 1 | 10nF | C22 | C0402 | 10nF | CL05B103KB 5NNNC | SAMSUNG( 三星) | C15195 | LCSC
12 | 1 | SK36A | D1 | SMA_L4.4-W 2.6-LS5.2-R-RD | | SK36A | SMC(桑德斯) | C492931 | LCSC
13 | 1 | SS26A | D2 | SMA_L4.3-W 2.5-LS5.0-R D | | SS26A | FUXINSEMI( 富芯森美) | C908236 | LCSC
14 | 1 | TPESD8004 MUTAG | D3 | DFN2510-10 _L2.5-W1.0-P0.50-BL | | TPESD8004 MUTAG | TECH PUBLI C(台舟) | C2827679 | LCSC
15 | 1 | SMAJ58A | D5 | SMA_L4.3-W 2.7-LS5.0-R D | | SMAJ58A | GOODWOR K(固得沃克) | C2980408 | LCSC
16 | 1 | SMD050F-2 | F1 | FUSE-SMD_ L7.4-W5.1-1 | | SMD050F-2 | Littelfuse(美 国力特) | C428837 | LCSC
17 | 1 | 1206L020YR | F2 | F1206 | | 1206L020YR | Littelfuse(美 国力特) | C207035 | LCSC
18 | 1 | DNP | H1 | HDR-SMD_4 P-P2.54-V-M -R2-C2-S7.5 | | DNP | DNP | DNP | DNP
19 | 1 | 2.54-1*3P针 | H2 | HDR-TH_3P-P2.54-V-M-1 | | 2.54-1*3P针 | BOOMELE( 博穆精密) | C49257 | LCSC
20 | 4 | HOLE | H3,H4,H5,H6 | HOLEHOLE

21 | 1 | 15uH | L1 | IND-SMD_L1 2.5-W12.5_R LF12545T | 15uH | SMDRI127-1 50MT | SXN(顺翔诺 ) | C40000 | LCSC
22 | 1 | KT-0805G | LED1 | LED0805-R-RD | | KT-0805G | KENTO | C2297 | LCSC
23 | 1 | KT-0805Y | LED2 | LED0805-R-RD | | KT-0805Y | KENTO | C2296 | LCSC
24 | 1 | NCD0805R1 | LED3 | LED0805-RD | | NCD0805R1 | 国星光电 | C84256 | LCSC
25 | 1 | AO3401A | Q1 | SOT-23_L2.9 -W1.3-P1.90-LS2.4-BR | | AO3401A | AOS | C15127 | LCSC
26 | 1 | 2N7002 | Q2 | SOT-23-3_L2 .9-W1.3-P1.9 0-LS2.4-BR | | 2N7002 | CJ(江苏长电 / 长晶 ) | C8545 | LCSC
27 | 1 | 75k | R1 | R0603 | 75k | 0603WAF75 02T5E | UNI-ROYAL( 厚声 ) | C23242 | LCSC
28 | 1 | 12k | R2 | R0603 | 12k | 0603WAF12 02T5E | UNI-ROYAL( ) 厚声 | C22790 | LCSC
29 | 1 | 49.9k | R3 | R0603 | 49.9k | 0603WAF49 92T5E | UNI-ROYAL( ) 厚声 | C23184 | LCSC
30 | 1 | 1M | R4 | R1206 | 1M | 1206W4F100 4T5E | UNI-ROYAL( 厚声 ) | C17927 | LCSC
31 | 4 | 10k | R5,R9,R11,R15 | R0402 | 10k | 0402WGF10 02TCE | UNI-ROYAL( 厚声 ) | C25744 | LCSC
32 | 3 | 330 | R6,R7,R8 | R0402 | 330 | 0402WGF33 00TCE | UNI-ROYAL( 厚声 ) | C25104 | LCSC
33 | 1 | 100 | R10 | R0402 | 100 | 0402WGF10 00TCE | UNI-ROYAL( ) 厚声 | C25076 | LCSC
34 | 2 | 100k | R12,R13 | R0402 | 100k | 0402WGF10 03TCE | UNI-ROYAL( ) 厚声 | C25741 | LCSC
35 | 1 | 3.3k | R14 | R0402 | 3.3k | 0402WGF33 01TCE | UNI-ROYAL( 厚声 ) | C25890 | LCSC
36 | 1 | 47k | R16 | R0402 | 47k | 0402WGF47 02TCE | UNI-ROYAL( 厚声 ) | C25792 | LCSC
37 | 1 | 120 | R17 | R0402 | 120 | 0402WGF12 00TCE | UNI-ROYAL( 厚声 ) | C25079 | LCSC
38 | 2 | 10 | R18,R19 | R0402 | 10 | 0402WGF10 0JTCE | UNI-ROYAL( ) 厚声 | C25077 | LCSC
39 | 2 | 560 | R20,R21 | R0603 | 560 | 0603WAF56 00T5E | UNI-ROYAL( ) 厚声 | C23204 | LCSC
40 | 1 | LR1206-21R 012F4 | R22 | R1206 | | LR1206-21R 012F4 | RALEC(旺诠 ) | C154636 | LCSC
41 | 2 | HC-WK88-H 18-B | RJ1,RJ2 | RJ45-TH_HC -WK88-H18- B | | HC-WK88-H 18-B | HC(虹成电子 ) | C7501838 | LCSC
42 | 2 | GT-TZ084B-H015-L1 | SW1,SW2 | SW-SMD_4P -L5.2-W5.2-P 3.70-LS6.4 | | GT-TZ084B-H015-L1 | G-Switch( 品 赞 ) | C29780122 | LCSC

43 | 1 | LMR16030P DDAR | U1 | SOIC-8_L4.9 -W3.9-P1.27-LS6.0-BL-EP | LMR16030P DDAR | TI(德州仪器 ) | C90665 | LCSC
44 | 1 | STM32G031 F8P6 | U2 | TSSOP-20_L 6.5-W4.4-P0. 65-LS6.4-BL | STM32G031 F8P6 | ST(意法半导 体) | C529334 | LCSC
45 | 1 | DNP | U3 | SOT-23-3_L2 .9-W1.3-P1.9 0-LS2.4-BR | DNP | DNP | DNP | DNP
46 | 1 | RT9080-33G J5 | U4 | TSOT-23-5_ L2.9-W1.6-P 0.95-LS2.8-B L | RT9080-33G J5 | RICHTEK( 立 ) 锜 | C841192 | LCSC
47 | 1 | THVD2410D R | U5 | SOIC-8_L4.9 -W3.9-P1.27-LS6.0-TL | THVD2410D R | TI(德州仪器 ) | C1849398 | LCSC
48 | 1 | TC2030 | U6 | TAG-CONNE CT_TC2030-I DC-NL
49 | 1 | MAX3485CS A-JSM | U7 | SOP-8_L4.9-W3.9-P1.27-LS6.0-BL | MAX3485CS A-JSM | JSMSEMI( 杰 ) 盛微 | C6395158 | LCSC
50 | 4 | DNP | U8,U9,U10,U11 | SMD_RH-50 15 | DNP | 荣和 | | LCSC
51 | 1 | SN74AHCT1 G126DBVR | U14 | SOT-23-5_L3 .0-W1.7-P0.9 5-LS2.8-BR | SN74AHCT1 G126DBVR | TI(德州仪器 ) | C163712 | LCSC
52 | 1 | INA180A1ID BVR(LX) | U17 | SOT-23-5_L3 .0-W1.6-P0.9 5-LS2.8-BR | INA180A1ID BVR(LX) | LX(灵星芯微 ) | C48533472 | LCSC
53 | 1 | B4B-XH-A(L F)(SN) | U18 | CONN-TH_B 4B-XH-A-LF-SN | B4B-XH-A(L F)(SN) | JST | C144395 | LCSC
54 | 1 | CDSOT23-S M712-ES | U19 | SOT-23-3_L2 .9-W1.3-P1.9 0-LS2.4-BR | CDSOT23-S M712-ES | ElecSuper( 静 芯 ) | C5199207 | LCSC

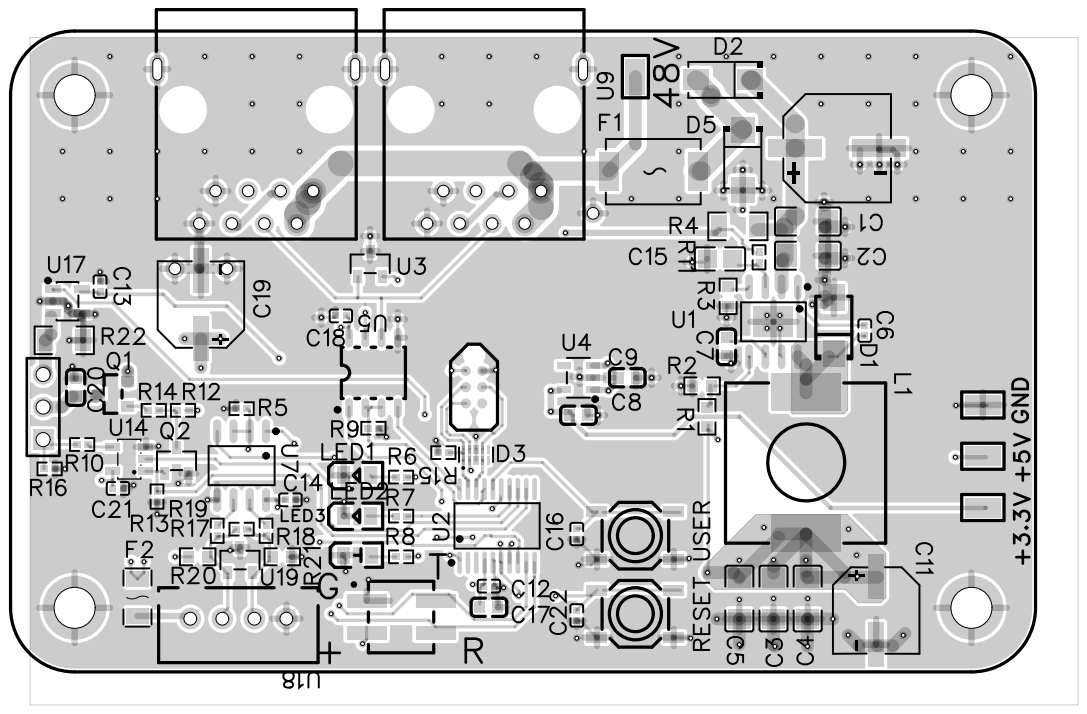
[picture p31: page 6]

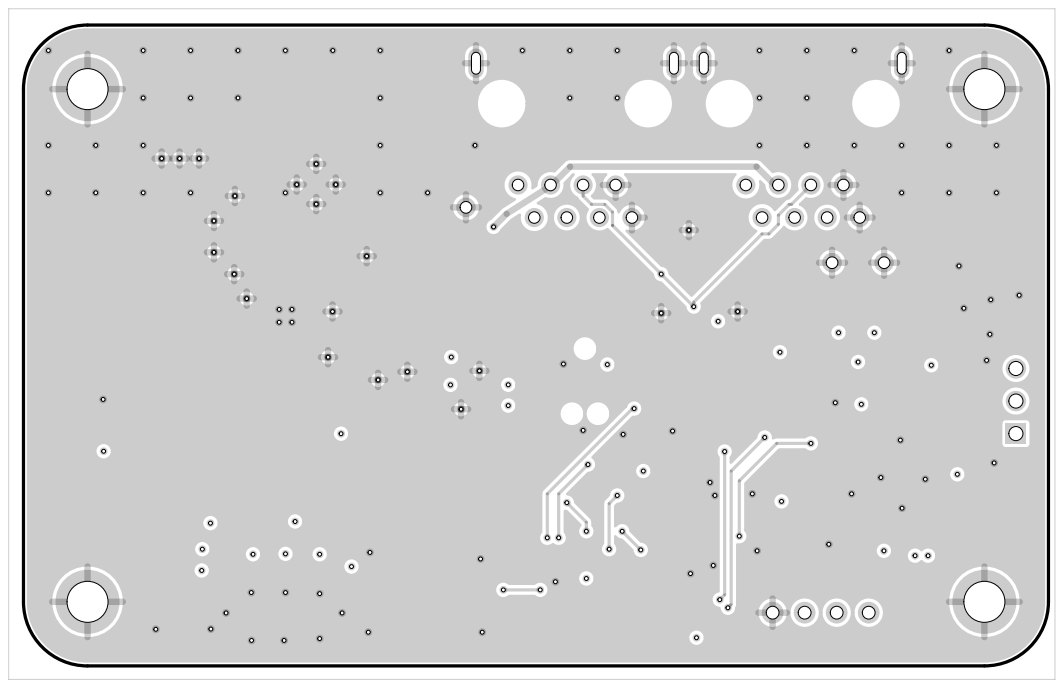
[picture p32: page 7]

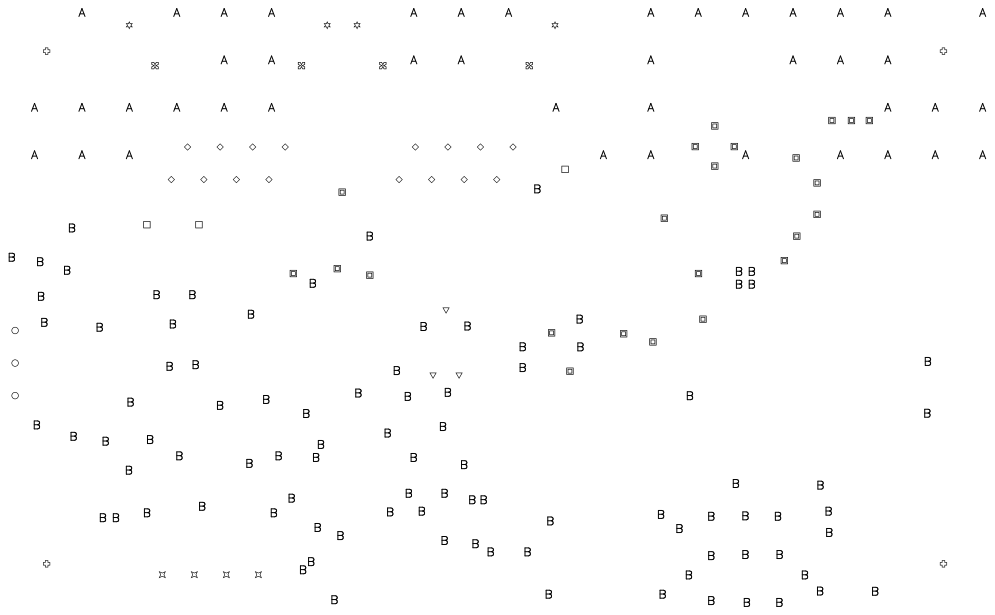
[picture p33: page 8]
