jeroenweij/ClimateControl/Software/Modules/ControllerNode/ControllerHandler.cpp

/*************************************************************
 * Created by J. Weij
 *************************************************************/

#include "Logger.h"

#include "EEndpoint.h"
#include "EFirmware.h"
#include "EOperation.h"
#include "RoomDemand.h"
#include "SettingsPage.h"

#include "ControllerHandler.h"

using NodeLib::Endpoint;
using NodeLib::FirmwareOp;
using NodeLib::Id;
using NodeLib::Message;
using NodeLib::Operation;
using NodeLib::SystemStatus;

namespace
{
    constexpr uint8_t NackReadOnly    = 0x01;
    constexpr uint8_t NackBadRequest  = 0x02;
    constexpr uint8_t NackUnsupported = 0x03;
    constexpr uint8_t NackWriteFailed = 0x04;
    constexpr uint8_t NackUnavailable = 0x05; // no reported value to give

    // This node's runtime settings record (NodeLib::SettingsPage): payload
    // byte 0 = DumpRoom flag.
    constexpr uint32_t SettingsMagic = 0x54534E43; // 'CNST'

    constexpr uint8_t ForceFlag = 1u << 0;

    void PackU16(uint8_t* const p, const uint16_t v)
    {
        p[0] = static_cast<uint8_t>(v);
        p[1] = static_cast<uint8_t>(v >> 8);
    }

    uint16_t ReadU16(const uint8_t* const p)
    {
        return static_cast<uint16_t>(p[0] | (p[1] << 8));
    }

    uint32_t ReadU32(const uint8_t* const p)
    {
        return static_cast<uint32_t>(p[0]) | (static_cast<uint32_t>(p[1]) << 8) |
            (static_cast<uint32_t>(p[2]) << 16) | (static_cast<uint32_t>(p[3]) << 24);
    }
} // namespace

ControllerHandler::ControllerHandler(NodeLib::Node& node, Damper& damper, ThermostatLink& link) :
    node(node),
    damper(damper),
    thermostatLink(link),
    supplyTemp(),
    roomControlLoop(link, supplyTemp, damper)
{
    // Target as well as actual, so a commanded move that hasn't landed yet
    // (still moving, or cut short by a stall) is visible upstream. The room
    // values relay the paired Thermostat's (ThermostatLink's cache) -- the
    // MainController's BudgetAllocator and the server both live on them.
    node.AddPublished(Endpoint::DamperTarget, 1);
    node.AddPublished(Endpoint::DamperActual, 1);
    node.AddPublished(Endpoint::DamperMode, 1);
    node.AddPublished(Endpoint::DamperBudget, 2); // max | min << 8
    node.AddPublished(Endpoint::DumpRoom, 1);
    node.AddPublished(Endpoint::RoomSetpoint, 2);
    node.AddPublished(Endpoint::RoomTemp, 2, NodeLib::TempMinChange);
    node.AddPublished(Endpoint::RoomHumidity, 2, NodeLib::HumidityMinChange);
    node.AddPublished(Endpoint::RoomMode, 1);
    node.AddPublished(Endpoint::RoomLink, 1);
    node.AddPublished(Endpoint::RoomTempOffset, 2);
}

void ControllerHandler::Init()
{
    uint8_t settings[1];
    if (NodeLib::SettingsPage::Load(SettingsMagic, settings, sizeof(settings)))
    {
        roomControlLoop.SetDumpRoom(settings[0] == 1);
        if (roomControlLoop.DumpRoom())
        {
            LOG_INFO("This room is the dump room");
        }
    }
}

void ControllerHandler::Loop()
{
    supplyTemp.Loop();
    roomControlLoop.Loop();
    thermostatLink.SetAirMode(roomControlLoop.Air());
    damper.Loop();
    Publish();

    bool     nack;
    uint16_t offset;
    uint16_t chunkCrc16;
    bool     programFailed;
    if (thermostatLink.ConsumeWriteReply(nack, offset, chunkCrc16, programFailed))
    {
        AckOrNackThermostatWrite(nack, offset, chunkCrc16, programFailed);
    }
    if (thermostatLink.ConsumeStatusChange())
    {
        ReportThermostatFirmwareStatus();
    }
}

void ControllerHandler::ReceivedMessage(const Message& m)
{
    switch (static_cast<uint8_t>(m.id.endpoint) & 0xF0)
    {
        case static_cast<uint8_t>(Endpoint::DamperTarget) & 0xF0:
            HandleDamper(m);
            break;
        case static_cast<uint8_t>(Endpoint::RoomSetpoint) & 0xF0:
            HandleRoom(m);
            break;
        default:
            if (m.id.endpoint == Endpoint::ThermostatFirmware)
            {
                HandleThermostatFirmware(m);
            }
            break;
    }
}

void ControllerHandler::HandleDamper(const Message& m)
{
    switch (m.id.endpoint)
    {
        case Endpoint::DamperTarget:
            if (m.id.operation == Operation::Get)
            {
                const uint8_t v = damper.Target();
                Report(Endpoint::DamperTarget, &v, 1);
            }
            else if (m.id.operation == Operation::Set && m.len >= 1)
            {
                // A commanded position is a manual override in any mode --
                // switch to Manual so the room loop (Auto) or a fixed mode
                // (Closed/Open) doesn't immediately move it somewhere else.
                damper.SetMode(Damper::Mode::Manual);
                damper.SetTarget(m.data[0]);
            }
            else
            {
                Nack(m, NackBadRequest);
            }
            break;

        case Endpoint::DamperActual:
            if (m.id.operation == Operation::Get)
            {
                const uint8_t v = damper.Actual();
                Report(Endpoint::DamperActual, &v, 1);
            }
            else
            {
                Nack(m, NackReadOnly);
            }
            break;

        case Endpoint::DamperMode:
            if (m.id.operation == Operation::Get)
            {
                const uint8_t v = damper.ReportedMode();
                Report(Endpoint::DamperMode, &v, 1);
            }
            else if (m.id.operation == Operation::Set && m.len >= 1 && m.data[0] <= 3)
            {
                damper.SetMode(static_cast<Damper::Mode>(m.data[0]));
            }
            else
            {
                Nack(m, NackBadRequest);
            }
            break;

        case Endpoint::DamperBudget:
            if (m.id.operation == Operation::Get)
            {
                const uint8_t v[2] = {roomControlLoop.BudgetMax(), roomControlLoop.BudgetMin()};
                Report(Endpoint::DamperBudget, v, 2);
            }
            else if (m.id.operation == Operation::Set && m.len >= 1)
            {
                // max(1) [min(1)] -- a 1-byte Set is a plain ceiling, min 0.
                roomControlLoop.SetBudget(m.data[0], m.len >= 2 ? m.data[1] : 0);
            }
            else
            {
                Nack(m, NackBadRequest);
            }
            break;

        case Endpoint::DumpRoom:
            if (m.id.operation == Operation::Get)
            {
                const uint8_t v = roomControlLoop.DumpRoom() ? 1 : 0;
                Report(Endpoint::DumpRoom, &v, 1);
            }
            else if (m.id.operation == Operation::Set && m.len >= 1 && m.data[0] <= 1)
            {
                SetDumpRoom(m.data[0] == 1, m);
            }
            else
            {
                Nack(m, NackBadRequest);
            }
            break;

        default:
            break;
    }
}

void ControllerHandler::HandleRoom(const Message& m)
{
    const ThermostatLink::RoomState& room = thermostatLink.Room();

    if (m.id.operation == Operation::Set)
    {
        if (m.id.endpoint == Endpoint::RoomSetpoint && m.len >= 2)
        {
            thermostatLink.PushSetpoint(static_cast<int16_t>(ReadU16(m.data)));
            return;
        }
        if (m.id.endpoint == Endpoint::RoomTempOffset && m.len >= 2)
        {
            // Range-checked here too: the Thermostat's own Nack doesn't come
            // back up the link, so a bad value is refused while it can be.
            const int16_t offset = static_cast<int16_t>(ReadU16(m.data));
            if (offset > NodeLib::RoomTempOffsetLimit || offset < -NodeLib::RoomTempOffsetLimit)
            {
                Nack(m, NackBadRequest);
                return;
            }
            thermostatLink.PushTempOffset(offset); // confirmed by the Thermostat's Report, relayed by Publish()
            return;
        }
        Nack(m, NackReadOnly);
        return;
    }
    if (m.id.operation != Operation::Get)
    {
        Nack(m, NackReadOnly);
        return;
    }

    const bool isReading  = m.id.endpoint == Endpoint::RoomTemp || m.id.endpoint == Endpoint::RoomHumidity;
    const bool isOffset   = m.id.endpoint == Endpoint::RoomTempOffset;
    const bool isSetpoint = !isReading && !isOffset && m.id.endpoint != Endpoint::RoomLink;
    if ((isReading && !room.tempValid) || (isOffset && !room.tempOffsetValid) || (isSetpoint && !room.setpointValid))
    {
        Nack(m, NackUnavailable); // nothing real to report
        return;
    }

    uint8_t payload[2];
    switch (m.id.endpoint)
    {
        case Endpoint::RoomSetpoint:
            PackU16(payload, static_cast<uint16_t>(room.setpoint));
            Report(Endpoint::RoomSetpoint, payload, 2);
            break;
        case Endpoint::RoomTemp:
            PackU16(payload, static_cast<uint16_t>(room.temp));
            Report(Endpoint::RoomTemp, payload, 2);
            break;
        case Endpoint::RoomHumidity:
            PackU16(payload, room.humidity);
            Report(Endpoint::RoomHumidity, payload, 2);
            break;
        case Endpoint::RoomMode:
            payload[0] = room.mode;
            Report(Endpoint::RoomMode, payload, 1);
            break;
        case Endpoint::RoomLink:
            payload[0] = thermostatLink.LinkUp() ? 1 : 0;
            Report(Endpoint::RoomLink, payload, 1);
            break;
        case Endpoint::RoomTempOffset:
            PackU16(payload, static_cast<uint16_t>(room.tempOffset));
            Report(Endpoint::RoomTempOffset, payload, 2);
            break;
        default:
            break;
    }
}

void ControllerHandler::HandleThermostatFirmware(const Message& m)
{
    if (m.id.operation == Operation::Get)
    {
        ReportThermostatFirmwareStatus();
        return;
    }
    if (m.id.operation != Operation::Set || m.len < 1)
    {
        Nack(m, NackBadRequest);
        return;
    }

    switch (static_cast<FirmwareOp>(m.data[0]))
    {
        case FirmwareOp::Begin:
            // op module(1) imageSize(4) imageCrc32(4) fwVersion(2) flags(1)
            if (m.len >= 13)
            {
                const bool force = (m.data[12] & ForceFlag) != 0;
                thermostatLink.OtaBegin(m.data[1], ReadU32(&m.data[2]), ReadU32(&m.data[6]), ReadU16(&m.data[10]), force);
            }
            break;
        case FirmwareOp::Write:
            // op byteOffset(2) bytes(<=32) -- Node-Flash-Layout-and-Bootloader-Spec.md §6.2.1
            if (m.len >= 3)
            {
                thermostatLink.OtaWrite(ReadU16(&m.data[1]), &m.data[3], static_cast<uint8_t>(m.len - 3));
            }
            // The reply isn't known yet -- it arrives asynchronously from the
            // link (ConsumeWriteReply(), relayed from Loop()), unlike
            // Begin/End/Activate/Abort which still answer synchronously below.
            return;
        case FirmwareOp::End:
            thermostatLink.OtaEnd();
            break;
        case FirmwareOp::Activate:
            thermostatLink.OtaActivate();
            break;
        case FirmwareOp::Abort:
            thermostatLink.OtaAbort();
            break;
        default:
            Nack(m, NackUnsupported);
            return;
    }
    ReportThermostatFirmwareStatus();
}

void ControllerHandler::ReportThermostatFirmwareStatus()
{
    uint8_t status[9];
    thermostatLink.FillOtaStatus(status);
    Report(Endpoint::ThermostatFirmware, status, sizeof(status));
}

void ControllerHandler::Publish()
{
    node.PublishIfChanged(Endpoint::DamperTarget, damper.Target());
    node.PublishIfChanged(Endpoint::DamperActual, damper.Actual());
    node.PublishIfChanged(Endpoint::DamperMode, damper.ReportedMode());
    node.PublishIfChanged(Endpoint::DamperBudget, roomControlLoop.BudgetMax() | (roomControlLoop.BudgetMin() << 8));
    node.PublishIfChanged(Endpoint::DumpRoom, roomControlLoop.DumpRoom() ? 1 : 0);
    node.PublishIfChanged(Endpoint::RoomLink, thermostatLink.LinkUp() ? 1 : 0);

    // Only what the Thermostat actually reported, and a temperature only while
    // it keeps being refreshed -- never a placeholder or a frozen value.
    const ThermostatLink::RoomState& room = thermostatLink.Room();
    if (room.setpointValid)
    {
        node.PublishIfChanged(Endpoint::RoomSetpoint, room.setpoint);
        node.PublishIfChanged(Endpoint::RoomMode, room.mode);
    }
    else
    {
        node.ClearPublished(Endpoint::RoomSetpoint);
        node.ClearPublished(Endpoint::RoomMode);
    }
    if (room.tempOffsetValid)
    {
        node.PublishIfChanged(Endpoint::RoomTempOffset, room.tempOffset);
    }
    else
    {
        node.ClearPublished(Endpoint::RoomTempOffset);
    }
    if (room.tempValid)
    {
        node.PublishIfChanged(Endpoint::RoomTemp, room.temp);
        node.PublishIfChanged(Endpoint::RoomHumidity, room.humidity);
    }
    else
    {
        node.ClearPublished(Endpoint::RoomTemp);
        node.ClearPublished(Endpoint::RoomHumidity);
    }
}

void ControllerHandler::SetDumpRoom(const bool dumpRoom, const Message& m)
{
    if (dumpRoom != roomControlLoop.DumpRoom())
    {
        const uint8_t settings[1] = {static_cast<uint8_t>(dumpRoom ? 1 : 0)};
        if (!NodeLib::SettingsPage::Save(SettingsMagic, settings, sizeof(settings)))
        {
            LOG_ERROR("DumpRoom write failed");
            Nack(m, NackWriteFailed);
            return;
        }
        roomControlLoop.SetDumpRoom(dumpRoom);
        LOG_INFO("DumpRoom = " << (dumpRoom ? 1 : 0));
    }
    const uint8_t v = dumpRoom ? 1 : 0;
    Report(Endpoint::DumpRoom, &v, 1);
}

void ControllerHandler::ConnectionLost()
{
    LOG_WARN("Main bus connection lost");
    roomControlLoop.ConnectionLost(); // re-sending our values on return is Node's job
}

void ControllerHandler::Snoop(const Message& m)
{
    supplyTemp.Snoop(m);
}

void ControllerHandler::PrepareForReset()
{
    damper.ParkNeutral();
}

void ControllerHandler::FillStatus(SystemStatus& status)
{
    if (!thermostatLink.LinkUp())
    {
        status.errorFlags |= ThermostatLinkDown;
    }
    if (damper.Stalled())
    {
        status.errorFlags |= DamperStalled;
    }
}

void ControllerHandler::Report(const Endpoint endpoint, const uint8_t* const data, const uint8_t len)
{
    node.QueueMessage(Id(node.GetId(), endpoint, Operation::Report), data, len);
}

void ControllerHandler::Nack(const Message& m, const uint8_t reason)
{
    node.QueueMessage(Id(node.GetId(), m.id.endpoint, Operation::Nack), reason);
}

void ControllerHandler::AckOrNackThermostatWrite(
    const bool     nack,
    const uint16_t offset,
    const uint16_t chunkCrc16,
    const bool     programFailed)
{
    uint8_t payload[5];
    PackU16(&payload[0], offset);
    PackU16(&payload[2], chunkCrc16);
    payload[4] = programFailed ? 1 : 0;
    node.QueueMessage(
        Id(node.GetId(), Endpoint::ThermostatFirmware, nack ? Operation::Nack : Operation::Ack), payload, sizeof(payload));
}
