jeroenweij/ClimateControl/Software/Modules/ControllerNode/ControllerHandler.h

/*************************************************************
 * Created by J. Weij
 *************************************************************/

#pragma once

#include "INodeHandler.h"
#include "Node.h"

#include "Damper.h"
#include "RoomControlLoop.h"
#include "SupplyTemp.h"
#include "ThermostatLink.h"

// ControllerNode main-bus application logic (INodeHandler for the RS485 bus
// Node). Serves:
//   Damper*  (0x30..0x33)  -- this node's own damper, incl. the DamperBudget
//                             range RoomControlLoop keeps it in
//   DumpRoom (0x34)        -- persisted flag: this room takes the surplus air
//   Room*    (0x40..0x44)  -- the paired Thermostat's state, from the link cache
//   ThermostatFirmware (0x22) -- relays an image to the Thermostat over the link
//
// System* / Firmware / Diagnostics* / Transport stay inside NodeLib.
class ControllerHandler : public NodeLib::INodeHandler
{
  public:
    ControllerHandler(NodeLib::Node& node, Damper& damper, ThermostatLink& link);

    // Loads the persisted settings (DumpRoom) -- once, before the bus starts.
    void Init();
    void Loop();

    void ReceivedMessage(const NodeLib::Message& message) override;
    void ConnectionLost() override;
    void PrepareForReset() override;
    void FillStatus(NodeLib::SystemStatus& status) override;
    void Snoop(const NodeLib::Message& message) override;

  private:
    enum ErrorBit : uint16_t
    {
        ThermostatLinkDown = 1u << 0,
        DamperStalled      = 1u << 1,
    };

    void HandleDamper(const NodeLib::Message& m);
    // Persists a changed DumpRoom flag and answers with a Report of it (a
    // Nack if the flash write fails).
    void SetDumpRoom(const bool dumpRoom, const NodeLib::Message& m);
    void HandleRoom(const NodeLib::Message& m);
    void HandleThermostatFirmware(const NodeLib::Message& m);
    void ReportThermostatFirmwareStatus();
    // Relays a Write's Ack/Nack (Node-Flash-Layout-and-Bootloader-Spec.md
    // §6.2.1) once ThermostatLink has one waiting -- see Loop().
    void AckOrNackThermostatWrite(const bool nack, const uint16_t offset, const uint16_t chunkCrc16, const bool programFailed);

    // Hands every value this node reports by itself to Node's change-driven
    // publisher (Node-Message-Model-Spec.md §6.1) -- declared in the
    // constructor, fed each Loop().
    void Publish();

    void Report(const NodeLib::Endpoint endpoint, const uint8_t* const data, const uint8_t len);
    void Nack(const NodeLib::Message& m, const uint8_t reason);

    NodeLib::Node&      node;
    Damper&             damper;
    ThermostatLink&     thermostatLink;
    NodeLib::SupplyTemp supplyTemp;
    RoomControlLoop     roomControlLoop;
};
