jeroenweij/ClimateControl/Software/Modules/TemperatureNode/DuctChannel.h

/*************************************************************
 * Created by J. Weij
 *************************************************************/

#pragma once

#include "DelayTimer.h"
#include "Pin.h"

#include "EEndpoint.h"
#include "Node.h"

#include "Ds18b20.h"

// One duct temperature probe (a DS18B20 on its own single-drop 1-Wire line --
// TemperatureNode-Spec.md §4.1) mapped onto one bus endpoint.
//
// Samples on an interval and hands each reading to Node's change-driven
// publisher (Node-Message-Model-Spec.md §6.1): reported when it moves by
// 0.1 degC, as a keepalive during a long stretch of unchanging duct air
// (TemperatureNode-Spec.md §5 item 3), and not at all while the probe is
// missing. Solicited Get is answered immediately via Report(). Every reading is
// the raw probe value plus a per-probe calibration offset (SetOffset(),
// TemperatureNode-Spec.md §4.3).
//
// The DS18B20 conversion (~750 ms) is not blocked on: the channel kicks it off,
// returns to the caller, and reads the result on a later Loop(). The 1-Wire
// transactions themselves do block -- ~2 ms to start a conversion, ~7 ms to read
// the scratchpad back -- so a Loop() that touches the probe stalls the bus
// service for that long, roughly twice per SampleIntervalMs.
class DuctChannel
{
  public:
    DuctChannel(NodeLib::Node& node, const NodeLib::Endpoint endpoint, const Hal::Pin oneWirePin);

    void Init();
    void Loop();

    // Emit a Report with the current value (reply to a Get).
    void Report();

    // Correction added to every raw reading, centi-degC. Takes effect at once:
    // a present probe re-publishes its corrected value straight away.
    void SetOffset(const int16_t centiDegC);

    bool    Present() const;
    int16_t Value() const;

  private:
    enum class State
    {
        Idle, // waiting out sampleTimer before the next conversion
        Converting, // CONVERT T issued, waiting out conversionTimer
    };

    void SetPresent(const bool present);
    void Publish();

    NodeLib::Node&    node;
    NodeLib::Endpoint endpoint;
    Ds18b20           sensor;

    State   state;
    int16_t raw;
    int16_t offset;
    int16_t value;
    bool    present;

    Tools::DelayTimer sampleTimer;
    Tools::DelayTimer conversionTimer;
};
