jeroenweij/ClimateControl/Software/Modules/Bootloader/main.cpp

/*************************************************************
 * Created by J. Weij
 *
 * Bus-resident bootloader -- base skeleton.
 * ONE binary for all four boards (Spec/Node-Flash-Layout-and-Bootloader-Spec.md
 * §7). The master and the nodes are updated by different mechanisms, but that
 * does not split the bootloader -- it branches on ConfigStore::Valid().
 *
 * Boot decision (§5):
 *   - Board::EnterBootloaderMagic in backup reg  -> stay resident (app asked)
 *   - no valid application image                 -> stay resident
 *   - too many boots without the app ever proving itself healthy
 *     (Tools::BootHealth) -> stay resident
 *   - otherwise                                  -> jump to the app
 *
 * Stay-resident behaviour:
 *   - provisioned node (ConfigStore::Valid())    -> RS485 OTA slave loop (§6)
 *   - MainController (no ConfigRecord) or an     -> passive wait on the error
 *     unprovisioned node                            LED; recovery is SWD / bench
 *
 *************************************************************/

#include "Backup.h"
#include "BoardPins.h"
#include "BootHealth.h"
#include "ConfigStore.h"
#include "Gpio.h"
#include "MemoryMap.h"
#include "System.h"
#include "Tick.h"

#include "AppImage.h"
#include "FirmwareSlave.h"

namespace Backup = Hal::Backup;
using NodeLib::ConfigStore;

namespace
{
    bool EnterBootloaderRequested()
    {
        if (Backup::Read(Backup::Reg::Boot) != Board::EnterBootloaderMagic)
        {
            return false;
        }
        Backup::Write(Backup::Reg::Boot, 0); // consume it
        return true;
    }

    [[noreturn]] void BlinkForever(const uint32_t onMs, const uint32_t offMs)
    {
        Hal::Gpio errorLed(Board::ErrorLed, Hal::Gpio::Mode::Output);
        while (true)
        {
            errorLed.Write(true);
            Hal::Tick::DelayMs(onMs);
            errorLed.Write(false);
            Hal::Tick::DelayMs(offMs);
        }
    }

    [[noreturn]] void StayResident()
    {
        if (ConfigStore::Valid())
        {
            // Provisioned node: serve a firmware image over RS485 at
            // ConfigStore::NodeId() (Node-Flash spec §6).
            Boot::FirmwareSlave slave(ConfigStore::NodeId(), static_cast<uint8_t>(ConfigStore::GetModule()));
            slave.Init();
            while (true)
            {
                slave.Loop();
            }
        }

        // MainController (no ConfigRecord) or an unprovisioned node: no bus
        // address -> no over-the-bus update. The MainController updates itself
        // app-assisted over NINA (§7.1); a bare node needs the bench. Either way
        // the recovery path here is SWD.
        BlinkForever(500, 500);
    }
} // namespace

int main()
{
    Hal::System::Init();

    const bool forced = EnterBootloaderRequested();

    // Short-circuits deliberately: TooManyFailedBoots() records an attempt as
    // a side effect, and a forced entry (a normal OTA request) or an already-
    // invalid image are not boot failures -- only count an attempt when we're
    // actually about to trust a CRC-valid image and jump to it.
    if (!forced && Boot::AppImage::IsValid() && !Tools::BootHealth::TooManyFailedBoots())
    {
        Hal::System::JumpToApplication(Board::Flash::AppBase); // never returns
    }

    StayResident();
}
