jeroenweij/ClimateControl/Software/Modules/ControllerNode/test/RoomControlLoopTests.cpp

/*************************************************************
 * Created by J. Weij
 *************************************************************/

#include "EEndpoint.h"
#include "EOperation.h"

#include "FakeAdc.h"
#include "FakeClock.h"
#include "Test.h"

#include "Damper.h"
#include "RoomControlLoop.h"
#include "SupplyTemp.h"
#include "ThermostatLink.h"

using NodeLib::Endpoint;
using NodeLib::Id;
using NodeLib::LinkMaster;
using NodeLib::Message;
using NodeLib::Operation;
using NodeLib::SupplyTemp;

namespace
{
    void ResetWorld()
    {
        FakeClock::Reset();
        FakeAdc::Reset(); // 0 counts -- Damper never reads as stalled unless a test says otherwise
    }

    void PackI16(uint8_t* const out, const int16_t v)
    {
        out[0] = static_cast<uint8_t>(v);
        out[1] = static_cast<uint8_t>(static_cast<uint16_t>(v) >> 8);
    }

    // Seeds ThermostatLink's Room* cache directly -- ReceivedMessage() is a
    // pure cache update (ThermostatLink.cpp), no link/Uart traffic involved,
    // so this doesn't need a live LinkMaster poll cycle.
    void SeedRoom(ThermostatLink& link, const int16_t tempCentiC, const int16_t setpointCentiC)
    {
        Message temp(Id(0, Endpoint::RoomTemp, Operation::Report));
        PackI16(temp.data, tempCentiC);
        temp.len = 2;
        link.ReceivedMessage(temp);

        Message setpoint(Id(0, Endpoint::RoomSetpoint, Operation::Report));
        PackI16(setpoint.data, setpointCentiC);
        setpoint.len = 2;
        link.ReceivedMessage(setpoint);
    }

    void SeedSupply(SupplyTemp& supply, const int16_t centiC)
    {
        Message m(Id(9, Endpoint::SupplyTemp, Operation::Report)); // source node id irrelevant, unaddressed
        PackI16(m.data, centiC);
        m.len = 2;
        supply.Snoop(m);
    }
} // namespace

CC_TEST(RoomControlLoop, DefaultsToTheFiftyPercentBudget)
{
    ResetWorld();
    LinkMaster      link;
    Damper          damper;
    ThermostatLink  thermostatLink(link, damper);
    SupplyTemp      supplyTemp;
    RoomControlLoop loop(thermostatLink, supplyTemp, damper);

    CC_CHECK_EQ(loop.BudgetMax(), 50);
}

CC_TEST(RoomControlLoop, GoesToTheNeutralPositionWithoutRoomData)
{
    ResetWorld();
    LinkMaster      link;
    Damper          damper;
    ThermostatLink  thermostatLink(link, damper);
    SupplyTemp      supplyTemp;
    RoomControlLoop loop(thermostatLink, supplyTemp, damper);

    SeedSupply(supplyTemp, 1500); // a supply reading, but no Thermostat
    damper.SetTarget(0); // e.g. squeezed shut by an earlier budget
    loop.Loop();
    CC_CHECK_EQ(damper.Target(), 50); // back to neutral, not left wherever it was
}

CC_TEST(RoomControlLoop, NeutralWithoutRoomDataStillRespectsTheBudget)
{
    ResetWorld();
    LinkMaster      link;
    Damper          damper;
    ThermostatLink  thermostatLink(link, damper);
    SupplyTemp      supplyTemp;
    RoomControlLoop loop(thermostatLink, supplyTemp, damper);

    SeedSupply(supplyTemp, 1500);
    loop.SetBudget(30, 0);
    loop.Loop();
    CC_CHECK_EQ(damper.Target(), 30); // neutral, capped by the max
}

CC_TEST(RoomControlLoop, GoesToTheNeutralPositionWithoutASupplyReading)
{
    ResetWorld();
    LinkMaster      link;
    Damper          damper;
    ThermostatLink  thermostatLink(link, damper);
    SupplyTemp      supplyTemp;
    RoomControlLoop loop(thermostatLink, supplyTemp, damper);

    SeedRoom(thermostatLink, 2400, 1800); // wants cooling -- but no supply to judge it by
    damper.SetTarget(10);
    loop.Loop();

    CC_CHECK_EQ(damper.Target(), Damper::NeutralPercent);
}

CC_TEST(RoomControlLoop, TheNoSupplyPositionFollowsTheBudgetButNeverExceedsIt)
{
    ResetWorld();
    LinkMaster      link;
    Damper          damper;
    ThermostatLink  thermostatLink(link, damper);
    SupplyTemp      supplyTemp;
    RoomControlLoop loop(thermostatLink, supplyTemp, damper);

    // No room data either -- the fail-safe doesn't depend on the thermostat.
    loop.SetBudget(20);
    loop.Loop();
    CC_CHECK_EQ(damper.Target(), 20); // capped by the budget

    loop.SetBudget(21); // MainController walking the budget back up
    loop.Loop();
    CC_CHECK_EQ(damper.Target(), 21); // the damper follows

    loop.SetBudget(80);
    loop.Loop();
    CC_CHECK_EQ(damper.Target(), Damper::NeutralPercent); // and stops at neutral
}

CC_TEST(RoomControlLoop, FallsBackToNeutralOnceTheSupplyReadingGoesStale)
{
    ResetWorld();
    LinkMaster      link;
    Damper          damper;
    ThermostatLink  thermostatLink(link, damper);
    SupplyTemp      supplyTemp;
    RoomControlLoop loop(thermostatLink, supplyTemp, damper);

    SeedRoom(thermostatLink, 1850, 1800); // small demand
    SeedSupply(supplyTemp, 1500);
    loop.Loop();
    CC_CHECK(damper.Target() < Damper::NeutralPercent);

    FakeClock::Advance(5 * 60 * 1000); // SupplyTemp's staleTimeoutMs, nothing heard
    supplyTemp.Loop();
    CC_CHECK(!supplyTemp.Valid());
    loop.Loop();
    CC_CHECK_EQ(damper.Target(), Damper::NeutralPercent);
}

CC_TEST(RoomControlLoop, DemandBelowBudgetDoesNotPinTheDamperAtTheCeiling)
{
    ResetWorld();
    LinkMaster      link;
    Damper          damper;
    ThermostatLink  thermostatLink(link, damper);
    SupplyTemp      supplyTemp;
    RoomControlLoop loop(thermostatLink, supplyTemp, damper);

    SeedRoom(thermostatLink, 1850, 1800); // 0.5C above setpoint -- small demand
    SeedSupply(supplyTemp, 1500); // colder than the room -- helps cooling
    loop.Loop();

    CC_CHECK(damper.Target() > 0);
    CC_CHECK(damper.Target() < loop.BudgetMax()); // "any value between 0 and budget", not always at budget
}

CC_TEST(RoomControlLoop, FullDemandIsClampedToTheBudgetCeiling)
{
    ResetWorld();
    LinkMaster      link;
    Damper          damper;
    ThermostatLink  thermostatLink(link, damper);
    SupplyTemp      supplyTemp;
    RoomControlLoop loop(thermostatLink, supplyTemp, damper);

    SeedRoom(thermostatLink, 2400, 1800); // 6.0C above setpoint -- saturates demand at 100%
    SeedSupply(supplyTemp, 1500);
    loop.SetBudget(30);
    loop.Loop();

    CC_CHECK_EQ(damper.Target(), 30);
}

CC_TEST(RoomControlLoop, SetBudgetReclampsAnAlreadyOpenDamperImmediately)
{
    ResetWorld();
    LinkMaster      link;
    Damper          damper;
    ThermostatLink  thermostatLink(link, damper);
    SupplyTemp      supplyTemp;
    RoomControlLoop loop(thermostatLink, supplyTemp, damper);

    SeedRoom(thermostatLink, 2400, 1800);
    SeedSupply(supplyTemp, 1500);
    loop.Loop();
    CC_CHECK_EQ(damper.Target(), 50); // default budget, full demand

    loop.SetBudget(20);
    CC_CHECK_EQ(damper.Target(), 20); // reclamped without a further Loop() call
}

CC_TEST(RoomControlLoop, BudgetNeverReclampsAManualOverride)
{
    ResetWorld();
    LinkMaster      link;
    Damper          damper;
    ThermostatLink  thermostatLink(link, damper);
    SupplyTemp      supplyTemp;
    RoomControlLoop loop(thermostatLink, supplyTemp, damper);

    damper.SetTarget(77);
    damper.SetMode(Damper::Mode::Manual);

    loop.SetBudget(10);
    CC_CHECK_EQ(damper.Target(), 77); // Manual is an explicit override, budget doesn't touch it

    SeedRoom(thermostatLink, 2400, 1800);
    SeedSupply(supplyTemp, 1500);
    loop.Loop();
    CC_CHECK_EQ(damper.Target(), 77); // still untouched -- Loop() only drives Auto
}

CC_TEST(RoomControlLoop, DisconnectRampReturnsTowardDefaultOnePointPerInterval)
{
    ResetWorld();
    LinkMaster      link;
    Damper          damper;
    ThermostatLink  thermostatLink(link, damper);
    SupplyTemp      supplyTemp;
    RoomControlLoop loop(thermostatLink, supplyTemp, damper);

    loop.SetBudget(90);
    loop.ConnectionLost();

    FakeClock::Advance(36000);
    loop.Loop();
    CC_CHECK_EQ(loop.BudgetMax(), 89);

    FakeClock::Advance(36000);
    loop.Loop();
    CC_CHECK_EQ(loop.BudgetMax(), 88);
}

CC_TEST(RoomControlLoop, RampNeverOvershootsPastTheDefault)
{
    ResetWorld();
    LinkMaster      link;
    Damper          damper;
    ThermostatLink  thermostatLink(link, damper);
    SupplyTemp      supplyTemp;
    RoomControlLoop loop(thermostatLink, supplyTemp, damper);

    loop.SetBudget(51);
    loop.ConnectionLost();

    FakeClock::Advance(36000);
    loop.Loop();
    CC_CHECK_EQ(loop.BudgetMax(), 50);

    FakeClock::Advance(360000); // plenty more time
    loop.Loop();
    CC_CHECK_EQ(loop.BudgetMax(), 50); // stays put, doesn't ramp past the default
}

CC_TEST(RoomControlLoop, AFreshSetBudgetCancelsTheRamp)
{
    ResetWorld();
    LinkMaster      link;
    Damper          damper;
    ThermostatLink  thermostatLink(link, damper);
    SupplyTemp      supplyTemp;
    RoomControlLoop loop(thermostatLink, supplyTemp, damper);

    loop.SetBudget(90);
    loop.ConnectionLost();
    FakeClock::Advance(36000);
    loop.Loop();
    CC_CHECK_EQ(loop.BudgetMax(), 89);

    loop.SetBudget(70); // a live MainController is proven by this arriving at all
    FakeClock::Advance(360000);
    loop.Loop();
    CC_CHECK_EQ(loop.BudgetMax(), 70); // unchanged -- the ramp was cancelled, not just paused
}

CC_TEST(RoomControlLoop, RampRunsEvenWithoutRoomData)
{
    ResetWorld();
    LinkMaster      link;
    Damper          damper;
    ThermostatLink  thermostatLink(link, damper);
    SupplyTemp      supplyTemp;
    RoomControlLoop loop(thermostatLink, supplyTemp, damper);

    loop.SetBudget(10);
    loop.ConnectionLost();

    FakeClock::Advance(36000);
    loop.Loop(); // room never seeded -- the ramp must not depend on it
    CC_CHECK_EQ(loop.BudgetMax(), 11);
}

namespace
{
    // One main-loop pass as ControllerHandler::Loop() runs it.
    void RunFor(RoomControlLoop& loop, Damper& damper, const uint32_t ms)
    {
        for (uint32_t t = 0; t < ms; t += 10)
        {
            FakeClock::Advance(10);
            loop.Loop();
            damper.Loop();
        }
    }
} // namespace

CC_TEST(RoomControlLoop, AnUnchangedTargetLetsTheMoveSettle)
{
    ResetWorld();
    LinkMaster      link;
    Damper          damper;
    ThermostatLink  thermostatLink(link, damper);
    SupplyTemp      supplyTemp;
    RoomControlLoop loop(thermostatLink, supplyTemp, damper);

    SeedRoom(thermostatLink, 1850, 1800); // small demand -- a target below the 50% start
    SeedSupply(supplyTemp, 1500);
    RunFor(loop, damper, 2500); // past a half-stroke slew plus settle (2.3 s)

    // Re-asserting the same target every pass must not restart the move --
    // the servo settles, reports it, and powers down.
    CC_CHECK(damper.Target() < 50);
    CC_CHECK_EQ(damper.Actual(), damper.Target());
}

CC_TEST(RoomControlLoop, AnUnchangedTargetLeavesStallDetectionWorking)
{
    ResetWorld();
    LinkMaster      link;
    Damper          damper;
    ThermostatLink  thermostatLink(link, damper);
    SupplyTemp      supplyTemp;
    RoomControlLoop loop(thermostatLink, supplyTemp, damper);

    SeedRoom(thermostatLink, 1850, 1800);
    SeedSupply(supplyTemp, 1500);
    loop.Loop(); // starts the move
    FakeAdc::SetValue(1000); // jammed: well over Damper::stallThresholdCounts
    RunFor(loop, damper, 400); // past Damper::stallConfirmMs (200 ms)

    CC_CHECK(damper.Stalled());
}

CC_TEST(RoomControlLoop, TheBudgetMinHoldsASatisfiedRoomOpen)
{
    ResetWorld();
    LinkMaster      link;
    Damper          damper;
    ThermostatLink  thermostatLink(link, damper);
    SupplyTemp      supplyTemp;
    RoomControlLoop loop(thermostatLink, supplyTemp, damper);

    SeedRoom(thermostatLink, 2000, 2000); // at setpoint -- no demand, would close
    SeedSupply(supplyTemp, 1500);
    loop.SetBudget(60, 40);
    loop.Loop();

    CC_CHECK_EQ(damper.Target(), 40);
}

CC_TEST(RoomControlLoop, AMinAboveTheMaxWins)
{
    ResetWorld();
    LinkMaster      link;
    Damper          damper;
    ThermostatLink  thermostatLink(link, damper);
    SupplyTemp      supplyTemp;
    RoomControlLoop loop(thermostatLink, supplyTemp, damper);

    loop.SetBudget(20, 70); // dump room: fair share 20, but the total needs 70 here
    CC_CHECK_EQ(loop.BudgetMin(), 70);
    CC_CHECK_EQ(loop.BudgetMax(), 70);
    CC_CHECK_EQ(damper.Target(), 70); // moved into range at once
}

CC_TEST(RoomControlLoop, TheDumpRoomOpensFullyWhenTheBusIsLost)
{
    ResetWorld();
    LinkMaster      link;
    Damper          damper;
    ThermostatLink  thermostatLink(link, damper);
    SupplyTemp      supplyTemp;
    RoomControlLoop loop(thermostatLink, supplyTemp, damper);

    SeedRoom(thermostatLink, 2000, 2000);
    SeedSupply(supplyTemp, 1500);
    loop.SetDumpRoom(true);
    loop.SetBudget(30, 0);
    loop.Loop();
    CC_CHECK_EQ(damper.Target(), 0);

    loop.ConnectionLost();
    loop.Loop();
    CC_CHECK_EQ(damper.Target(), 100);

    FakeClock::Advance(36000 * 3); // the ceiling ramp must not pull it back down
    loop.Loop();
    loop.Loop();
    CC_CHECK_EQ(damper.Target(), 100);

    loop.SetBudget(30, 0); // MainController back: its range rules again
    loop.Loop();
    CC_CHECK_EQ(damper.Target(), 0);
}

CC_TEST(RoomControlLoop, AnOrdinaryRoomDropsItsMinWhenTheBusIsLost)
{
    ResetWorld();
    LinkMaster      link;
    Damper          damper;
    ThermostatLink  thermostatLink(link, damper);
    SupplyTemp      supplyTemp;
    RoomControlLoop loop(thermostatLink, supplyTemp, damper);

    SeedRoom(thermostatLink, 2000, 2000);
    SeedSupply(supplyTemp, 1500);
    loop.SetBudget(60, 40);
    loop.Loop();
    CC_CHECK_EQ(damper.Target(), 40);

    loop.ConnectionLost();
    loop.Loop();
    CC_CHECK_EQ(loop.BudgetMin(), 0);
    CC_CHECK_EQ(damper.Target(), 0);
}
