jeroenweij/ClimateControl/Software/Modules/Thermostat/test/ThermostatHandlerTests.cpp

/*************************************************************
 * Created by J. Weij
 *************************************************************/

#include "BoardPins.h"
#include "Node.h"

#include "Cht40.h"
#include "ThermostatHandler.h"

#include "BusHelpers.h"
#include "FakeBus.h"
#include "FakeClock.h"
#include "FakeConfigStore.h"
#include "FakeFlash.h"
#include "FakeI2c.h"
#include "Test.h"

using NodeLib::ConfigStore;
using NodeLib::Endpoint;
using NodeLib::Id;
using NodeLib::Message;
using NodeLib::ModuleType;
using NodeLib::Node;
using NodeLib::Operation;

namespace
{
    const uint8_t nodeId = NodeLib::THERMOSTAT_NODE_ID;

    // Button GPIOs are active-low with an internal pull-up; the fake register
    // block resets to 0 (every pin reading as "pressed"), so every test must
    // explicitly mark both released before exercising anything else.
    void ReleaseBothButtons()
    {
        GPIOA->IDR |= Board::UserButton2.pin | Board::UserButton.pin;
    }

    void PressButton(const Hal::Pin& button, const bool pressed)
    {
        if (pressed)
        {
            GPIOA->IDR &= ~static_cast<uint32_t>(button.pin);
        }
        else
        {
            GPIOA->IDR |= button.pin;
        }
    }

    void ResetWorld()
    {
        FakeBus::Reset();
        FakeClock::Reset();
        FakeConfig::Reset();
        FakeConfig::SetValid(true);
        FakeConfig::SetNodeId(nodeId);
        FakeConfig::SetModule(ModuleType::Thermostat);
        FakeFlash::Reset(); // blank settings page: the default offset
        FakeI2c::ResetAll();
        ReleaseBothButtons();
    }

    // Queues a well-formed CHT40 measurement so SampleRoom() succeeds.
    void QueueSensorReading(const int16_t centiDegC, const uint16_t centiRH)
    {
        const int32_t  rawTValue     = ((static_cast<int32_t>(centiDegC) + 4500) * 65535) / 17500;
        const int32_t  rawRHValue    = ((static_cast<int32_t>(centiRH) + 600) * 65535) / 12500;
        const uint16_t rawT          = static_cast<uint16_t>(rawTValue);
        const uint16_t rawRH         = static_cast<uint16_t>(rawRHValue);
        const uint8_t  rawTBytes[2]  = {static_cast<uint8_t>(rawT >> 8), static_cast<uint8_t>(rawT)};
        const uint8_t  rawRHBytes[2] = {static_cast<uint8_t>(rawRH >> 8), static_cast<uint8_t>(rawRH)};
        const uint8_t  frame[6]      = {rawTBytes[0],
                                        rawTBytes[1],
                                        Cht40::Crc8(rawTBytes, 2),
                                        rawRHBytes[0],
                                        rawRHBytes[1],
                                        Cht40::Crc8(rawRHBytes, 2)};
        FakeI2c::QueueRead(Cht40::DefaultAddress, frame, sizeof(frame));
    }

    // Bundles Node + ThermostatHandler wired the same way Modules/Thermostat/
    // main.cpp does.
    struct World
    {
        Node              node;
        ThermostatHandler handler;

        World() :
            node(Hal::Uart::Instance::Usart2, Board::LinkUart, 0),
            handler(node)
        {
            handler.Init();
            node.RegisterHandler(&handler);
            node.Init();
        }

        // A ThermostatHandler only queues -- it never writes the bus directly.
        // Real traffic goes out when the paired ControllerNode's LinkMaster
        // polls it (Node::HandleInternalMessage flushes on Operation::Poll),
        // and published values are only queued while those polls arrive:
        // the first poll connects and queues them, the second carries them.
        void FlushToPeer()
        {
            bus::InjectFrame(Message(nodeId, Operation::Poll));
            node.Loop();
            bus::InjectFrame(Message(nodeId, Operation::Poll));
            node.Loop();
        }
    };

    // A press while the panel is off only wakes it: press + release once so
    // the next press steps the setpoint.
    void WakePanel(World& w)
    {
        PressButton(Board::UserButton, true);
        w.handler.Loop();
        PressButton(Board::UserButton, false);
        w.handler.Loop();
    }

    bool FindMessage(Message* const tx, const int n, const Endpoint endpoint, const Operation op, int* const outIndex)
    {
        for (int i = 0; i < n; i++)
        {
            if (tx[i].id.endpoint == endpoint && tx[i].id.operation == op)
            {
                if (outIndex)
                {
                    *outIndex = i;
                }
                return true;
            }
        }
        return false;
    }

    int16_t ReadI16(const uint8_t* const p)
    {
        return static_cast<int16_t>(p[0] | (p[1] << 8));
    }

    Message MakeMessage(const Id& id, const uint8_t* const data, const uint8_t len)
    {
        Message m(id);
        for (uint8_t i = 0; i < len; i++)
        {
            m.data[i] = data[i];
        }
        m.len = len;
        return m;
    }

    CC_TEST(ThermostatHandler, InitPowersAndResetsTheOled)
    {
        ResetWorld();
        World w;

        CC_CHECK((GPIOA->ODR & Board::OledPowerEnable.pin) != 0); // VBAT left on
        CC_CHECK((GPIOA->ODR & Board::OledReset.pin) != 0); // RES# released (idle high) after the pulse
    }

    CC_TEST(ThermostatHandler, ButtonDownStepsSetpointDownHalfADegree)
    {
        ResetWorld();
        World w;
        WakePanel(w);

        PressButton(Board::UserButton2, true);
        w.handler.Loop();
        w.FlushToPeer();

        Message   tx[8];
        const int n   = bus::DecodeTx(tx, 8);
        int       idx = -1;
        CC_CHECK(FindMessage(tx, n, Endpoint::RoomSetpoint, Operation::Report, &idx));
        if (idx >= 0)
        {
            CC_CHECK_EQ(ReadI16(tx[idx].data), 2050); // 21.00 -> 20.50
        }
    }

    CC_TEST(ThermostatHandler, ButtonUpStepsSetpointUpHalfADegree)
    {
        ResetWorld();
        World w;
        WakePanel(w);

        PressButton(Board::UserButton, true);
        w.handler.Loop();
        w.FlushToPeer();

        Message   tx[8];
        const int n   = bus::DecodeTx(tx, 8);
        int       idx = -1;
        CC_CHECK(FindMessage(tx, n, Endpoint::RoomSetpoint, Operation::Report, &idx));
        if (idx >= 0)
        {
            CC_CHECK_EQ(ReadI16(tx[idx].data), 2150); // 21.00 -> 21.50
        }
    }

    CC_TEST(ThermostatHandler, SetpointClampsToTheComfortRange)
    {
        ResetWorld();
        World w;

        // Way more presses than needed to hit the floor from 21.00.
        for (int i = 0; i < 10; i++)
        {
            PressButton(Board::UserButton2, true);
            w.handler.Loop();
            PressButton(Board::UserButton2, false);
            w.handler.Loop();
        }
        w.FlushToPeer();

        // Find the LAST RoomSetpoint Report -- the one carrying the final value.
        Message   tx[16];
        const int n   = bus::DecodeTx(tx, 16);
        int       idx = -1;
        for (int i = 0; i < n; i++)
        {
            if (tx[i].id.endpoint == Endpoint::RoomSetpoint && tx[i].id.operation == Operation::Report)
            {
                idx = i;
            }
        }
        CC_CHECK(idx >= 0);
        if (idx >= 0)
        {
            CC_CHECK_EQ(ReadI16(tx[idx].data), 1900); // clamped at 19.00, not below
        }
    }

    CC_TEST(ThermostatHandler, APressWhileThePanelIsOffOnlyWakesIt)
    {
        ResetWorld();
        World w;
        FakeI2c::ClearWritten(Ssd1306::DefaultAddress);

        // Both buttons at once, panel asleep: wakes it, steps neither way.
        PressButton(Board::UserButton2, true);
        PressButton(Board::UserButton, true);
        w.handler.Loop();
        CC_CHECK(FakeI2c::WrittenLen(Ssd1306::DefaultAddress) > 0); // woke and drew
        PressButton(Board::UserButton2, false);
        PressButton(Board::UserButton, false);
        w.handler.Loop();
        w.FlushToPeer();

        Message   tx[8];
        const int n   = bus::DecodeTx(tx, 8);
        int       idx = -1;
        CC_CHECK(FindMessage(tx, n, Endpoint::RoomSetpoint, Operation::Report, &idx));
        if (idx >= 0)
        {
            CC_CHECK_EQ(ReadI16(tx[idx].data), 2100); // still 21.00
        }
    }

    CC_TEST(ThermostatHandler, OnceThePanelSleepsAgainTheNextPressOnlyWakesIt)
    {
        ResetWorld();
        World w;
        WakePanel(w);

        FakeClock::Advance(61000); // past the 60 s awake time
        w.handler.Loop(); // panel goes off

        PressButton(Board::UserButton, true);
        w.handler.Loop();
        w.FlushToPeer();

        Message   tx[8];
        const int n   = bus::DecodeTx(tx, 8);
        int       idx = -1;
        CC_CHECK(FindMessage(tx, n, Endpoint::RoomSetpoint, Operation::Report, &idx));
        if (idx >= 0)
        {
            CC_CHECK_EQ(ReadI16(tx[idx].data), 2100);
        }
    }

    CC_TEST(ThermostatHandler, HoldingAButtonStepsOnlyOnce)
    {
        ResetWorld();
        World w;
        WakePanel(w);

        PressButton(Board::UserButton, true);
        w.handler.Loop();
        w.handler.Loop(); // still held -- must not step again
        w.FlushToPeer();

        Message   tx[8];
        const int n   = bus::DecodeTx(tx, 8);
        int       idx = -1;
        CC_CHECK(FindMessage(tx, n, Endpoint::RoomSetpoint, Operation::Report, &idx));
        if (idx >= 0)
        {
            CC_CHECK_EQ(ReadI16(tx[idx].data), 2150); // one step, not two (21.00 -> 21.50 only)
        }
    }

    CC_TEST(ThermostatHandler, SampleRoomUpdatesFromTheSensorAndPublishesOnTheDeadband)
    {
        ResetWorld();
        World w;

        QueueSensorReading(2350, 5000); // the first real reading
        FakeClock::Advance(3000); // past sampleIntervalMs (2000)
        w.handler.Loop();
        w.FlushToPeer();

        Message   tx[8];
        const int n   = bus::DecodeTx(tx, 8);
        int       idx = -1;
        CC_CHECK(FindMessage(tx, n, Endpoint::RoomTemp, Operation::Report, &idx));
        if (idx >= 0)
        {
            // 2349, not 2350 -- QueueSensorReading()'s encode and Cht40::Measure()'s
            // decode each truncate independently, same as the real 16-bit ADC ticks
            // would; not an exact round trip. Then the self-heating offset.
            CC_CHECK_EQ(ReadI16(tx[idx].data), 2349 + ThermostatHandler::DefaultRoomTempOffsetCentiDegC);
        }
        CC_CHECK(FindMessage(tx, n, Endpoint::RoomHumidity, Operation::Report, nullptr));
    }

    CC_TEST(ThermostatHandler, GetRoomTempForcesAReport)
    {
        ResetWorld();
        QueueSensorReading(2100, 4500); // Init()'s first sample -- a real reading exists
        World w;
        FakeBus::Reset();

        bus::InjectFrame(Message(Id(nodeId, Endpoint::RoomTemp, Operation::Get)));
        w.FlushToPeer(); // processes the Get, then the injected Poll flushes the forced Report

        Message   tx[8];
        const int n = bus::DecodeTx(tx, 8);
        CC_CHECK(FindMessage(tx, n, Endpoint::RoomTemp, Operation::Report, nullptr));
    }

    CC_TEST(ThermostatHandler, WithoutASensorReadingNoRoomTempIsReported)
    {
        ResetWorld(); // nothing queued on the fake I2C: the sensor never answers
        World w;
        FakeClock::Advance(3000);
        w.handler.Loop();
        w.FlushToPeer();

        Message   tx[8];
        const int n = bus::DecodeTx(tx, 8);
        CC_CHECK(!FindMessage(tx, n, Endpoint::RoomTemp, Operation::Report, nullptr)); // no placeholder 21.00
        CC_CHECK(!FindMessage(tx, n, Endpoint::RoomHumidity, Operation::Report, nullptr));
        CC_CHECK(FindMessage(tx, n, Endpoint::RoomSetpoint, Operation::Report, nullptr)); // the setpoint is real

        FakeBus::Reset();
        bus::InjectFrame(Message(Id(nodeId, Endpoint::RoomTemp, Operation::Get)));
        w.FlushToPeer();
        const int n2 = bus::DecodeTx(tx, 8);
        CC_CHECK(FindMessage(tx, n2, Endpoint::RoomTemp, Operation::Nack, nullptr));
    }

    CC_TEST(ThermostatHandler, ASensorThatStopsAnsweringIsDroppedAfterThreeMisses)
    {
        ResetWorld();
        QueueSensorReading(2100, 4500);
        World w; // Init(): one good reading

        for (int i = 0; i < 2; i++) // two misses: still a glitch, the reading stands
        {
            FakeClock::Advance(2100);
            w.handler.Loop();
        }
        FakeBus::Reset();
        bus::InjectFrame(Message(Id(nodeId, Endpoint::RoomTemp, Operation::Get)));
        w.FlushToPeer();
        Message   tx[8];
        const int n = bus::DecodeTx(tx, 8);
        CC_CHECK(FindMessage(tx, n, Endpoint::RoomTemp, Operation::Report, nullptr));

        FakeClock::Advance(2100); // the third miss
        w.handler.Loop();
        FakeBus::Reset();
        bus::InjectFrame(Message(Id(nodeId, Endpoint::RoomTemp, Operation::Get)));
        w.FlushToPeer();
        const int n2 = bus::DecodeTx(tx, 8);
        CC_CHECK(FindMessage(tx, n2, Endpoint::RoomTemp, Operation::Nack, nullptr));
    }

    CC_TEST(ThermostatHandler, SetOnARoomTempEndpointIsRejected)
    {
        ResetWorld();
        World w;
        FakeBus::Reset();

        uint8_t value = 0;
        bus::InjectFrame(MakeMessage(Id(nodeId, Endpoint::RoomTemp, Operation::Set), &value, 1));
        w.FlushToPeer();

        Message   tx[8];
        const int n = bus::DecodeTx(tx, 8);
        CC_CHECK(FindMessage(tx, n, Endpoint::RoomTemp, Operation::Nack, nullptr));
    }

    CC_TEST(ThermostatHandler, MasterSetpointOverrideIsAccepted)
    {
        ResetWorld();
        World w;

        uint8_t payload[2] = {0xD0, 0x07}; // 2000 = 20.00C, little-endian
        bus::InjectFrame(MakeMessage(Id(nodeId, Endpoint::RoomSetpoint, Operation::Set), payload, 2));
        w.node.Loop(); // applies the override -- no reply expected

        FakeBus::Reset();
        bus::InjectFrame(Message(Id(nodeId, Endpoint::RoomSetpoint, Operation::Get)));
        w.FlushToPeer();

        Message   tx[8];
        const int n   = bus::DecodeTx(tx, 8);
        int       idx = -1;
        CC_CHECK(FindMessage(tx, n, Endpoint::RoomSetpoint, Operation::Report, &idx));
        if (idx >= 0)
        {
            CC_CHECK_EQ(ReadI16(tx[idx].data), 2000);
        }
    }

    CC_TEST(ThermostatHandler, CachesDamperActualAndModeFromTheControllerNode)
    {
        ResetWorld();
        World w;

        uint8_t actual = 42;
        w.handler.ReceivedMessage(MakeMessage(Id(nodeId, Endpoint::DamperActual, Operation::Set), &actual, 1));
        uint8_t mode = 3;
        w.handler.ReceivedMessage(MakeMessage(Id(nodeId, Endpoint::DamperMode, Operation::Set), &mode, 1));

        // No public getter -- a button press wakes the display, which then
        // renders (and Flush()es) using the cached values; absence of a crash
        // plus a non-trivial write to the OLED is the observable contract here.
        PressButton(Board::UserButton2, true);
        w.handler.Loop();
        CC_CHECK(FakeI2c::WrittenLen(0x3C) > 0);
    }

    CC_TEST(ThermostatHandler, DisplayWakesOnPressAndStaysAsleepOtherwise)
    {
        ResetWorld();
        World w;

        FakeI2c::ClearWritten(0x3C);
        w.handler.Loop(); // no button activity -- panel stays off, nothing drawn
        CC_CHECK_EQ(FakeI2c::WrittenLen(0x3C), 0);

        PressButton(Board::UserButton2, true);
        w.handler.Loop();
        CC_CHECK(FakeI2c::WrittenLen(0x3C) > 0); // On() + a rendered frame went out
    }

    CC_TEST(ThermostatHandler, ConnectionLostDoesNotCrashAndPreservesTheSetpoint)
    {
        ResetWorld();
        World w;

        w.handler.ConnectionLost();
        w.handler.Snoop(Message());

        WakePanel(w);
        PressButton(Board::UserButton, true);
        w.handler.Loop();
        w.FlushToPeer();

        Message   tx[8];
        const int n   = bus::DecodeTx(tx, 8);
        int       idx = -1;
        CC_CHECK(FindMessage(tx, n, Endpoint::RoomSetpoint, Operation::Report, &idx));
        if (idx >= 0)
        {
            CC_CHECK_EQ(ReadI16(tx[idx].data), 2150); // still steps normally from 21.00
        }
    }
    // Display traffic: bytes written to the OLED since the last check.
    size_t DisplayWrites()
    {
        const size_t n = FakeI2c::WrittenLen(Ssd1306::DefaultAddress);
        FakeI2c::ClearWritten(Ssd1306::DefaultAddress);
        return n;
    }

    CC_TEST(ThermostatHandler, WakingTheDisplayDrawsOnceThenNothingWhileUnchanged)
    {
        ResetWorld();
        World w;
        DisplayWrites(); // Init()'s bring-up

        PressButton(Board::UserButton, true); // wakes the panel
        w.handler.Loop();
        CC_CHECK(DisplayWrites() > 1000); // one full frame (1 KB)

        PressButton(Board::UserButton, false);
        for (int i = 0; i < 20; i++)
        {
            FakeClock::Advance(50);
            w.handler.Loop();
        }
        CC_CHECK_EQ(DisplayWrites(), 0u); // nothing on screen changed -- no redraws
    }

    CC_TEST(ThermostatHandler, AVisibleChangeRedrawsButNotWithinTheMinimumInterval)
    {
        ResetWorld();
        World w;
        PressButton(Board::UserButton, true);
        w.handler.Loop(); // wake + first frame
        PressButton(Board::UserButton, false);
        w.handler.Loop();
        DisplayWrites();

        FakeClock::Advance(50);
        PressButton(Board::UserButton, true); // another setpoint step, 50 ms after the last frame
        w.handler.Loop();
        CC_CHECK_EQ(DisplayWrites(), 0u); // too soon -- waits

        FakeClock::Advance(200); // past the 200 ms minimum
        w.handler.Loop();
        CC_CHECK(DisplayWrites() > 1000); // the pending change is drawn
    }

    // Sends a RoomTempOffset Set and returns the Thermostat's answer (Report
    // or Nack) -- tx[idx] on success, idx -1 if it sent neither.
    int SetTempOffset(World& w, const int16_t centiDegC, Message* const tx, const int max, const Operation answer)
    {
        const uint8_t payload[2] = {static_cast<uint8_t>(centiDegC), static_cast<uint8_t>(static_cast<uint16_t>(centiDegC) >> 8)};
        FakeBus::Reset();
        bus::InjectFrame(MakeMessage(Id(nodeId, Endpoint::RoomTempOffset, Operation::Set), payload, 2));
        w.FlushToPeer();
        int idx = -1;
        FindMessage(tx, bus::DecodeTx(tx, max), Endpoint::RoomTempOffset, answer, &idx);
        return idx;
    }

    int16_t GetTempOffset(World& w)
    {
        FakeBus::Reset();
        bus::InjectFrame(Message(Id(nodeId, Endpoint::RoomTempOffset, Operation::Get)));
        w.FlushToPeer();
        Message tx[8];
        int     idx = -1;
        CC_CHECK(FindMessage(tx, bus::DecodeTx(tx, 8), Endpoint::RoomTempOffset, Operation::Report, &idx));
        return idx >= 0 ? ReadI16(tx[idx].data) : 0;
    }

    CC_TEST(ThermostatHandler, WithoutAStoredOffsetTheDefaultIsAppliedAndReported)
    {
        ResetWorld();
        World w;
        CC_CHECK_EQ(GetTempOffset(w), ThermostatHandler::DefaultRoomTempOffsetCentiDegC);
    }

    CC_TEST(ThermostatHandler, ASetOffsetIsAppliedStoredAndSurvivesARestart)
    {
        ResetWorld();
        {
            World     w;
            Message   tx[8];
            const int idx = SetTempOffset(w, -150, tx, 8, Operation::Report);
            CC_CHECK(idx >= 0);
            if (idx >= 0)
            {
                CC_CHECK_EQ(ReadI16(tx[idx].data), -150);
            }

            QueueSensorReading(2350, 5000);
            FakeClock::Advance(3000); // past sampleIntervalMs
            w.handler.Loop();
            FakeBus::Reset();
            bus::InjectFrame(Message(Id(nodeId, Endpoint::RoomTemp, Operation::Get)));
            w.FlushToPeer();
            int t = -1;
            CC_CHECK(FindMessage(tx, bus::DecodeTx(tx, 8), Endpoint::RoomTemp, Operation::Report, &t));
            if (t >= 0)
            {
                CC_CHECK_EQ(ReadI16(tx[t].data), 2349 - 150); // see SampleRoomUpdates... for the 2349
            }

            const int erases = FakeFlash::EraseCount();
            SetTempOffset(w, -150, tx, 8, Operation::Report); // same value again
            CC_CHECK_EQ(FakeFlash::EraseCount(), erases); // no flash cycle
        }

        // Reboot -- settings page kept.
        FakeBus::Reset();
        FakeI2c::ResetAll();
        World w2;
        CC_CHECK_EQ(GetTempOffset(w2), -150);
    }

    CC_TEST(ThermostatHandler, AnOutOfRangeOffsetIsRefused)
    {
        ResetWorld();
        World   w;
        Message tx[8];
        CC_CHECK(SetTempOffset(w, 1500, tx, 8, Operation::Nack) >= 0); // > 10.00 degC
        CC_CHECK_EQ(GetTempOffset(w), ThermostatHandler::DefaultRoomTempOffsetCentiDegC);
    }
} // namespace
