jeroenweij/ClimateControl/Software/Modules/MainBootloader/NinaAt.cpp

/*************************************************************
 * Created by J. Weij
 *************************************************************/

#include <string.h>

#include "BoardPins.h"

#include "NinaAt.h"

using Hal::UartPin;

namespace
{
    const uint32_t NinaBaud = 115200;
}

NinaAt::NinaAt() :
    ninaReset(Board::NinaReset, Hal::Gpio::Mode::OpenDrain),
    uart(),
    parser(),
    dataMode(false),
    commandPending(false),
    pendingResult(Result::Timeout),
    commandTimeout(),
    resetPending(false),
    resetTimer()
{
}

void NinaAt::Init()
{
    // NinaRts (PA1) is USART2's own hardware RTS alternate function --
    // NinaUart::Init() configures and drives it, nothing to do here (this used to bit-bang NinaRts as a plain GPIO output, which
    // fought NinaUart::Init()'s AF1 pin config for the same physical pin --
    // see NinaUart.cpp's Init() comment).
    uart.Init(NinaBaud);

    PulseReset();
}

void NinaAt::PulseReset()
{
    // Active-low, open-drain; >=50 us low per the module's datasheet
    // (MainController-Spec.md §5). Async -- see the resetPending/resetTimer
    // comment in NinaAt.h -- Loop() releases it once resetPulseMs elapses.
    // The 100 ms margin is generous but no longer costs anything: nothing
    // else here blocks waiting for it.
    const uint32_t resetPulseMs = 100;

    ninaReset.Write(false);
    resetTimer.Start(resetPulseMs);
    resetPending = true;

    dataMode       = false;
    commandPending = false;
    pendingResult  = Result::Timeout;
    parser.Reset();
}

void NinaAt::Loop()
{
    if (resetPending && resetTimer.Finished())
    {
        ninaReset.Write(true);
        resetPending = false;
    }

    if (dataMode)
    {
        return; // caller drains raw bytes itself
    }

    while (uart.Available())
    {
        const NinaLineParser::LineResult lineResult = parser.FeedByte(uart.ReadByte());
        if (commandPending && lineResult != NinaLineParser::LineResult::None)
        {
            pendingResult  = (lineResult == NinaLineParser::LineResult::Ok) ? Result::Ok : Result::Error;
            commandPending = false;
        }
    }

    if (commandPending && commandTimeout.Finished())
    {
        pendingResult  = Result::Timeout;
        commandPending = false;
    }
}

bool NinaAt::SendCommand(const char* const command, const uint32_t timeoutMs)
{
    if (commandPending)
    {
        return false;
    }

    uart.WriteBytes(reinterpret_cast<const uint8_t*>(command), strlen(command));
    uart.WriteBytes(reinterpret_cast<const uint8_t*>("\r\n"), 2);

    commandPending = true;
    pendingResult  = Result::Pending;
    commandTimeout.Start(timeoutMs);
    return true;
}

NinaAt::Result NinaAt::PollResult() const
{
    return commandPending ? Result::Pending : pendingResult;
}

int NinaAt::LastPeerHandle() const
{
    return parser.LastPeerHandle();
}

bool NinaAt::NextEvent(Event& event)
{
    return parser.NextEvent(event);
}

void NinaAt::EnterDataMode()
{
    dataMode = true;
}

bool NinaAt::InDataMode() const
{
    return dataMode;
}

bool NinaAt::Available() const
{
    return uart.Available();
}

uint8_t NinaAt::ReadByte()
{
    return uart.ReadByte();
}

void NinaAt::WriteBytes(const uint8_t* const data, const size_t len)
{
    uart.WriteBytes(data, len);
}
