jeroenweij/ClimateControl/Software/test/fake/FakeSystem.cpp

/*************************************************************
 * Created by J. Weij
 *************************************************************/

#include "System.h"

namespace Hal
{
    namespace System
    {
        void Init()
        {
        }

        bool ClockTo64MHz()
        {
            return true;
        }

        void Sleep()
        {
        }

        void SetVectorTable(const uint32_t)
        {
        }

        void JumpToApplication(const uint32_t)
        {
            while (true)
            {
            }
        }

        void Reset()
        {
            while (true)
            {
            }
        }

        uint8_t ResetCause()
        {
            return 0;
        }
    } // namespace System
} // namespace Hal
