jeroenweij/ClimateControl/Software/Modules/MainBootloader/NinaUart.h

/*************************************************************
 * Created by J. Weij
 *************************************************************/

#pragma once

#include <stddef.h>
#include <stdint.h>

#include "NinaPort.h"

namespace Boot
{
    // Minimal USART2 driver for the on-board NINA-W152 link only -- plain
    // point-to-point UART with hardware RTS (Lib/Board/BoardPins.h's
    // NinaRts) so NINA is throttled if RX ever falls behind, NOT RS485
    // half-duplex DE (unlike Modules/Bootloader/OtaUart.cpp -- the NINA link
    // has no shared bus and no DE net). TX ignores NINA's RTS (no CTS
    // handling), matching the running app. Bypasses Lib/HAL/Uart so the
    // ~17 KB STM32Cube UART driver stays out of the 10 KB bootloader image.
    //
    // RX is interrupt-driven, backed by a small ring buffer -- same reasoning
    // as Bootloader/OtaUart.cpp's: a poll-only receiver can miss a byte that
    // lands while the caller is off doing something else for a stretch (a
    // multi-page flash erase/program run being the main one here too), with
    // nothing deeper than the single-byte hardware RDR to hold it.
    class NinaUart : public NinaPort
    {
      public:
        void Init(const uint32_t baudRate) override;

        bool    Available() const override;
        uint8_t ReadByte() override;

        bool WriteBytes(const uint8_t* const data, const size_t len) override;

        // WriteBytes() already waits for the last byte to leave the shifter.
        void Flush() override {}
    };
} // namespace Boot
