jeroenweij/ClimateControl/(commit log)

2026-09-07 Port NodeLib to STM32G0 HAL, add Tools, wire CMake build
    Hal wraps the vendored STM32Cube HAL for Gpio/Uart/Crc/Tick/System, Tools
    ports DelayTimer/SStream/Logger off Hal, and NodeLib is ported from the
    AVR original onto the v2 wire protocol (variable-length frame, CRC16,
    hardware RS485 DE) with the framing layer split out into Frame.h/.cpp.
    Adds the ARM toolchain file and CMakeLists wiring Hal/Tools/NodeLib as
    static libraries; builds clean against arm-none-eabi-gcc for cortex-m0plus.
2026-09-07 First hardware designs
    [BOM_Base_Schematic1_2026-09-07.xlsx, BOM_MainController_Schematic1_1_2026-09-07.xlsx]
2026-09-07 Use pin assignment from board definitions
2026-09-08 Lock in Design to STM32G031F8P6
2026-09-08 Main controller board finalize
    [BOM_MainController.xlsx, BOM_MainController_Schematic1_1_2026-09-07.xlsx]
2026-09-08 Add bootloader + MainController firmware base and module build system
    Module build infrastructure (none existed before):
    - Lib/Startup: shared startup_stm32g031xx.s (G031 vector table, .data/.bss
    init) + newlib-nano syscall stubs, as an OBJECT lib linked into every image
    - per-module linker scripts: bootloader 8K @ 0x08000000, MainController app
    52K @ 0x08002000 with the image descriptor pinned at +0xC0
    - cmake/stm32.cmake: add_stm32_executable() -> .elf + .bin/.hex + size +
    a flash-<name> J-Link target (via cmake/gen_jlink_script.cmake)
    - toolchain: enable ASM, newlib-nano + nosys, -fno-exceptions/-fno-rtti,
    exe link flags
    HAL:
    - Hal::Backup -- TAMP backup registers (app <-> bootlo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
2026-09-09 Create temperatureNode framework
2026-09-09 Add factory ConfigRecord generator and provisioning wrapper
    tools/gen_config_record.py builds the 32-byte identity record
    (NodeLib::ConfigStore layout, zlib CRC-32) as Intel HEX or a raw blob.
    tools/provision.py wraps it: generate -> J-Link commander script -> erase
    the 0x0800F000 config page and program it. One run per unit; --dry-run
    prints the command when JLinkExe is absent.
    Spec/Node-Flash-Layout-and-Bootloader-Spec.md §6.3.
    Claude-Session: https://claude.ai/code/session_01ByoMcupPiHU1EY3LhPoq54
2026-09-10 Rewrite server-link spec: SPA architecture, drop decision-history wording
    - §6 recast as a clean "Server architecture": four responsibilities, three
    network surfaces (static app bundle / JSON API / WebSocket), the
    NINA-socket -> decode -> WebSocket -> browser data path, and the SPA
    client model. The site is dynamic and realtime; only the app bundle is
    served as files.
    - WebSocket chosen for live push; single-page app chosen for the UI.
    - Strip "decided <date>", "was X / now Y", alternatives-considered, and
    "recommendation / not hard-locked" phrasing throughout; state the
    current design directly.
    - Fold the old §10 implementation notes into §6; renumber; trim §11
    open items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
2026-09-10 Add the ClimateControl building server (Webserver/)
    A Go daemon implementing the server side of MainController-Server-Link-Spec.md:
    - internal/nodelib: NodeLib v2 frame codec (CRC-16/CCITT-FALSE, streaming
    deframer, encoder), endpoint payload decoders, and the OTA image-descriptor
    parser. Mirrors Software/Lib/NodeLib; unit-tested against the canonical CRC
    check value and round-trip/resync cases.
    - internal/uplink: TCP listener for the MainController. Validates the
    UplinkHello token, deframes the stream, dispatches relayed node frames and
    the 0x60 uplink block, and holds the bounded downlink queue.
    - internal/service: wires the uplink to the store and hub; drives firmware
    pushes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
2026-09-10 CI: fix source dir + toolchain, sync CLAUDE.md with current tree
    The build workflow ran cmake with only -B, so it used the repo root
    (no CMakeLists.txt) as the source dir. Point it at Software/, install
    the ARM toolchain on the runner, add a size report + firmware artifact
    upload, and make the not-yet-existent test step non-blocking.
    CLAUDE.md: TemperatureNode now has a framework and builds; ControllerNode
    and Thermostat directories don't exist yet; add Webserver/ and the CI
    workflow; list the HAL wrappers incl. OneWire.
2026-09-10 Add a host unit-test framework + CI test/format jobs
    The firmware is cross-compiled for Cortex-M0+, so tests build separately with
    the runner's native g++ against fakes for Lib/HAL and NodeLib::ConfigStore.
    - Software/test/: standalone host CMake project
    - framework/ : ~150-line xUnit harness (CC_TEST / CC_CHECK), no external deps
    + BusHelpers for encoding/decoding NodeLib frames over the fake bus
    - fake/ : Hal::Tick/Uart/Crc/Gpio/System/Backup + ConfigStore doubles,
    dummy stm32g0xx_hal.h, gImageDescriptor stub
    - Suites live per-module in a test/ folder, registered with cc_add_test():
    - Tools/DelayTimer : deadlines, restart, stop
    -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
2026-09-10 CI: pin clang-format to 23.1.0 to match the formatted tree
    The tree was last run through clang-format 23 (the dev machine's pipx
    install). clang-format <= 21 disagrees on AlignConsecutiveDeclarations in
    Lib/Board/BoardPins.h, so the 19.x pin would have failed the format job
    on pre-existing code.
2026-09-10 CI: bump JS actions off the deprecated Node 20 runtime
    actions/checkout v4 -> v5, actions/setup-python v5 -> v6,
    actions/upload-artifact v4 -> v5 -- all now target node24.
    carlosperate/arm-none-eabi-gcc-action@v1 already runs on node24.
2026-09-10 CLAUDE.md: note the Webserver nodelib mirror + fix stale CI note
    - Webserver/internal/nodelib is a hand-kept Go port of Software/Lib/NodeLib;
    wire-format changes must land in both.
    - CI clang-format pin is 23.1.0, not 19 (corrected after dda98da).
2026-09-10 Spec: Finalize ControllerNode-Thermostat link and bus details
    - Resolve key design items for the ControllerNode-Thermostat link, OTA,
    and main bus communication.
    - The Thermostat link is now half-duplex RS485, reusing the existing bus
    bootloader for OTA via a `LinkMaster` in the ControllerNode application.
    - Defines Thermostat firmware update flow, including a new
    `ThermostatFirmware` endpoint and shared node IDs.
    - The main RS485 bus and Thermostat link baud rate is confirmed at 250 000.
    - ControllerNode servo power is now gated by the MCU, defaulting to off
    to improve power efficiency and fault tolerance.
    - Update companion documentation lists and overall spec status.
2026-09-10 Software: ControllerNode + Thermostat modules, LinkMaster, OTA over the link
    Implements the ControllerNode-Thermostat link firmware from the spec.
    - Bus baud raised to 250000 (Board::BusBaudRate), used by every module.
    - Flash map: bootloader 8 -> 10 KB, app slot 52 -> 50 KB @ 0x08002800.
    The bootloader carries the full OTA slave for both the main bus and the
    Thermostat link; MemoryMap.h + all linker scripts updated.
    - Hal::Uart is dual-instance (USART1 main bus, USART2 Thermostat link);
    clock/GPIO bring-up moved into Init(). Node gets a 3-arg ctor to bind
    a non-default UART.
    - Bootloader OtaUart selects USART2/PA2-PA3-PA1 for a provisioned
    Thermostat, USART1 otherwise; FirmwareSl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
2026-09-10 feat(firmware): Comprehensive management, standardized builds, and hardware updates
    This commit introduces a complete firmware management system within the Webserver, standardizes firmware build outputs for OTA, and reorganizes/optimizes ControllerNode hardware.
    **Webserver:**
    - **Firmware Repository & UI:** Implements a centralized repository for firmware images with new `/api/firmware` endpoints (view, upload, delete). The new UI for the 'Firmware' page displays live update status for all nodes (including MainController and paired thermostats) against held images, with "Update" and "Update all" actions.
    - **Queued OTA Updates:** Enhances the OTA push mechanism with a single-flight queue,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
    [BOM_Base_Schematic1_2026-09-07.xlsx, BOM_ControllerNode_Schematic1_2_2026-09-10.xlsx, BOM_MainController.xlsx]
2026-09-11 Webserver: list endpoints return [] not null when empty
    /api/nodes (and placements/overrides/ota/readings) returned JSON null
    when the table was empty -- the store methods used `var out []T`. In the
    SPA that made renderSetup() throw in fillNodeSelect (state.nodes.filter
    on null) *before* it drew the floor image, so a floor plan showed on the
    Map view but not on Map setup. Also broke the Overrides and Status views
    before any node exists.
    - store: initialise the slices (`out := []T{}`) in Nodes, Floors,
    Placements, Overrides, OtaJobs, Readings.
    - app.js: coerce the list loads to [] defensively.
2026-09-11 Webserver UI: room outlines on the map (flood fill + manual), node names
    Map setup:
    - "Place node" dropdown now shows the node's roster name instead of its
    module/type, matching the node table elsewhere in the UI.
    - Selecting an already-placed node highlights its marker on the plan
    (accent color + pulsing halo) so it's clear which one is selected.
    - New placement mode besides the existing point marker: flood-fill a
    room from a clicked point (adjustable tolerance, live preview, runs at
    the floor plan's native resolution with a per-channel color threshold
    to avoid leaking through thin walls) or trace it manually by clicking
    corners, with either falling back to the other on request.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
2026-09-11 Spec: lock Thermostat touch keys, OLED module, enclosure look, link power/wiring
    Thermostat hardware (§4):
    - 2 mechanical buttons -> capacitive touch (Holtek BS212C-1, C42372571)
    behind a copper-mesh electrode, to support a sealed enclosure. Output
    polarity matches the existing InputPullUp wiring, no firmware change.
    - OLED locked to a specific part: Wisevision X096-2864KSWPG01-H30
    (C18723026), a true bare-COG SSD1315 module with no onboard regulator.
    Documents the I2C pin-strapping and internal-charge-pump wiring pulled
    from the real datasheet.
    - New §4.6: enclosure styled after the IKEA TIMMERFLOTTE (small matte
    white puck, flush controls) with the two honest deltas noted (wi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
2026-09-11 mv filenames
    [BOM.xlsx]
2026-09-11 ControllerNode: JLCPCB Basic parts, DS3225 servo, link bias resistors
    Hardware/ControllerNode (EasyEDA export: SCH.pdf, Netlist.net, BOM.csv
    replacing BOM.xlsx):
    - Buck feedback divider (R1/R2) retuned 56.9k/10k -> 75k/12k (~5.44V),
    landing on JLCPCB Basic parts and staying under the RT9080/XC6206
    shared-rail LDO ceiling rather than the servo's own higher range.
    - ENABLE pull-up (R4) 1.5M -> 1M, Basic part, same 200V/250mW rating.
    - ENABLE pull-up/series-resistor topology corrected: R4 now pulls up
    the shared bus ENABLE net directly from local 48V, R11 links that
    net to the buck EN pin, matching the documented ground-offset
    rationale (was inverted in an earlier revision).
    - Added R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
    [BOM.csv, BOM.xlsx]
2026-09-12 Thermostat: OLED/touch/sensor wiring, MCU pins, VBAT regulator
    Hardware/Thermostat (EasyEDA export: SCH.pdf, Netlist.net, BOM.csv --
    first commit of this board's hardware):
    - OLED (X096-2864KSWPG01-H30/SSD1315) wired for I2C per its datasheet's
    internal-charge-pump reference circuit: SCL/SDA -> PB6/PB7, RES# ->
    PA0, VBAT power-switch gate -> PA4.
    - VBAT fed from a dedicated MD7218A38PA1 LDO (fixed 3.8V, in-spec for
    the OLED's 3.5-4.2V VBAT range) instead of tying to the 3.3V rail.
    R17 (0R, DNP) kept as a footprint-only fallback to bridge +3V3 to
    +VIN if the regulator needs to be pulled.
    - BS212C-1 capacitive touch IC replaces both mechanical buttons:
    KOUT1/KOUT2 -> PA11/PA12 (sam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
    [BOM.csv]
2026-09-12 BoardPins.h: compile-time board guards for board-specific pins
    Each board's pins (NinaCts/NinaRts/NinaReset/BusEnableDrive for
    MainController, OneWire1/OneWire2 for TemperatureNode, ServoPwm/
    ServoEnable for ControllerNode, I2cSda/I2cScl/I2cAf/Button2/OledReset/
    OledPowerEnable for Thermostat) are now behind #if defined(CC_BOARD_
    <Module>), so referencing e.g. a Thermostat pin from ControllerNode
    firmware is a build error instead of a silent wiring mistake found at
    bring-up. Shared pins (main bus, LEDs, UserButton, USART2 group) stay
    unguarded since NodeLib and the bootloader link into every board and
    only ever touch those.
    - cmake/stm32.cmake: add_stm32_executable() now defines CC_BOARD_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
2026-09-12 CI: build job matrix over Release + Debug
    The build job now runs as a strategy.matrix over build_type: [Release,
    Debug] instead of a single hardcoded Release build, with fail-fast off
    so one configuration breaking doesn't hide the other's result.
    BUILD_TYPE/BUILD_DIR moved out of the top-level env: block (which now
    only keeps SOURCE_DIR, shared by format/test) into the build job, with
    BUILD_DIR computed per matrix leg as Software/build/${{ matrix.build_type
    }} -- mirroring the local build/release + build/debug split from the
    Makefile change. Each leg uploads its own firmware-Release /
    firmware-Debug artifact instead of colliding on one name.
    format and test jobs are unaffected -- neither v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
2026-09-12 Add power sensing to nodecontroller servo control
    [BOM.csv]
2026-09-12 ControllerNode: servo stall detection via current sensing
    Add a minimal polled Hal::Adc driver (no vendor ADC HAL was in tree)
    and wire it into Damper: Loop() polls the INA180A1/shunt current-sense
    channel while the servo is powered and cuts power early on a sustained
    overcurrent, instead of only ever timing out at the full move-settle
    duration.
    Claude-Session: https://claude.ai/code/session_01XxhdJqNv4FMJXxaP7wXnpE
    [Damper.cpp, Damper.h]
2026-09-12 Report Damper stall status via the DamperMode endpoint
    Damper::ReportedMode() substitutes a distinguishable fault code (4 =
    stalled) for the commanded mode while Stalled() is true, RO-only.
    ControllerHandler now reports DamperMode on change (not just on Get)
    so a stall reaches the main bus unsolicited, and ThermostatLink pushes
    it to the paired Thermostat's display. Keeps the Webserver's Go
    NodeLib re-implementation byte-compatible.
    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
    [ControllerHandler.cpp, ControllerHandler.h, Damper.cpp, Damper.h, ThermostatLink.cpp]
2026-09-17 Add standalone NinaEnable bring-up utility for MainController
    Releases the on-board NINA-W152 out of reset without touching USART2, so a
    USB-TTL adapter wired to the module's own UART pins can talk to its AT
    interface directly. Own CMake/Makefile, not part of the normal Software/
    build.
    Claude-Session: https://claude.ai/code/session_01SJnhZwvaGtCNb9bbkAGAR1
    [main.cpp]
2026-09-18 Fix hung SysTick_Handler that froze any HAL_Delay caller
    startup_stm32g031xx.s left SysTick_Handler weakly aliased to
    Default_Handler (an infinite-loop trap). The first SysTick interrupt
    HAL_InitTick() arms in HAL_Init() would trap the CPU there forever,
    hanging every HAL_Delay()/Hal::Tick::DelayMs() call across all
    modules. Add the real handler in Tick.cpp, calling HAL_IncTick().
2026-09-18 NinaEnable: assert NinaRts so the module's flow control allows TX
    u-connectXpress ships with 4-wire HW flow control on by default
    (MainController-Spec.md Sec5): the NINA's UART_CTS input won't let it
    transmit unless driven low. A bench USB-TTL adapter only ever breaks
    out TXD/RXD/GND, so nothing on the bench drove it. Drive NinaRts
    (STM32 PA1 -> NINA UART_CTS) low on boot so the module is free to
    talk to the bench adapter without extra jumper wires.
    [main.cpp]
2026-09-18 Spec: correct NINA transport to u-connectXpress peer API, record bring-up findings
    MainController-Server-Link-Spec.md §3 specified +USOCR/+USOCO/+USOWR/+USORD,
    the cellular-module socket API, which does not exist on u-connectXpress.
    Replaced with the actual mechanism verified on hardware: +UWSC/+UWSCA for
    Wi-Fi station join, +UDCP/+UUDPC for the TCP peer, ATO for data mode.
    MainController-Spec.md §5: NinaRts must be actively driven low by the STM32
    (u-connectXpress ships with HW flow control on by default); RESET_N's
    open-drain Gpio mode now exists, so the stale caveat is removed. Both specs
    note the bench-validated firmware baseline (u-connectXpress 6.4.1-001) and
    confirmed end-to-end Wi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
2026-09-18 Add NINA-W152 uplink driver to MainController firmware
    Implements the bring-up sequence proven by hand this session (Wi-Fi join,
    AT+UDCP TCP peer, ATO data mode) as a non-blocking state machine driven
    from the same super-loop as the bus poll (MainController-Server-Link-
    Spec.md §3):
    - NinaLineParser: pure AT-response/URC line classifier, host-testable
    (NinaLineParserTests).
    - NinaAt: owns the NINA GPIOs and USART2, ticks the line parser in
    command mode, exposes raw byte I/O once in data mode.
    - UplinkHandler: NodeLib::INodeHandler bridging the bus and the uplink --
    bus frames already reach it via NodeMaster's existing handler-forward
    (no NodeLib change needed there); relayed-range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
2026-09-18 UplinkHandler: decouple NINA writes from the bus receive path
    ReceivedMessage() is called synchronously from NodeMaster's byte-at-a-time
    bus receive loop (Node::PumpRx()). Writing straight to NINA there blocked
    bus servicing for the duration of each relayed frame's UART transmit --
    harmless for a single message, but a burst of several queued reports
    from one node (exactly what happens once a real node has real sensors
    to report) blocked long enough to risk missing bytes on the bus UART.
    Add a small outbound queue: ReceivedMessage() (and the uplink-side Send*
    helpers) now only enqueue, and DrainDataMode() writes it out to NINA each
    Loop() call, off the bus's hot path entirely.
    Confirmed via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
    [UplinkHandler.cpp, UplinkHandler.h]
2026-09-18 Add bit-banged debug logger on MainController, fix bit-timing drift
    MainController has no free hardware UART for a console (both USARTs are
    committed to the bus and NINA), so Tools::Logger bit-bangs 8N1 on the
    unpopulated OneWire pin (PA5) instead -- Hal::BitBangSerial, wired up in
    DebugLog.cpp.
    First cut used a fresh Hal::Tick::DelayUs() per bit, re-armed after each
    Gpio::Write(). That call's own overhead (~8.85us) sits outside the timed
    window and stretched every bit period from 104us to ~112.85us, garbling
    every byte at 9600 (confirmed by reverse-fitting the observed capture
    against the known "INFO: Detecting Nodes" log line). Fixed by adding
    Hal::Tick::Micros() and scheduling each bit a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
    [DebugLog.cpp, UplinkHandler.cpp]
2026-09-18 Add UART2 debug logger for TemperatureNode
    Unlike MainController (both USARTs already committed to the bus and NINA,
    forcing a bit-banged console -- DebugLog.cpp there), the TemperatureNode
    variant has NINA DNP and no Thermostat link, so USART2 (Board::Usart2Tx/
    Usart2Rx) is a genuinely free hardware UART. Tools::Logger backend just
    wraps a plain Hal::Uart at 115200 8N1, no bit-banging needed.
    Verified on hardware: reset TemperatureNode (node 1), captured clean
    "Node identity from flash: 1" / "Duct probe ReturnTemp present" / "Duct
    probe SupplyTemp present" over the new console on the first try.
    [DebugLog.cpp]
2026-09-18 Uart circular buffer
2026-09-18 Make Hal::Uart fully interrupt-driven; async NINA reset pulse; loosen poll timeout for triage
    Hal::Uart: both RX and TX are now interrupt-driven off USART1_IRQn/
    USART2_IRQn (previously RX polled RDR directly and TX was drained by a
    Pump() called from Loop()). RXNEIE is armed once in Init() and left on;
    USARTx_IRQHandler empties RDR into a 128-byte ring buffer per instance the
    moment each byte lands, so a byte survives however long the main loop is
    busy elsewhere -- bounded by the ring buffer, not a single-byte hardware
    window. TX mirrors this: WriteBytes() queues into a ring buffer and arms
    TXEIE; the ISR feeds TDR one byte at a time and disarms TXEIE once
    drained. Both ring buffers are loc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
    [FakeBus.cpp, NinaAt.cpp, NinaAt.h, UplinkHandler.cpp]
2026-09-19 NodeMaster: periodically re-run DetectNodes to pick up hot-plugged nodes
    Nodes only announce in reply to a Discover broadcast, never on their own
    power-up, so a node plugged in after the initial DetectNodes() in Init()
    stayed invisible forever. Re-run DetectNodes() every 60s instead: from
    PollNextNode() while the round-robin is running (safe point -- no reply
    is outstanding there), and directly from Loop() when no nodes are active
    at all, since the round-robin then never calls PollNextNode() on its own.
    Also guard the Done handler against a stale/duplicate reply advancing the
    round-robin a second time.
    Bundled in: shorten log level tags, loosen the poll timeout and heartbeat
    interval for bu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
2026-09-19 UplinkHandler: settle after NetworkUp before opening the peer connection
    +UUNU fires before the NINA-W152 can reliably accept AT+UDCP -- the first
    attempt (sometimes two) right after it gets ERROR, then a second +UUNU
    fires and the next attempt succeeds. With only 3 retries budgeted for
    ConnectingPeer, an unlucky run burned the whole budget and fell back to a
    full reset + reboot of the bring-up sequence, which is what showed up as
    repeated "bring-up failed in state 7" in the log.
    Add a NetworkUpSettle state (500ms) between WaitingNetworkUp and
    ConnectingPeer, absorbing that gap the same way DataModeSettle already
    does after ATO. Verified on hardware: 8 of 9 power-cycles came up clean
    on the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
    [UplinkHandler.cpp, UplinkHandler.h]
2026-09-19 UplinkHandler: shrink LinkWatchdogMs from 180s to 60s
    Reproduced on hardware: a server-side restart closes the TCP socket, the
    NINA module notices and reverts to command mode near-instantly, but our
    firmware can't see that -- NinaAt::Loop() stops feeding the AT line
    parser the moment EnterDataMode() is called, since data mode is a raw
    binary pipe and there's no safe way to distinguish a URC from payload
    bytes mid-stream. The only signal left is silence, and the watchdog took
    the full 180s to notice and recover (confirmed via serial capture: watchdog
    fires, resets NINA, reconnects in ~9s).
    60s is still well above KeepaliveIntervalMs (25s) and the server's own 90s
    read deadline (Webserver/int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
    [UplinkHandler.cpp]
2026-09-19 Fix OTA push failures: bootloader UART overrun, master poll collision, async node detection
    Root-caused a chain of bugs that made pushing firmware to a bus node
    via OTA unreliable to totally broken:
    - Boot::OtaUart::Available() never checked or cleared the USART
    overrun/framing/noise error flags. Once one latched (e.g. a byte
    arriving while the bootloader's polling-only Loop() was briefly
    busy), the receiver went permanently deaf until a power-on reset --
    this was the main blocker, since without it OTA never even reached
    the bootloader reliably.
    - NodeMaster::PollNextNode() flushed the queue and immediately wrote
    its own round-robin Poll with zero inter-frame gap, which could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
    [FirmwareSlave.cpp, FirmwareSlave.h, OtaUart.cpp, OtaUart.h, UplinkHandler.cpp, main.cpp]
2026-09-19 Bootloader: interrupt-driven OtaUart RX, off a new HalCore library
    Boot::OtaUart's RX was poll-only (Available()/Read() straight off
    ISR/RDR each FirmwareSlave::Loop() call), the same class of gap the
    NodeMaster fixes address on the master side: a byte arriving during a
    busy stretch (a multi-page flash erase/program run being the main one)
    had nothing deeper than the single-byte hardware RDR to land in before
    Loop() got back around to it. Replaced with a small ring buffer fed by
    USART1_IRQHandler/USART2_IRQHandler, matching Hal::Uart's own RX
    design. On the bench this took a push that previously stalled after a
    few hundred bytes with retries exhausted to one making smooth,
    uninterrupted prog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
    [OtaUart.cpp, OtaUart.h]
2026-09-19 NodeMaster: track per-node bootloader state instead of a global fast-retry interval
    A commanded reset (e.g. Firmware[EnterBootloader]) always sends Done
    before resetting (Node::flushQueue()), so the master sees a clean
    round finish -- but the very next poll to that now-rebooting node
    almost always lands before it's back up, one pollTimeoutMs later
    falsely marking it lost. That's a one-time, per-node, expected hiccup,
    not general bus flakiness, and doesn't need a global timing knob: a
    global short detectIntervalMs was tried earlier and reverted, since on
    a multi-node bus the other nodes staying active keeps nodesFound true
    and masks the need to re-detect the one that actually dropped out.
    Tr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
2026-09-20 OTA: design a synchronous per-write Ack/Nack transfer protocol (v2)
    Bench testing found two distinct OTA failure modes on top of the
    already-fixed timing issues: a status report going uncredited near the
    end of an otherwise-successful transfer, and a transfer that reported
    100% complete but failed the bootloader's whole-image CRC32 check with
    no wire-level frame errors recorded anywhere.
    Writes up a replacement transfer protocol in Node-Flash-Layout-and-
    Bootloader-Spec.md §6.2.1: Firmware[Write] moves from a queued Report
    (a raw progress counter, decoupled from any specific write) to a
    queued Ack/Nack naming the offset plus a CRC16 of the flash bytes just
    read back. Chunk size grows to 32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
2026-09-20 Bootloader: implement OTA transfer protocol v2 (Ack/Nack per write)
    Replaces Firmware[Write]'s reply with a per-write Ack/Nack naming the
    offset plus a CRC16 read back from flash, instead of a queued Status
    Report decoupled from any specific write -- Node-Flash-Layout-and-
    Bootloader-Spec.md Sec6.2.1. Chunk size grows to 32 bytes (from 27) via
    a 2-byte offset field, chosen so every chunk is double-word-aligned and
    independently, immediately flashable: FirmwareSlave::HandleWrite no
    longer stages a RAM page buffer, and Hal::Flash::Program() now reports
    bytes-committed (not just bool) so a partial-program failure can
    resume from the exact right double-word on retry without re-touching
    ones alre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
    [ControllerHandler.cpp, ControllerHandler.h, FirmwareSlave.cpp, FirmwareSlave.h, ThermostatLink.cpp, ThermostatLink.h]
2026-09-20 ota: drive Write via Ack/Nack, fix CRC32 algorithm and MaxData mirror
    Mirrors the bootloader's v2 transfer protocol (Node-Flash-Layout-and-
    Bootloader-Spec.md Sec6.2.1): Write is now offset(2 LE)+32 bytes, and
    the driver waits for that write's own Ack/Nack (echoed offset + a
    flash-verified CRC16) instead of a generic progress Report. A lost ack
    now safely resends the actual data rather than a Get probe, since a
    duplicate is answered from a flash read-back on the node side. Also
    adds the three-part check for a server-side chunking bug this can't
    catch on its own (two independently-computed CRCs over the same wrong
    bytes still agree): slice each chunk fresh from the offset written
    into the wir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
2026-09-20 NodeLib: tighten discovery stagger to 10ms/21 nodes, sized against clock drift
    MAX_NODES (25) and nodeSpacing/NodeSpacingMs (25ms) had no derivation behind
    them. Worst-case analysis against HSI16 clock spread (±1% indoor, per
    Node-Bus-Hardware-Design-Spec.md §6.1) and HAL_Delay quantization shows a
    21-node roster at 10ms spacing still clears the ~0.9ms Announce-frame wire
    time with ~4.3ms of margin at the tail of the roster -- comfortably safe for
    this bus's indoor operating range.
    [FirmwareSlave.cpp]
2026-09-20 OTA: fix EnterBootloader reset TX race, add Begin/End write-retry
    Node::PerformPendingReset() called Hal::System::Reset() immediately
    after queuing the outgoing Ack+Announce+Done, but Hal::Uart::WriteBytes()
    only queues into the interrupt-driven TX ring buffer -- it never blocks
    for the bytes to actually leave the wire. The reset routinely killed the
    UART mid-transmission, corrupting those frames and causing a downstream
    "Lost Node" false-negative that could stall the whole bus for up to one
    detect cycle. Added Hal::Uart::FlushTx() (waits for the ring buffer to
    drain and the hardware's Transmission Complete flag) and call it before
    the reset.
    NodeLib::Frame::Write() now returns whether the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
    [FakeBus.cpp]
2026-09-21 Spec: add Damper-Budget-Spec, resolve room-control-loop open item
    ControllerNode runs the room control loop locally (setpoint/room-temp vs.
    the shared duct SupplyTemp, learned by snooping the bus via a new
    INodeHandler::Snoop() hook); MainController arbitrates a fair-share
    DamperBudget ceiling across online ControllerNodes, never the room loop
    itself. Resolves ControllerNode-Thermostat-Link-Spec.md §6 item 1 and
    MainController-Spec.md §2's dependent open question. Adds the DamperBudget
    endpoint (0x33) to the message model and cross-references from CLAUDE.md's
    spec index.
2026-09-21 Implement DamperBudget: ControllerNode room loop + MainController allocator
    Per Spec/Damper-Budget-Spec.md:
    - Lib/NodeLib: new Endpoint::DamperBudget (0x33); INodeHandler::Snoop() hook
    (called for every frame a slave's UART sees, before the address filter, so
    a node can observe traffic not addressed to it); shared, host-tested
    RoomDemand.{h,cpp} (SupplyHelpsRoom/RoomDemandPercent) so ControllerNode and
    MainController can never disagree on whether supply air helps a given room.
    - ControllerNode: SupplyTemp snoops the shared duct SupplyTemp off the bus
    (it's reported by TemperatureNode, not addressed to this node); RoomControlLoop
    runs the room's control loop (Thermostat setpoint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
2026-09-21 Add unit tests for RoomControlLoop/BudgetAllocator/ControllerHandler/UplinkHandler
    Closes the test-coverage gap flagged when the DamperBudget feature landed:
    RoomControlLoop, BudgetAllocator, ControllerHandler and UplinkHandler had no
    suites of their own (only their lower-level collaborators did, matching the
    project's existing pattern -- but that pattern left the actual new control
    logic untested).
    New test infra: FakeAdc (Hal::Adc double, for Damper's stall-detection ADC
    read) and a second Uart::Init() overload stub in FakeBus.cpp (the plain
    2-wire NINA overload, previously unimplemented since nothing exercised
    NinaAt.cpp on host before). Both are proportionate, narrow additions
    following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
    [ControllerHandlerTests.cpp, FakeAdc.cpp, FakeAdc.h, FakeBus.cpp, RoomControlLoop.cpp, RoomControlLoopTests.cpp]
2026-09-21 Fix gaps in unittests
    [DamperTests.cpp, FakeFlash.cpp, FakeFlash.h, FakeOtaUart.cpp, FakeOtaUart.h, FirmwareSlave.cpp, FirmwareSlaveTests.cpp, ThermostatLinkTests.cpp]
2026-09-21 RoomDemand/BudgetAllocator: round budget splits to nearest, not floor
    Flooring every division systematically understated demand and budget
    shares by up to a point each, compounding across the proportional split
    and the water-fill redistribution -- e.g. a 33.33/66.67 split used to
    land on 33/66 (one point short of the pool), now lands on 33/67.
    [BudgetAllocator.cpp]
2026-09-21 Bootloader: add a boot-fail counter so a crash-looping image self-recovers
    A CRC-valid image that crashes before ever proving itself healthy would
    otherwise boot-loop forever -- the CRC gate alone can't tell "intact" from
    "actually runs". Tools::BootHealth tracks attempts in the already-reserved
    TAMP->BKP1R backup register: the bootloader counts an attempt only when
    it's about to trust a CRC-valid, non-forced-entry image and jump to it (a
    normal OTA EnterBootloader request never counts as a failure); after 5
    attempts with no clear, it stays resident instead of jumping, the same
    recovery path a failed CRC already takes. The app clears the counter after
    10s of uptime, and a freshly-received im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
    [FakeBackup.cpp, FakeBackup.h, FirmwareSlave.cpp, FirmwareSlaveTests.cpp, main.cpp]
2026-09-21 Bootloader: reply to Begin/End/Abort with Ack/Nack, not a generic Report
    Matches Write's existing correlation benefit -- a single lastError byte
    tied unambiguously to the op that failed, instead of a queued Status
    Report racing whatever else is pending. Mirror the change into
    Webserver/internal/nodelib and the OTA driver so a "node" push resolves
    Begin/End immediately on the reply, keeping the Get-probe fallback for a
    lost Set/Ack/Nack. A "thermostat" push (ControllerNode-synthesized
    Report) is unaffected.
    Also fixes a bug this uncovered: Fault() no longer auto-replies, so
    HandleWrite()'s overrun check needs its own explicit Nack.
    [FirmwareSlave.cpp, FirmwareSlave.h, FirmwareSlaveTests.cpp]
2026-09-21 add overrides buttons to webserver
2026-09-21 ControllerNode-Thermostat link: fix announce/poll timing, decouple Discover
    - Node: replace the broken const announceSpacing (self-init typo, and
    computed from nodeId before Init() ever sets it) with an explicit
    announceSpacingOverride (-1 = auto nodeId-based stagger, else fixed ms).
    Thermostat's point-to-point link has no bus contention to stagger
    against, so it now passes 0.
    - LinkMaster: decouple outbound flush from the poll cycle (flush queued
    Set/Get to the peer as soon as it's queued, replacing PollPeerNow()) and
    add a separate discoverTimer that re-broadcasts Discover every 5s so a
    peer that reboots mid-session still gets re-announced. pollIntervalMs
    tightened to 100ms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
    [ThermostatLink.cpp, main.cpp]
2026-09-21 Thermostat: I2C HAL, CHT40MEMS sensor + SSD1306 display drivers, buttons
    - Lib/HAL/I2c: register-level I2C1 master (Standard Mode, 100kHz), the
    only new peripheral driver this needs -- no STM32Cube I2C HAL is
    vendored, same register-level approach as Hal::Adc/Hal::OneWire.
    - Cht40: CHT40MEMS room temp/humidity driver, confirmed against the
    datasheet to be command/CRC/conversion-formula compatible with the
    public Sensirion SHT4x protocol.
    - Ssd1306: 128x64 OLED driver built entirely from primitives (rects,
    circles, 7-segment digits) rather than a hand-transcribed bitmap font --
    nothing to get subtly wrong with no hardware on the bench to check it
    against.
    - ThermostatHandler: wi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
    [Cht40.cpp, Cht40.h, Cht40Tests.cpp, FakeI2c.cpp, FakeI2c.h, ThermostatHandler.cpp, ThermostatHandler.h, ThermostatHandlerTests.cpp]
2026-09-22 UplinkHandler: implement SendRoster() for real
    SendRoster() was a stub that always sent just the terminator ("no
    physical nodes on this bus yet"). NodeMaster now exposes NodeActive/
    NodeInBootloader/NodeLastContactMs so it can walk the actual roster
    and report each active node's module, bootloader state, and last
    contact time -- filling in the Roster report's wire shape that the
    server side already decodes but never received real data for.
    lastContactMs is a new per-node timestamp, updated on a fresh Announce
    and on a successful Poll/Done, deliberately left untouched by a
    forgiven bootloader poll timeout so it still reflects real staleness.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
2026-09-23 MainBootloader: make MainController's NINA-based self-update functional
    Turns the proof-of-concept MainBootloader skeleton into a working
    implementation: Firmware now speaks OtaControl/OtaData (a point-to-point
    protocol, not the bus's Poll-gated Firmware/FirmwareOp) and UplinkHandler
    actually transmits (EnqueueUplink/DrainOutboundQueue were stubs). Replaces
    the RS485-flavoured OtaUart with NinaUart, using the board's real 4-wire
    hardware RTS/CTS flow control instead of RS485 driver-enable mode, and
    fixes a pin-ownership conflict between it and a manual GPIO drive on the
    same net. Adds HalCoreOs/ToolsOs so Debug gets the same -Os treatment as
    Release, closing a budget overflow once the code w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
    [AppImage.cpp, AppImage.h, FakeOtaUart.cpp, Firmware.cpp, Firmware.h, FirmwareTests.cpp, NinaAt.cpp, NinaAt.h]
2026-09-23 MainController self-update end to end: app handoff, server driver
    The running app now handles SystemControl addressed to NODE 0 itself
    (reset -> bootloader/app) instead of relaying it onto the bus, and
    mainController-full.hex pairs with mainBootloader. MainBootloader reuses
    the shared FirmwareError codes, and its UART now enables hardware RTS
    only (no CTS), matching the bench-proven app path.
    Server: OtaControl/OtaData codec, uplink dispatch to the service, and a
    MainController push driver (park in bootloader, Begin, OtaData chunks,
    End, Activate) sharing the chunk loop with the bus driver, with a
    byte-level bootloader model in the tests. The write loop logs per-chunk
    round-trip timing. Spe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
    [Firmware.cpp, NinaAt.cpp, NinaAt.h, NinaUart.cpp, NinaUart.h, UplinkHandler.cpp, UplinkHandler.h]
2026-09-23 Server: show MainController bootloader state, prune OTA job history
    An UplinkHello with fwVersion 0 now marks the connected MainController as
    its bootloader: the uplink is up and a push is allowed, but the bus is
    unmanaged, so every bus node reads offline and the MC row shows
    "bootloader" with an unknown version. The Firmware page refreshes on
    uplink changes so that row no longer goes stale.
    The update queue shows the newest 25 pushes with a "Show more" button.
    The server keeps the last 100 records and deletes older finished ones and
    their stored image copies (queued/running jobs are never pruned).
2026-09-23 Specs: drop open items that have been verified on hardware
    The data-mode relay/hello handshake and MainController self-update no
    longer need an open item; MainBootloader's lack of logging stays as its
    own item. Fix two code comments that cited nonexistent item numbers.
    [Firmware.h, main.cpp]
2026-09-23 MainController: answer Roster Get with a full roster dump
    The app now re-sends the roster (and re-seeds the presence snapshot) when
    the server asks. The server no longer requests one on connect, since the
    MC already pushes it unsolicited right after the hello.
    [UplinkHandler.cpp]
2026-09-23 MainController: test roster, presence and uplink frame handling
    UplinkHandler gains a friend test-access hook so the host tests can call
    SendRoster(), CheckNodePresence() and the frame handling directly and read
    back the outbound queue, against a real NodeMaster over the fake bus.
    Covers roster dumps, presence diffs, Roster/Keepalive Get, relay vs.
    node-0 SystemControl, and ignoring OtaControl/OtaData in the app.
2026-09-23 Bootloader: remove the temporary activity-LED triage code
    The activity LED (member, init, per-frame toggle and heartbeat blink) was
    added for OTA triage. It now lives on the debuglog branch with the other
    debug instrumentation.
2026-09-23 Bootloaders: heartbeat the activity LED so a resident unit is recognisable
    Restores the RS485 bootloader's activity-LED heartbeat (without the
    per-frame triage toggle, which stays on debuglog) and gives MainBootloader
    the same pattern: slow blink while idle or bringing the uplink up, fast
    while receiving an image, error LED blinking after a fault.
    The Gpio test fake now reflects driven output levels on read-back, as real
    hardware does, so the toggle logic can be tested.
    [FakeGpio.cpp, Firmware.cpp, Firmware.h, FirmwareSlave.cpp, FirmwareSlave.h, FirmwareTests.cpp, main.cpp]
2026-09-24 Firmware: one shared NINA driver, bring-up and uplink fixes
    Share the NINA-W152 driver between MainController and MainBootloader
    (Lib/Nina: NinaAt, NinaLineParser, NinaLink over a NinaPort) instead of two
    forks, with the application's and bootloader's handlers on top.
    Bring-up and link fixes found on the bench:
    - wait for a 1 s quiet stretch after +UUNU before AT+UDCP and pace command
    retries, so the module's second +UUNU no longer burns the retry budget;
    discard network events left over from before a module restart
    - every session opens with the UplinkHello: drop whatever the previous
    session left in the send queue (a stale keepalive made the server reject
    every reconnect)
    - the ke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
    [FakeNinaUart.cpp, FakeNinaUart.h, HalNinaPort.cpp, HalNinaPort.h, NinaAt.cpp, NinaAt.h, NinaBringUpTests.cpp]
2026-09-24 Webserver: OTA survives link loss and keeps a window of chunks in flight
    MainController self-update:
    - a chunk that stays unanswered through its retries no longer fails the
    push: wait for the uplink to return, probe OtaControl Get and continue from
    the bootloader's expected offset; a bootloader that lost its state is sent
    Begin again
    - acks are matched to their chunk by offset, so a late ack for an earlier
    chunk cannot be taken for the current one
    - go-back-N window of 4 chunks in flight (an ack covers everything before
    it, a Nack restarts at the offset it names with repeats ignored briefly,
    no progress for 3 s resends from the oldest unacked chunk); bus-node
    pushes keep stop-a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
2026-09-24 Specs: uplink link design, OTA resume/window, NINA stall open item
    MainController-Server-Link-Spec: settle/retry behaviour, hello-first rule,
    keepalive reply must be a Keepalive Report, OTA resume and windowed transfer,
    MainController log design, and the open item on the NINA module no longer
    forwarding UART bytes to TCP when traffic goes quiet for ~120 ms.
    Flash-layout, MainController and message-model specs updated to match;
    CLAUDE.md lists Lib/Nina.
2026-09-24 Webserver: bus-node and Thermostat pushes resume after the uplink goes quiet
    When a chunk stays unanswered through its retries, the push no longer fails.
    It waits up to 120 s for the uplink, probes the bootloader's status and
    continues from the expectedOffset it reports: the node is untouched when the
    MainController resets its NINA, so it keeps everything received. An Idle
    bootloader (restarted) is sent Begin again; a node that answers nothing for 90
    probes is presumed to have booted its app and is sent EnterBootloader and
    Begin again (not for Thermostat pushes); a node that never answers fails the
    job with a clear message.
    The wait for the uplink is one shared setting for MainController an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
2026-09-26 Specs: THVD2410 fault-protected transceiver, main-bus A/B clamp DNP
    RJ45 gives no mating order and puts +48V and GND on opposite edges, so a
    tilted plug can mate +48V and A/B before GND. The node's ground then floats
    and its input-stage current returns through A/B, destroying standard
    -7/+12V transceivers across the bus. The THVD2410 (C1849398, same SO-8
    pinout) withstands +-70V on A/B; with no low-voltage clamp on the main bus
    there is no return path. The main-bus SM712 (U3) is DNP since it would
    conduct and become that path. The Thermostat link also moves to THVD2410
    but keeps its SM712: only +5V shares that cable.
2026-09-26 Hardware: THVD2410 on bus and Thermostat link, main-bus SM712 DNP
    All three boards move to the +-70V fault-protected THVD2410DR (C1849398);
    the main-bus SM712 (U3) is DNP on ControllerNode and MainController, the
    Thermostat link keeps its SM712. The buck EN filter cap (C15), which sits
    at the ~48V ENABLE level, is now 100nF/100V 0805 instead of a 16V part.
    Also: Thermostat C13/C14 ground pins connected, SMD side-entry XH
    connector, LED part swaps, MainController SWCLK pull-down and basic-part
    passive swaps, BOM exported as CSV.
    Specs: main bus carries no fail-safe bias (THVD2410 is fail-safe on its
    own), EN filter cap value and voltage rating, layout rules drop the
    termination/bias footprin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
    [BOM.csv, BOM_MainController.xlsx]
2026-09-26 NodeLib: move the module type out of ConfigStore into NodeLib::ModuleType
    ConfigStore::Module becomes a standalone NodeLib::ModuleType enum in
    EModuleType.h, used by ConfigStore, NodeMaster, the bootloader OTA slave
    and MainController's BudgetAllocator/UplinkHandler. Wire bytes and the
    32-byte ConfigRecord are unchanged. Its operator<< prints an out-of-range
    value (straight off an Announce) as its raw number.
2026-09-26 Thermostat: one fixed link id, baked into flash-full instead of provisioned
    Every Thermostat now carries the same ConfigRecord (nodeId =
    NodeLib::THERMOSTAT_NODE_ID = 1, module Thermostat) so any unit is a
    drop-in replacement, rather than sharing its ControllerNode's provisioned
    id. The record is generated at build time and merged into
    thermostat-full.hex (new add_stm32_executable FIXED_NODE_ID, value read
    from Id.h), so the bootloader's OTA slave / USART2 select and the
    Announce/SystemInfo module byte keep working off ConfigStore unchanged.
    LinkMaster's peer id is the constant; provision.py refuses thermostat.
    Specs and tools README updated.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
    [ThermostatHandlerTests.cpp, ThermostatLinkTests.cpp, gen_config_record.py, provision.py]
2026-09-26 ControllerNode: drive the damper servo PWM, bring-up test plan
    Hal::Pwm drives TIM3_CH1 at 50 Hz with a 1 us tick (register-level,
    prescaler derived from the timer clock). Damper maps 0..100 % linearly
    onto 500..2500 us (the DS3225's 180 deg) -- no per-unit trim, the 2.5:1
    linkage and the mechanics set the end points. The pulse is set just
    before the servo rail comes on and held low whenever it is off.
    ParkNeutral() now actually moves to 50 % before cutting power, blocking
    for the move since the reset follows.
    Adds FakePwm + Damper tests, the linkage note to the hardware spec, and
    Spec/ControllerNode-Bringup-Test-Plan.md listing what to check when real
    ControllerNode hardware arrives.
    Co-A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
    [Damper.cpp, Damper.h, DamperTests.cpp, FakePwm.cpp, FakePwm.h]
2026-09-26 Show Red error led when losing connection
    [UplinkHandler.cpp, UplinkHandler.h]
2026-09-26 feat: add MainController thermostat support and change-driven publishing
    add ThermostatStatus (0x63) publishing on the MainController side
    route module 4 OTA jobs, including pre-flight current-version check and force re-flash
    add fixed-size Node Publisher with change thresholds, staggered 60s keepalives, reconnect republish, and clearing
    publish ControllerNode thermostat room values, damper state, RoomLink, and budget
    update TemperatureNode and Thermostat to use shared publishing
    stop publishing stale sensor values when probes are missing
    remove per-module last-reported bookkeeping and custom keepalive timers
    add publisher and module coverage for change detection, encoding, reconnects, keepa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
    [ControllerHandler.cpp, ControllerHandler.h, ControllerHandlerTests.cpp, DuctChannel.cpp, DuctChannel.h, DuctChannelTests.cpp, TemperatureHandler.cpp, TemperatureHandler.h]
2026-09-26 switch modules to 64 MHz system clock
2026-09-26 OTA: windowed pushes to bus nodes, bootloader stages writes until Poll
    Bus-node pushes were stop-and-wait: one 32-byte chunk per ~140 ms round
    trip, the cadence at which the NINA stops forwarding, so nearly every
    push stalled and reconnected (35-84 B/s). The server now keeps 4 chunks
    in flight for bus nodes (otaNodeWindow; Thermostat pushes stay at 1).
    The node bootloader holds incoming Writes in RAM and programs them only
    when its Poll arrives -- programming flash stalls the CPU, and chunks
    arriving back to back lost bytes to a USART overrun -- and queues one
    Ack/Nack per chunk (8 entries) instead of a single slot.
    Bench, node 3: ~305-320 B/s, 1-3 retries, no link drops across four
    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
    [FirmwareSlave.cpp, FirmwareSlave.h, FirmwareSlaveTests.cpp]
2026-09-26 Disable Bluetooth in the NINA for more WiFi stability
    [ScriptedNina.h]
2026-09-26 Update LED handling
2026-09-27 Uplink: never drop frames the NINA TX buffer can't take; 24-line log ring
    NinaLink::DrainOutboundQueue() wrote every queued frame in one pass and
    then cleared the queue, but the application's NINA port is a 128-byte
    TX ring that refuses a frame that doesn't fit -- and that refusal was
    ignored. A burst (hello + roster + Thermostat status + log lines right
    after connecting, or a window of OTA acks with log traffic) lost every
    frame past the first ~128 bytes, which is where the MainController's
    boot/bring-up log lines went. NinaPort::WriteBytes() now reports whether
    the bytes were taken (the MainBootloader's blocking port always is), and
    the drain stops at the first frame that doesn't fit and k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
    [FakeNinaUart.cpp, HalNinaPort.cpp, HalNinaPort.h, NinaUart.cpp, NinaUart.h, UplinkHandler.cpp, UplinkHandler.h]
2026-09-27 NINA stall rig: bare-module UART->TCP test, spec open item updated
    Software/tools/nina_stall_test.py drives the NINA-W152 directly over a
    USB-TTL adapter (MainController running NinaEnable) and plays the TCP
    server itself: numbered requests every N ms, echoed back over the UART,
    a stall flagged when requests keep reaching the UART but no reply comes
    back. Wi-Fi credentials are read from the MainController's Secrets.h and
    never printed. Each run restarts the module and waits for the network to
    settle before connecting.
    The rig no longer reproduces the stall on the same module and firmware:
    130/160/200/250 ms for 5 min each with Bluetooth off and on, plus one
    unbroken hour at 130 ms, ~41,000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
    [nina_stall_test.py]
2026-09-27 Fix nodeid index in budget allocator
    [BudgetAllocator.cpp, BudgetAllocator.h]
2026-09-27 Move towards safe state when supply temperature is unknown
2026-09-27 Spec: open item for the 49.7-day uptime-seconds wrap
    Every uptimeSec field is Millis() / 1000, which drops from 4,294,967 s
    back to 0 when the ms tick wraps. Control timing is wrap-safe, but the
    reported uptime then reads as a fresh boot and the server's 24-bit
    log-line age arithmetic misreads lines straddling the drop. Recorded in
    Node-Message-Model-Spec.md §8 as a decision to make: leave it, or add a
    monotonic seconds counter to Hal::Tick.
2026-09-27 MainController answers SystemStatus / DiagLastError for itself
    UplinkHandler answers node-0 SystemStatus, DiagLastError and DiagReset
    over the uplink with the same payloads a bus node uses (shared Node
    builders), and Nacks any other relayed-range frame for node 0 instead of
    putting it on the bus. The server asks for both on every connect of the
    MainController app, stores/publishes them under node 0 without adding it
    to the bus roster, and the status page shows start time, reset cause and
    last fault. Drops the vague supervisory TODO; MainController-Spec §2 now
    describes the actual split with the server, Server-Link §5.2 documents
    the node-0 requests.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
    [UplinkHandler.cpp, UplinkHandler.h, main.cpp]
2026-09-28 Hardware: pre-order review fixes for ControllerNode and Thermostat
    Thermostat:
    - Q3 (FDN338P) source/drain swapped so the OLED VBAT switch can turn off
    (source on the 3.8V rail, drain on VBAT, as in the datasheet reference)
    - F1 now a 1206L020YR PTC; R6 10k pull-down on OLED RES#
    - H6 debug header DNP (it sat on the display/front face)
    - Activity LED KT-0805Y (low Vf); ground-pour keep-out around the CHT40
    ControllerNode:
    - U14 servo PWM buffer now SN74AHCT1G126 (TTL inputs accept 3.3V GPIO)
    - F2 1206L020YR PTC on the +5V feed to the Thermostat connector
    - Activity LED KT-0805Y; power LED KT-0805G (dim by design)
    Specs updated to match: Thermostat regulators (RT9080 + 3.8V VBAT LDO and
    s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
    [BOM.csv]
2026-09-28 Spec: baud rate is chosen for signal-integrity margin, not clock tolerance
    UART clock-mismatch tolerance is a percentage of the bit period, so the HSI16 spread doesn't favour 115200 over 250000/500000. State the real reason instead: reflection settling on the ~100 m single-end-terminated bus, the untwisted Thermostat link cable, transceiver headroom, and CPU cycles per byte in the 16 MHz bootloaders. 250000 is the step up if ever needed.
2026-09-28 Webserver: map markers independent of floor plan resolution, duct temps
    The map overlay's viewBox is the floor plan's native pixel size, so node
    dots and labels were drawn in image pixels and came out tiny on a
    high-res plan and huge on a small one. Marker sizes are now screen px
    times the viewBox-units-per-screen-px factor (--k in CSS), recomputed on
    resize.
    Each node now shows "current - setpoint" centered above its dot and the
    room name (config.json node name) centered below it. The map gets a
    Supply/Return duct temperature readout in the top-left corner.
2026-09-28 TemperatureNode: tighten 1-Wire read timing, reject DS18B20 85 degC
    DelayUs() did a software divide (no HW divide on M0+) on every call,
    adding ~1 us per delay and pushing the 1-Wire read sample to ~16-17 us,
    past the 15 us window. Timestamp first, cache ticks-per-us, and trim
    ReadToSampleUs to 6 us (recovery +2 us keeps the 70 us slot).
    Reject the +85 degC power-on scratchpad value, which passes CRC when a
    conversion never ran (brown-out / parasite power).
    [Ds18b20.cpp, Ds18b20.h, Ds18b20Tests.cpp]
2026-09-28 Hardware: Gerber + pick-and-place exports, layout review fixes
    Add Gerber and pick-and-place exports for ControllerNode and Thermostat.
    ControllerNode layout:
    - Q1 source gets two extra +5V vias to the L3 plane (servo stall current
    no longer goes through a single via)
    - INA180 IN- (U17 pin 4) Kelvin-connected to R22's GND pad by its own
    trace, kept out of the pour; R22 pad 2 solidly connected to the pour
    Spec: Thermostat PCB orientation (bottom side is the front, OLED flex wraps
    the notched edge, KEY1 on-board bottom disc, KEY2 external mesh on U3),
    the CHT40 slotted island, and the flex-fold check to do on a real module.
    [PickAndPlace.xlsx]
2026-09-30 Spec: damper mechanics (Lindab DRU, 2.2:1 linkage)
    New Damper-Mechanics-Spec.md: the installed Lindab DRU damper and how the
    ControllerNode servo mounts on and drives it (ring clamped around the cup,
    fork on the knob). Linkage is now 2.2:1, about 82 deg of blade travel;
    hardware spec, bring-up plan and CLAUDE.md index updated to match.
2026-09-30 Thermostat OTA: make the relayed push work end to end
    ControllerNode (ThermostatLink / LinkMaster):
    - The bootloader only Announces in reply to a Discover, and the periodic
    one (5 s) was slower than the 4 s enter-bootloader timeout. Re-Discover
    every 500 ms while waiting (LinkMaster::Rediscover()).
    - Track the Thermostat's real bootloader state from its Announce, Status
    and the 1-byte Ack/Nack to Begin/End/Abort; report it always, and send
    an unsolicited ThermostatFirmware Status whenever it changes. Before, the
    CN reported "app" throughout, so the server never saw Receiving/Valid.
    - A link timeout no longer fails an OTA in flight: Begin's app-slot erase
    keeps the peer silent lon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
    [ControllerHandler.cpp, ThermostatLink.cpp, ThermostatLink.h, ThermostatLinkTests.cpp]
2026-10-01 ControllerNode: slew damper moves, explicit Off/Moving/Settling/Stalled state
    The servo was handed the target pulse directly, so every move ran at the
    DS3225's full speed. Loop() now walks the pulse from the last commanded
    position to the target at a full stroke per 4 s, one servo frame at a time,
    then holds power for a 300 ms settle. The last pulse is kept across power-off
    so re-energising never jumps; a stall rewinds it to where the overcurrent
    began. ParkNeutral() is bounded by a static_assert against the watchdog.
    [ControllerHandlerTests.cpp, Damper.cpp, Damper.h, DamperTests.cpp, RoomControlLoopTests.cpp]
2026-10-04 Damper actuator: printed drive design + mechanics spec to match
    Add the Tinkercad STL exports, assembly renders and site photos under
    Hardware/Damper/. Rewrite Damper-Mechanics-Spec.md for this design: a
    two-part ring seated on the cup's rolled flange and keyed into its
    cutout, a 6908ZZ bearing carrying the fork, and 20:42 sector gears at
    2.1:1 (98.5 mm centre distance, ~86 deg blade travel, ~0.5 deg
    backlash). Update the hardware spec, bring-up plan and CLAUDE.md index
    for the new ratio and travel.
    [DamperDrive_Bearing_retainer.stl, DamperDrive_BigGear.stl, DamperDrive_Clamp.stl, DamperDrive_MainClamp_and_servo_mount.stl, DamperDrive_Pinoin.stl, DamperDrive_SmallGear.stl]
2026-10-04 TemperatureNode: per-probe calibration offsets, settable over the bus
    Add SupplyTempOffset (0x3B) and ReturnTempOffset (0x3C), RW int16
    centi-degC limited to +-10.00 degC. The node adds the offset to every
    raw DS18B20 reading and keeps both offsets in a CRC-protected record in
    the runtime settings page (Config B, now Board::Flash::SettingsBase),
    so they survive resets, OTA and re-provisioning. A Set is range-checked,
    persisted only when the value changes, and answered with a Report of
    the stored value (Nack on bad range, short payload or flash failure).
    Server: endpoints mirrored in internal/nodelib (offsets encoded with
    rounding), refilled on rejoin, settable via /api/commands but not held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
    [Calibration.cpp, Calibration.h, CalibrationTests.cpp, DuctChannel.cpp, DuctChannel.h, DuctChannelTests.cpp, FakeFlash.cpp, FakeFlash.h]
2026-10-04 Damper budget as a [min, max] range, dump room, minimum total opening
    The HVAC unit's fan always runs, so the dampers must never all close.
    DamperBudget now carries max(1) [min(1)]: max is the room's fair share as
    before, min is raised by the MainController when the rooms together would
    open less than minTotalOpenPercent (200 = two dampers' worth on top of
    the uncontrolled branch). The shortfall goes to the dump room first, then
    to the rooms the extra air harms least; a min above max wins on the node.
    The 1-byte form still works both ways (min 0).
    New DumpRoom endpoint (0x34), persisted on the ControllerNode through a
    shared NodeLib::SettingsPage record in Config B (TemperatureNode's probe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
    [BudgetAllocator.cpp, BudgetAllocator.h, Calibration.cpp, Calibration.h, ControllerHandler.cpp, ControllerHandler.h, ControllerHandlerTests.cpp]
2026-10-04 0.16: Thermostat OTA bootloader-entry race; no fake room readings
    Thermostat OTA: the app announces "in the bootloader" just before it
    resets, and the ControllerNode sent Begin on that Announce -- mid-reset,
    so Begin was lost and the bootloader sat idle ("did not enter bootloader
    / begin" while the Thermostat's LEDs showed bootloader mode). The first
    such Announce is now only a hint: the CN rediscovers and sends Begin on
    the bootloader's own answer.
    Room readings: the Thermostat started from a 21.00 degC / 45 %RH
    placeholder and reported it for ever when no sensor answered. It now
    reports temperature and humidity only after a real reading, drops them
    after 3 failed reads (Get Nacked 0x05, d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
    [BudgetAllocator.cpp, BudgetAllocator.h, ControllerHandler.cpp, ThermostatHandler.cpp, ThermostatHandler.h, ThermostatHandlerTests.cpp, ThermostatLink.cpp]
2026-10-04 0.17: Thermostat version query, Begin resend, stale measurements expire
    ControllerNode: nothing ever asked the Thermostat for SystemInfo, so its
    version was never known (the server showed "?" for every Thermostat).
    The CN now sends a link Get SystemInfo whenever the app is up on the
    link and hasn't answered since it (re)appeared, every 5 s until it does.
    Server: a Thermostat push sends Begin up to 3 times, 20 s apart, before
    failing -- the ControllerNode may still be rebooting from its own update
    queued just before, and a Begin that reached nobody was never answered.
    Server: the live cache dropped nothing, so a dead sensor's last reading
    stayed on screen for ever. Measurements (RoomTemp, R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
    [ThermostatLink.cpp, ThermostatLink.h, ThermostatLinkTests.cpp]
2026-10-04 0.18: a room without data goes to neutral instead of being squeezed shut
    A ControllerNode with no valid room data (no Thermostat, or its
    temperature stopped arriving) only kept its damper inside the budget
    range, and MainController gave such a room weight 0 -- so another room's
    demand could cut its max to 0, closing it, and nothing reopened it once
    the budget recovered (seen on the bench: node 2, no Thermostat, at 0%).
    Such a room now gets the same fail-safe as a missing supply reading
    (Damper-Budget-Spec.md §4.4): the room loop goes to neutral (50%)
    inside its [min, max], and BudgetAllocator keeps it at the default 50%
    max outside the demand split and counts it at min(50, max) in the
    mini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
    [BudgetAllocator.cpp, BudgetAllocator.h, RoomControlLoop.cpp, RoomControlLoopTests.cpp]
2026-10-11 Thermostat UI rework; ControllerNode pushes heating/cooling as AirMode
    Display: room temperature larger and centred, setpoint bottom-left and
    humidity with a real % sign bottom-right, damper position as a 2 px
    full-width bar along the bottom edge. Top-right status icon: X while the
    link is down, otherwise a flame (heating) or snowflake (cooling). Target
    square and degree mark removed. Icons are string-art glyphs drawn with
    the new Ssd1306::DrawGlyph(); Ssd1306::NumberWidth() for centring and
    right-aligning numbers.
    New endpoint AirMode = 0x35 (0 unknown, 1 heating, 2 cooling): the
    ControllerNode's RoomControlLoop derives it from supply vs. room
    temperature (NodeLib::UpdateAirMode, 0.3 degC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
2026-10-11 change flame to heating icon
2026-10-22 0.19: Thermostat buttons swapped, -2 degC self-heating offset
    The first Thermostat boards have the touch buttons the other way round:
    PA11 (button 1) is now setpoint up, PA12 (button 2) setpoint down.
    The CHT40 reads ~2 degC above the room from the board's own heat (MCU,
    regulators, OLED). ThermostatHandler::RoomTempOffsetCentiDegC (-200) is
    added to every reading before it is shown or reported; the simulator's
    sensor adds it back, so its room temperature still matches the panel.
2026-10-22 Webserver: map colours readable at room temperatures
    The blob colour blended green straight into red, through brown-grey --
    exactly the 22-25 degC band real rooms sit in. An amber stop at 23.5
    degC (also in the legend) keeps the warm half colourful. Rooms without
    a reading are drawn first, so an offline room's grey outline can no
    longer veil a neighbour that has one.
2026-10-22 0.20: re-push the Thermostat display after it reboots
    ThermostatLink sent DamperActual/DamperMode/AirMode only on change or
    after ConnectionLost(). A Thermostat OTA or reset finishes within the
    link timeout, so the link never drops; the fresh app's display cache is
    empty and an unchanged damper (e.g. held at 100 % by its budget min) was
    never sent again -- no damper bar, no heating/cooling icon. Every app
    Announce (each boot, and every periodic Discover) now forgets what was
    pushed, so all three go out again.
2026-10-22 0.21: Thermostat at 16 MHz and sleeping; RoomTempOffset stored per unit
    The fixed -2 degC offset read ~1 degC low once the boards settled: the
    2 degC measured at first was a board still warm from handling, the lit
    panel and the update. Steady-state self-heating is ~0.9 degC, and how
    much extra heat there is varies.
    Less heat: the Thermostat stays at the reset-default 16 MHz instead of
    64 MHz and sleeps (new Hal::System::Sleep(), WFI) between loop passes.
    Hal::I2c now derives TIMINGR's prescaler from SystemCoreClock, so the
    bus keeps its ~98 kHz at either clock.
    New endpoint RoomTempOffset = 0x45 (int16 centi-degC, +-10.00), stored
    in the Thermostat's settings page and added to every readin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
2026-10-22 0.22: log what the servo current sense saw on every move
    Calibrating stallThresholdCounts needs the INA180 readings during real
    moves, and reading ADC1_DR over J-Link halts the MCU mid-move. Every
    powered move now ends with one DiagLog line:
    Srv <from>><to> pk<peak> av<mean> ov<ms>
    peak/mean in raw ADC counts over every sample while powered, ov the
    longest unbroken stretch at or above the threshold -- the quantity the
    stall decision rests on (a stall is ov reaching stallConfirmMs), so a
    free move's ov is its margin. Stalled moves log it too. The bring-up
    plan reads it from the node log instead of J-Link.
2026-10-22 Webserver: room setpoint is a plain Set, editable from its current value
    The setpoint row's "Set & hold" held a value the Thermostat's own buttons
    change anyway, and the card made a second Set hard: the field was empty
    (the spinner started at its min, 10 -- one room ended up held at 10.5,
    re-sent on every rejoin), and every presence/fault redraw reset it to the
    held value, throwing away what was typed.
    - RoomSetpoint is no longer held by the server (heldByServer()), never
    re-asserted, and a store migration drops any held by an older build.
    - The setpoint and thermostat-offset fields start at the node's reported
    value and follow it, unless the user is editing them; Set can be sent
    any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
2026-10-27 provision.py: interactive prompts and optional flash-full
    - With --node-id / --module left out, an interactive run asks for them
    (device menu ControllerNode / TemperatureNode, then the node id);
    a non-interactive run still requires both.
    - --flash-full runs `make flash-full` for the module right after the
    config page is written (--build-type Debug for a debug unit),
    --no-flash-full skips it, and with neither an interactive run asks.
    flash-full only loads the bootloader + app sectors, so the config
    page survives it.
    - gen_config_record.py follows NodeLib::MAX_NODES = 22 and accepts
    node ids 1..MAX_NODES, matching ConfigStore::Valid() -- it was still
    capping at 1..20.
    Co-Autho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
